2AMLogic/sg13g2-ldo/sim/ldo-cmos5l-pvt-sweep/README.md

# ldo-cmos5l-pvt-sweep

Per `CLAUDE.md`: **verification is the product, no claim without a
testbench**, PVT corners on every recorded result, and results here are
**append-only evidence** -- a re-run mints a new, timestamped record; nothing
under `records/`, `netlist-snapshots/` or `corners/` is ever edited or
deleted after it lands. This follows the same per-experiment shape
`sim/README.md` establishes and `sim/pass-device-screening/` already uses on
the SG13G2 branch.

## What this is

The **first circuit-level (closed-loop) PVT verification** in this repo, on
either PDK branch. `sim/pass-device-screening/` characterizes `sg13_hv_pmos`
as a bare device; this experiment instantiates the actual
`design/sg13cmos5l/ldo_core_cmos5l.sch` netlist (issue #20: pass device +
real two-stage Miller-compensated OTA error amp) and verifies it against a
spec table re-derived at SG13CMOS5L's rails -- phase 3/4 of the SG13CMOS5L
port tracked by #12 (issue #21).

**This block sits entirely on the Challenge #6 brief's 3.3V analog rail**
(`design/README.md` "Rails and the Challenge #6 slot budget" -- every
device is an HV, 3.3V-class flavour; there is no 1.2V node anywhere in this
hierarchy), so "re-derived at this PDK's 1.2V/3.3V rails" reduces to
re-deriving the SG13G2-branch DRAFT table (`README.md`) at the same 3.3V
input / 1.8V output pair, on this PDK's own devices -- not a rail
translation.

## Benches

Three testbenches, generated from templates by `run_sweep.sh`:

1. **`testbench/tb_dcsweep_cmos5l.spice.tmpl`** -- closed-loop, whole
   `ldo_core_cmos5l` instantiated directly (no flattening). A single nested
   DC sweep (`Vin` 2.00V-3.63V step 10mV, fast/inner axis; `Iload`
   0/12.5m/25m/37.5m/50m A, 5 evenly-spaced points, slow/outer axis) gives:
   - **Iq**: `|i(vin)|` at the `Iload=0` block, `Vin=3.30V` row.
   - **Dropout @ 50mA**: scan the `Iload=0.05A` block from `Vin=3.63V`
     downward for the first point where `VOUT` falls below 99% of the
     1.8V target; `dropout = that Vin - 1.8V`. If regulation is never lost
     across the whole swept range, dropout is reported as
     `> 1.63V` (worse than the sweep's own floor, `dropout_v_50ma_floor`
     in the CSV) rather than fabricated.
   - **Line regulation**: `Iload=0` block, slope of `VOUT` vs `Vin` over
     the Input row's own `{2.97V, 3.63V}` window -- measured at no load,
     not the light-nonzero-load point an earlier draft of this bench
     planned (see the template header for why: Iq itself is only ~17uA and
     does not meaningfully load the divider/pass device differently).
   - **Load regulation**: `Vin=3.63V` (best-case headroom) rows across all
     five `Iload` points -- see "Why Vin=3.63V for load regulation" below.
   - **Feedback-divider standing current** (since issue #31):
     `|i(vdivsense)|` at the `Iload=0` block, `Vin=3.30V` row, plus the
     per-leg resistance it implies. Read off a non-invasive replica of the
     divider -- an ideal unity-gain VCVS copy of `VOUT` driving a
     byte-identical pair of `rhigh` legs through a 0V ammeter -- because
     ngspice cannot report a branch current inside a subcircuit instance
     whose device is an OSDI `r3_cmc`. The replica draws nothing from
     `VOUT` and sits on a disjoint node set, so `Iq` and every other
     measured quantity stay directly comparable to the #21/#25 records.
2. **`testbench/tb_loopgain_cmos5l.spice.tmpl`** -- loop broken at `FB`
   (the feedback-divider node driving the amp's `INP` pin, a MOSFET gate)
   for an AC phase/gain-margin sweep. See "Loop-gain measurement method"
   below for the full derivation of why a plain series voltage-source break
   is valid here (no inductor/capacitor blocking network needed).
3. **`testbench/tb_psrr_cmos5l.spice.tmpl`** -- closed-loop, whole
   `ldo_core_cmos5l`, 1V AC stimulus on `Vin` (`Vref`'s AC component held
   at 0), `PSRR_dB(f) = -20*log10(|v(vout)/v(vin)|)`.

All three share: `VREF=0.90V` DC (the schematic's own illustrative bias,
`design/README.md` "Reference voltage" -- `Rtop=Rbot` by construction gives
`FB=VOUT/2`, so `0.90V` servos `VOUT` to `1.80V`; since #28 both legs are
the same drawn PDK `rhigh`, so that ratio is exactly 1/2 independent of
sheet rho and therefore of the resistor corner), `IBIAS` externally sunk at
`2uA` (the bias point `design/README.md`'s "Judgement calls" section 1
assumes: tail=2x, second stage=4x that reference), `Cout=1uF` (a first-cut
point inside the DRAFT table's `0.33-4.7uF` output-cap window, `ESR=0`).

## Loop-gain measurement method

Breaking a feedback loop for a SPICE AC loop-gain measurement normally
needs an L/C blocking network (a large inductor across the break to
preserve the DC operating point, a large capacitor in series with the AC
injection source to avoid disturbing it) -- **not needed here**, because the
break point (`FB` -> the amp's `INP` pin) sits at a MOSFET gate: zero DC or
AC current flows across it, both before and after the break.

Insert an ideal series source `Vbreak` (`0V` DC, `AC=1`) between `FB` (the
real feedback-divider node, resistively determined by `VOUT`) and `FBAMP`
(the node that actually drives the amp's `INP` pin). Because:

- `FBAMP` carries zero current (its only two connections are `Vbreak` and
  a MOSFET gate), the current through `Vbreak`'s branch is zero at both
  ends, so `FB`'s value is unaffected by the break -- `FB = beta * VOUT(s)`
  exactly as in the unbroken circuit (`beta` = the divider ratio); and
- `VOUT(s) = G(s) * FBAMP(s)` for some forward transfer function `G(s)`
  encompassing the whole amp + pass-device path (`VREF`'s AC component is
  held at 0, so it does not contribute),

algebra gives `FB(s) = T(s) * FBAMP(s)` for the identical loop-gain
transfer function `T(s) = beta * G(s)` an unbroken loop would have --
independent of the injection detail. `T(s)` is therefore read directly off
one AC analysis as the ratio of two node voltages:

```
Loop Gain L(s) = -v(fb)/v(fbamp)
```

(sign flipped from the raw `T(s)` so a healthy negative-feedback loop shows
a large **positive** real `L(0)`, phase near 0 degrees at DC, rolling
toward -180 degrees at the unity-gain crossover -- the standard Bode-plot
convention `phase margin = 180 + phase(L)` at the frequency where `|L|=1`
(0dB) is stated against). Verified against a fully independent circuit
simulator run before committing to this method: the closed-loop DC
operating point (`tb_dcsweep_cmos5l`) and the flattened, loop-broken DC
operating point agree to 5 significant figures (`VOUT=1.800208V` both ways
at `tt/27C`, no load), confirming the break does not perturb the bias
point.

`XMpass`/`XRtop`/`XRbot`/`Xamp`'s instantiation lines in
`tb_loopgain_cmos5l.spice.tmpl` are a byte-for-byte mirror of
`ldo_core_cmos5l`'s subckt body in the generated design netlist (`FB` ->
`FBAMP` on `Xamp`'s first pin, plus the inserted `Vbreak`, excepted).
`run_sweep.sh`'s `assert_loopgain_topology_sync()` diffs the two every run
and aborts loudly if a future schematic edit changes that connectivity, so
this bench cannot silently go stale.

## Why Vin=3.63V for load regulation

The schematic's provisional `Mpass` sizing (`w=300u l=0.5u`,
`design/README.md`: "a DC-sanity first cut ... not sized against any
dropout ... target") does **not** hold regulation at 50mA at every `Vin` in
this sweep -- see "Results" below. `Vin=3.63V` (the best-case, max-headroom
supply point) is the *only* point in the grid where the design stays in or
near regulation across the full load range at most corners, so it is the
cleanest available load-regulation measurement; it is not the nominal
3.30V supply datasheets conventionally use, and that departure is
deliberate, not an oversight.

## PDK pin, corner naming, and the resistor/cap corner axes

Pinned SG13CMOS5L revision: [`sim/pdk-cmos5l.json`](../pdk-cmos5l.json)
(commit `607e18d`, re-verified against the installed checkout, matching the
commit issue #21's body cited). `cornerMOShv.lib` at this pin is **byte-for-
byte identical** to `ihp-sg13g2`'s own copy (`diff` clean) -- confirming,
directly against the installed model library rather than by assumption,
that the five-corner naming scheme (`mos_tt`/`mos_ss`/`mos_ff`/`mos_sf`/
`mos_fs`) `spec/porting-plan.md` Sec 1.2 already bound for SG13G2 transfers
unchanged to SG13CMOS5L. This is expected, not coincidental:
`design/README.md` "Install shape is a dispatch hazard" already documents
that this PDK's HV device symbols and model cards are relative symlinks
into a sibling `ihp-sg13g2` checkout.

**`cornerRES.lib` and `cornerCAP.lib` do NOT share this five-corner scheme**
-- both use a three-point `{typ, bcs (best case), wcs (worst case)}` axis,
independent of the MOS process corner.

**Resistor corner: crossed in full since issue #31.** Every `(MOS corner,
temperature)` point is run against all three of `res_typ`/`res_bcs`/
`res_wcs`, giving a 45-point main grid. The axis is swept *independently* of
the MOS corner rather than correlated to it: **no established
MOS-corner/R-corner correlation convention exists in this repo** (an
`ss`-process-correlates-with-`res_wcs` mapping would need its own decision
record, argued on foundry data), and crossing the axes in full reports every
combination instead of inventing one. `DR-0004` ratifies this as the
experiment's standing policy -- a future record that holds the resistor axis
at nominal is a regression against it.

*Why it was not always so, and what that cost:* the `#21` and `#25` records
held the main grid at `res_typ` and characterised the resistor spread
separately at `tt/27C` only, via `loopgain_rzsens_{bcs,typ,wcs}`. That was
defensible when `Rz` was the loop's only `rhigh` and the feedback divider
was a corner-independent behavioural 300k pair -- but the separate
experiment ran at one temperature, and the loop's phase-margin failure needs
`res_bcs` *and* `125C` together. Crossing the axes surfaced it immediately.
The `tt/27C` sensitivity experiment is retained (renamed `res_corner`, since
since #28 it moves the divider as well as `Rz`) as a cross-check on the main
grid's new axis, not as the primary resistor evidence.

**Cap corner** is still held at `cap_typ`, for the different and stronger
reason below: selecting a cap corner on this PDK is a literal no-op.

## MoM-cap (Cc) sensitivity sweep

`cornerCAP.lib` at this pin maps **every** `cap_typ`/`cap_typ_mismatch`/
`cap_typ_stat`/`cap_bcs`/`cap_wcs`/`cap_wcs_mismatch` section to the exact
same nominal `cap_cmomi.lib` include (verified directly, not assumed --
see [`sim/pdk-cmos5l.json`](../pdk-cmos5l.json) `pdk_caveats_honoured`).
Per `cap_cmomi.lib`'s own header, this is because the model is **"NOT YET
VALIDATED ON ihp-sg13cmos5l SILICON"**: its coefficients are transferred
from the SG13G2 characterization by layer count, none measured on cmos5l
silicon. A *process-corner* sweep over `Cc` is therefore a no-op by
construction -- `design/README.md`'s own "PDK caveats honoured" table
already anticipated this and said the sweep this issue owes is a **value**
sensitivity sweep, not a corner sweep.

`run_sweep.sh` generates three frozen copies of the design netlist with
`Cc`'s width scaled `{0.5x, 1x (nominal), 2x}` (capacitance scales
~linearly with area for this device, `l` held fixed) and runs the loop-gain
bench against each, at `tt/27C` (`records/*.sensitivity.csv`,
`sweep=cc_value`). These three points are retained unchanged, and are
row-comparable back to the #21 record -- at #21 they showed phase margin
moving only from `0.35deg` (0.5x) to `0.19deg` (2x), i.e. that the
*near-zero* margin of the original compensation was not an artifact of the
uncharacterized `Cc` value.

**Since issue #35 they are no longer the load-bearing evidence for the
robustness claim, and the `Cc` value-tolerance sweep below is.** They run
at `tt/27C`, which was near this loop's worst case until #31 crossed the
resistor corner and found `res_bcs`/125C (DR-0004). At `tt/27C` every spec
row now passes with tens of degrees and dB to spare, so a `{0.5x,1x,2x}`
sweep there would report PASS at `0.5x` while `0.5x` in fact misses
`PM >= 45deg` at `res_bcs`/125C. Reporting that as evidence of robustness
would be a hollow claim.

### `Cc` value-tolerance window (issue #35)

What the uncharacterized-cap caveat actually needs is a measured answer to
"how wrong may the cap value be, in either direction, before a ratified row
fails" -- so `run_sweep.sh` measures exactly that. `Cc`'s width is swept
across `{85, 110, 130, 170, 220, 259, 340}e-6` at **`ss`/125C**, against
**both** resistor sections that hold a worst case (`res_bcs` for phase
margin, `res_wcs` for gain margin), with **both** the loop-gain and PSRR
benches run at every point. Output:
`records/*.cc-tolerance.csv`, plus a table in the record itself.

`Cc` is bounded on both sides by ratified spec rows, which is why both ends
have to be measured:

- **too small** and the `Rz*Cc` phase-lead zero lands above crossover at
  `res_bcs`/125C (where `Rz` has shrunk to `~0.60x`), failing `PM >= 45deg`;
- **too large** and the Miller-split dominant pole -- and with it the 1 kHz
  loop gain that sets PSRR there -- drops far enough to fail
  `PSRR@1kHz > 50dB`.

At the current `w=170e-6` nominal the measured window is
`110e-6`-`259e-6`, i.e. **x0.65 to x1.52** of nominal with every spec row
still met at both binding corners; `85e-6` (x0.50) fails on phase margin
and `340e-6` (x2.00) on PSRR. Both failing widths are kept in the sweep on
purpose -- a tolerance window with no measured ends is not a tolerance
window. `DR-0005` uses this measurement to place the nominal at the
*geometric centre* of the window rather than at the first value that
passed.

Every phase-margin/loop-gain number in `records/*.csv` is still marked
`insufficient-evidence` per issue #21 acceptance criterion 4 -- the
*absolute* numbers are not independently trustworthy pending real silicon
characterization -- but the qualitative verdict does not depend on that
caveat, and now has a measured tolerance band attached to it rather than an
assertion.

## Results (issue #128, loop-gain sweep to 10 GHz -- current)

Question: DR-0014 could not score any row-10 point because no committed
loop-gain trace bounded its 100 MHz sweep ceiling. Does a higher ceiling
change that? Answer: no. The 10 GHz traces are not bounded either, so all 45
points stay `ambiguous` (`ceiling_unbounded`). No rule, threshold or bound
was changed.

Command (batch only; the host runs no SPICE):

    sim/ldo-cmos5l-pvt-sweep/run_sweep.sh --batch --loopgain-ac-max=10g

`--loopgain-ac-max=<f>` (or `SWEEP_LOOPGAIN_AC_MAX`) is the one input. It
defaults to `100meg`, which renders the historical `ac dec 20 1 100meg`
unchanged. It must be an exact power of ten between 1 kHz and 1 THz above the
fixed 1 Hz floor, with 20 points per decade (`ac_sweep.py`, tested by
`test_ac_sweep.py`). It is rendered into `tb_loopgain_cmos5l.spice.tmpl` as
`@@LG_AC_MAX@@`, and the loop-gain row count is derived from it (201 rows at
10 GHz, 161 at 100 MHz). Every loop-gain trace is also checked for its first
and last frequency, so a wrong-range sweep with the right row count fails
screening. The psrr bench keeps `ac dec 20 1 100meg`. The record md states
the ceiling and row count. `--doe-generate` refuses a non-default ceiling.

Record: [`records/20261011-070111-5391c68.md`](records/20261011-070111-5391c68.md)
and its siblings (same file set as the #89 record). It re-ran the full grid
on the same design netlists (core `08a7b857...bae57`, erramp `75ee39ce...56fb4`)
on the EDA batch fleet: 22 `klt sim` requests, all Spot, none reused, 214/214
points passed, completeness OK. Job ids are in
`corners/20261011-070111-5391c68/_batch/backend.json` (the 45-point main
loop-gain request is `g01_loopgain_tt_-40c_rtyp`, job `klt-sim-a559517f5a05`).
Only the loop-gain traces changed: every DC and PSRR column of the PVT csv is
identical to `20261011-051956-eda9285`, and the item-5 DC summary is
byte-identical. In the PVT csv only `n_0db_crossings` and
`phase_margin_worst_deg` differ, because the extended traces have more
crossings.

Measured, 45 of 45 points (`evidence/20261011-070111-5391c68/row10-margins.*`,
written by `row10_record.py`):

| Quantity | Value |
|---|---|
| Loop gain at 1 GHz | +0.90 to +1.65 dB |
| Loop gain at the 10 GHz ceiling | +0.40 to +1.17 dB |
| Change over the last decade | -0.56 to -0.43 dB |
| Phase at 10 GHz | -14.0 to -11.7 deg |
| 0 dB crossings | 2 at every point (first falling, second rising at 59 to 179 MHz) |
| In-band PM (first crossing) | 53.87 to 76.93 deg |
| In-band GM (one -180 deg crossing) | 13.84 to 29.87 dB |
| PM / GM verdicts | 45 ambiguous / 45 ambiguous, all `ceiling_unbounded` |
| Pass / fail / ambiguous | 0 / 0 / 45 for PM and for GM |

Reading. Above the in-band crossing the loop gain comes back up through 0 dB
at 59 to 179 MHz and then flattens near +1 dB with its phase near 0 deg. It
drifts down only about 0.5 dB per decade, so it would take on the order of 20
more decades to reach -10 dB. The ceiling premise cannot be met by raising
the ceiling further, and 10 GHz is already well beyond any frequency at which this repo
has validated the PSP103, `rhigh` or `cap_cmomi` models, so no higher ceiling
was attempted. The values above 1 GHz are numerically complete traces, not
validated physics, and they are not used for any pass.

What this does not show. The flat, phase-near-zero plateau is the signature
DR-0014 and `tb_loopgain_cmos5l` already name for a single-injection break
at a MOSFET gate, but it was not tested here and the cause is not
established. Only a measured two-injection (Middlebrook/Tian) comparison can
say whether it belongs to the circuit or to the measurement. That bench is
filed as separate work; it was not built here.

## Results (issue #89, G1 disable pull-down)

Record cited: [`records/20261011-051956-eda9285.md`](records/20261011-051956-eda9285.md),
with its [`.csv`](records/20261011-051956-eda9285.csv),
[`.sensitivity.csv`](records/20261011-051956-eda9285.sensitivity.csv),
[`.cc-tolerance.csv`](records/20261011-051956-eda9285.cc-tolerance.csv),
[`.delta.csv`](records/20261011-051956-eda9285.delta.csv) and
[`.divider-attribution.csv`](records/20261011-051956-eda9285.divider-attribution.csv).
`214/214` points passed and the completeness matrix is OK, all on the EDA
batch fleet. The design under test adds an `EN` pin to `ldo_erramp_cmos5l`
and an inverter plus a 1 x 1 um NMOS pull-down on `G1`, so `Mn3` is off
when disabled (DR-0008 addendum "G1 disable pull-down"). Core sha256
`08a7b857...bae57`, erramp `75ee39ce...56fb4`; both are stated in the record
md. `EN` is tied to `VIN`, so the pull-down is off in every bench.
`BASELINE_CSV` moved to the #67 record `20261010-025634-60a3e81`, so the
delta table isolates the three added devices.

The added devices change the enabled state by small amounts, all in the
expected direction. Phase margin, gain margin and PSRR @ 100 kHz fall at
every point and no-load Iq rises or stays the same. The largest change per
metric:

| Metric | Largest change vs 60a3e81 | Point |
|---|---|---|
| Phase margin | -0.0021 deg | `sf`/-40C/`res_wcs` |
| Gain margin | -0.0086 dB | `ss`/-40C/`res_wcs` |
| Unity-gain frequency | +8.0 Hz | `ff`/-40C/`res_wcs` |
| DC loop gain | -2.0e-5 dB | `ff`/125C/`res_wcs` |
| PSRR @ 1kHz | -1.1e-5 dB | `fs`/-40C/`res_typ` |
| PSRR @ 100kHz | -1.6e-4 dB | `sf`/125C/`res_wcs` |
| Iq, no load | +0.043 nA | `ff`/125C/`res_wcs` |
| VOUT, no load | -0.84 uV | `ff`/125C/`res_typ` |

Dropout is identical at every point. Line and load regulation move by at
most 1.5e-5 mV/V and 5.7e-7 %. All 45 points still meet every row in the
record's own spec comparison table. That table uses the legacy first-crossing
PM/GM scalars, and it is not the row-10 verdict. Under DR-0014 (proposed),
row 10 PM and GM are each 45 `ambiguous`, 0 pass and 0 fail (reason
`ceiling_unbounded`), the same as for `60a3e81`. The evidence is
`evidence/20261011-051956-eda9285/row10-margins.*`, written by
`row10_record.py`. Each row's worst case is at the same point as
before, the same 15 points have more than one 0 dB crossing, and the `Cc`
tolerance window is unchanged at `110e-6`-`259e-6`. The worst gain margin
is now 13.84 dB (was 13.85) and the worst phase margin 53.87 deg.

Four of the 22 fleet requests (`g00_dcsweep`, `g01_loopgain`,
`g02_loopgain_ressens_bcs`, `g21_loopgain_divattr`) reuse completed reports
from an interrupted first submission (`SWEEP_BATCH_REUSE_WORK`, listed in
`corners/20261011-051956-eda9285/_batch/reused-reports.tsv`). The other 18
were resubmitted.

**Reuse is now bound to input bytes, but these four are not.** The request
text names the design netlist, the model cards and the OSDI binaries by path,
so a byte-identical request alone does not show those files are unchanged.
`batch_backend.py` now writes `inputs.sha256.json` into every group dir when
the group is written: the sha256 of the transitive `.include` / `.lib`
closure of `tb.spice` and `corners.lib` (design netlist included) plus the
OSDI binaries. `--reuse-work` reuses a report only when the earlier group's
inventory equals the current one, and fails closed when the earlier work dir
has none. `test_batch_backend.py` has the negative controls: an in-place edit
of the design netlist, a nested include, a model card or an OSDI binary, with
all four compared text files left identical, is not reused. The earlier work
dir for this record predates the inventory, so the four reports above have no
committed proof of the input bytes they ran against. Indirect evidence
(PM, GM and Iq differ from `60a3e81` at the points of those groups) says they
are post-edit, but it does not prove it. Closing that gap is a fleet
resubmission of those four groups without `--reuse-work`, appended as new
evidence rather than an edit to this record; it is tracked in a follow-up
issue and is not done here.

The disabled state is not part of this grid. It is in
`sim/ldo-cmos5l-enable/` (DC smoke, tt/27C) and in the off-state samples of
the startup record `20261011-031426-df3f802` (`startup_offstate.py`, all 135
points); see the DR-0008 addendum.

## Results (issue #67, `EN` interface -- superseded by #89 above)

Record cited: [`records/20261010-025634-60a3e81.md`](records/20261010-025634-60a3e81.md),
with its [`.csv`](records/20261010-025634-60a3e81.csv),
[`.sensitivity.csv`](records/20261010-025634-60a3e81.sensitivity.csv),
[`.cc-tolerance.csv`](records/20261010-025634-60a3e81.cc-tolerance.csv),
[`.delta.csv`](records/20261010-025634-60a3e81.delta.csv) and
[`.divider-attribution.csv`](records/20261010-025634-60a3e81.divider-attribution.csv).
`214/214` simulation points passed and the completeness matrix is OK. This is
the first record made with `run_sweep.sh --batch`: every point ran on the EDA
batch fleet, none on the dispatch host (see "Batch backend" below).

The design under test is the #67 core with the active-high `EN` port
(DR-0008), with `EN` tied to `VIN` in all three benches. The core netlist is
sha256 `7953b25b...222cc1` and the erramp is unchanged (`7982d728...c8e38c`).
The record md states both hashes. The before/after/delta table is now
against the last pre-`EN` record, `20260917-023832-7061e8f` (the #35 record
below), at the same `(MOS corner, temperature, resistor section)` point on
both sides.

**The enable devices change nothing measurable in the enabled state.** The
largest change at any of the 45 points is:

| Metric | Largest change vs 7061e8f | Point |
|---|---|---|
| Phase margin | -0.015 deg | `ff`/-40C/`res_wcs` |
| Gain margin | -0.023 dB | `ss`/27C/`res_typ` |
| Unity-gain frequency | -6.7 Hz | `ff`/125C/`res_wcs` |
| DC loop gain | -0.0015 dB | `ff`/125C/`res_typ` |
| PSRR @ 1kHz | -0.0010 dB | `ff`/125C/`res_bcs` |
| PSRR @ 100kHz | -0.0008 dB | `ff`/125C/`res_wcs` |
| Iq, no load | -0.43 nA | `ff`/125C/`res_bcs` |
| VOUT, no load | -0.46 uV | `ff`/125C/`res_wcs` |

Dropout, line regulation and load regulation are unchanged to the printed
precision. All 45 points meet every row in the spec comparison table, and
the same 15 points have more than one 0 dB crossing as before. The `Cc`
tolerance window is unchanged at `110e-6`-`259e-6` (x0.65-x1.52). The binding
points are the same as in the #35 worst-corner summary below. A few ranges
under #35 move in the last printed digit: phase margin is now
53.87-76.93 deg (was 76.94 at the top), gain margin 13.85-29.87 dB (was
13.87-29.89; the worst point, `ff`/-40C/`res_wcs`, keeps a 3.85 dB margin),
and PSRR @ 100kHz 33.23-36.99 dB (was 37.00 at the top). Every other figure
there is unchanged to the digits shown.

What this record does **not** cover: the disabled state (`EN` low), which is
the single-corner smoke evidence in `sim/ldo-cmos5l-enable/` (DR-0008); any
layout, DRC, LVS or extraction of the `EN`-bearing design (#68); and the
Monte Carlo bench, which still instantiates the five-port core (#88).

## Batch backend (`run_sweep.sh --batch`, PR #87)

Dispatch hosts do not run SPICE grids locally. `--batch` keeps every part of
the harness (decks, screening, post-processing, record) and changes one step:
the simulator runs on the EDA batch fleet. `batch_backend.py` turns each
generated per-point deck into a `klt sim --backend batch` request. Its
docstring has the full translation. Points with the same body share one
request (214 points in 22 requests).

- `.lib` cards go into a generated `corners.lib` section, staged with
  `options.stage_model_inputs` from the local PDK install. The
  `.options temp=` line becomes klt's temperature axis.
- **OSDI.** The runner image lacks `cap_cmomi`, and the runner's klt 0.5.0
  ignores `options.osdi_preload` (klayout-tools#2901). The six local OSDI
  binaries are therefore staged with every job through `osdi_preload`, and a
  body-level preamble loads them with `pre_osdi inputs/<name>.osdi`. Every
  per-point log prints their sha256, and `corners/<id>/_batch/backend.json`
  lists them. The backend refuses to run if a runner ever applies
  `osdi_preload` itself, which would load each binary twice.
- **Data.** The deck's `wrdata` vectors are rebuilt from the corner's ASCII
  rawfile (`options.waveforms`). Loop gain and PSRR are recomputed from the
  complex node voltages with the templates' own `let` expressions, which must
  match the known text exactly. The output is written in `wrdata`'s
  `% .8e` layout, so `dc_metrics.py`, `item5_evidence.py` and the inline
  post-processing read it unchanged.
- **Validated byte-for-byte.** Six points (all three benches at `tt`/27C/
  `res_typ` and `ss`/125C/`res_bcs`) were run through the backend against
  the pre-#67 templates and netlist. They reproduced the local ngspice-46
  files of record `20260917-023832-7061e8f` exactly. See
  [`backend-validation/20261010-025044/`](backend-validation/20261010-025044/README.md).
- **Sparse corner sets and per-point lines (issue #64).** A request's
  (section, temperature) pairs no longer have to form a cross product. The
  pairs nobody asked for go into klt's `exclude` list, which the 0.5.0
  runner honours. `--variant-lines REGEX` moves matching body lines
  (the DoE's `Iload`/`Cout`/`Resr`) verbatim into each point's own
  `corners.lib` section, so decks that differ only in those lines share one
  request. Only the `--doe-generate --batch` path passes it. The main grid's
  plan is unchanged: 214 points in 22 requests, none of them excluded. The
  results were cross-checked byte for byte on the fleet; see
  [`backend-validation/20261010-variant-lines/`](backend-validation/20261010-variant-lines/README.md).
- A failed submission is reported, and its points are screened as FAILED.
  The backend never falls back to a local ngspice run.
- Provenance for each record is in `corners/<id>/_batch/`: one directory per
  request with `request.json`, `tb.spice`, `corners.lib`, the klt
  `report.json` (`environment.remote.job_id`) and the exact `*.corner.cir`
  each point ran. Rawfiles (~1 MB per corner) are not committed.
  `SWEEP_BATCH_PLAN_ONLY=1 run_sweep.sh --batch` prints the request plan
  without submitting anything.

## Results (issue #35, `Cc` re-compensation -- superseded by #67 above, numerically unchanged)

**Every ratified spec row is met at every one of the 45 grid points.** The
`res_bcs`/125C phase-margin gap #31 found is closed by a single-parameter
change to the error amplifier's Miller cap -- `Cc` `w` `100e-6` ->
`170e-6`, with `Rz`, both bias mirrors, `Mpass` and every other device
unchanged. Full lever study (including the two rejected levers, `Rz` and
the bias mirrors, both measured over the full grid), the derivation of the
value from the measured `Cc` pass window, and the one row that pays for it:
[`spec/decision-records/DR-0005-sg13cmos5l-cc-recompensation.md`](../../spec/decision-records/DR-0005-sg13cmos5l-cc-recompensation.md).

Record cited: [`records/20260917-023832-7061e8f.md`](records/20260917-023832-7061e8f.md),
with [`.csv`](records/20260917-023832-7061e8f.csv) (45-point PVT x resistor
grid), [`.sensitivity.csv`](records/20260917-023832-7061e8f.sensitivity.csv),
[`.cc-tolerance.csv`](records/20260917-023832-7061e8f.cc-tolerance.csv) (new
-- see "`Cc` value-tolerance window" above),
[`.delta.csv`](records/20260917-023832-7061e8f.delta.csv) and
[`.divider-attribution.csv`](records/20260917-023832-7061e8f.divider-attribution.csv).
`214/214` simulation points passed; completeness matrix OK.

### Spec table at this record

Before/after is against the #31 record at the **same** `(MOS corner,
temperature, resistor section)` on both sides -- same benches, same PDK
pin, same ngspice build -- so the deltas isolate the `Cc` change and
nothing else.

| Parameter | Target | #31 (before) | #35 (this record) | Verdict |
|---|---|---|---|---|
| Output accuracy | 1.8V +/-2% | 1.80023V-1.80066V | 1.80023V-1.80066V | **PASS** (unchanged) |
| Dropout @ 50mA | < 300mV worst corner | 0.20V-0.24V | 0.20V-0.24V | **PASS** (unchanged) |
| Line regulation | < 5 mV/V | 0.162-0.246 mV/V | 0.162-0.246 mV/V | **PASS** (unchanged, no-load only -- see caveat) |
| Load regulation | < 1% over full load | 0.0076%-0.025% | 0.0076%-0.025% | **PASS** (unchanged) |
| Iq, no load | < 30uA | 21.72uA-24.72uA | 21.72uA-24.72uA | **PASS** (unchanged) |
| PSRR @ 1kHz | > 50dB | 58.20dB-61.87dB | 53.64dB-57.37dB | **PASS**, margin down 4.56dB -- the cost, see below |
| PSRR @ 100kHz | > 20dB | 32.58dB-36.81dB | 33.23dB-37.00dB | **PASS** (slightly improved) |
| Stability: phase margin | >= 45 deg worst corner | 43.35deg-73.25deg (**FAIL** 5/45) | 53.87deg-76.94deg | **PASS** (was FAIL) |
| Stability: gain margin | >= 10dB worst corner | 13.83dB-29.76dB | 13.87dB-29.89dB | **PASS** (unchanged) |
| Current limit | 65-80mA brickwall | n/a | n/a | **not implemented** |
| Startup | monotonic ramp, <2% within 3ms | n/a | n/a | **not implemented** |
| Enable/shutdown | -- | n/a | n/a | **not implemented** |

"Unchanged" on the first five rows is meant literally, and that is a result
rather than luck: `Cc` carries no DC current, so every DC-sweep metric (Iq,
dropout, line and load regulation, output accuracy) and the loop's DC gain
are analytically invariant under any change to it. Checked cell by cell
against the #31 CSV: `vout_no_load_v`, `dropout_v_50ma`,
`line_reg_mv_per_v`, `load_reg_pct`, `i_divider_a` and `r_divider_leg_ohm`
are byte-identical at all 45 points, while `iq_a` differs by at most
`1e-13 A` and DC loop gain by at most `0.0004 dB` -- the DC solve's own
numerical noise. Had any of them moved by a physically meaningful amount,
something other than `Cc` would have changed.

### The one row that pays

Worst-corner PSRR @ 1kHz falls `4.56dB`, from `58.20dB` to `53.64dB`
against a `50dB` row -- from `8.2dB` of margin to `3.6dB`. A larger Miller
cap lowers the dominant pole, and the loop gain at 1 kHz *is* what rejects
supply ripple there. This is not a late discovery: it is the bound that set
the value (`DR-0005` decision (b)), and it is why `Cc` is `170e-6` rather
than the `220e-6`-`259e-6` that would have bought another 5-8 degrees of
phase margin. **PSRR @ 1kHz is now the second-tightest row on this block**,
behind gain margin's `3.87dB`; anything that lowers the dominant pole
further has to be checked against it first.

### Worst-corner summary, all 45 points

| Row | Worst value | Binding point | Margin |
|---|---|---|---|
| Phase margin | 53.87deg | `ss`/125C/`res_bcs` | +8.87deg |
| Gain margin | 13.87dB | `ff`/-40C/`res_wcs` | +3.87dB |
| PSRR @ 1kHz | 53.64dB | `ss`/125C/`res_wcs` | +3.64dB |
| PSRR @ 100kHz | 33.23dB | `ff`/27C/`res_bcs` | +13.23dB |
| Iq, no load | 24.72uA | `ss`/125C/`res_bcs` | +5.28uA |
| Dropout @ 50mA | 0.24V | `ss` @ 125C | +60mV |

`res_wcs` was checked explicitly, because a fix that trades one resistor
corner for another is the obvious way to pass this gate dishonestly: phase
margin improves at `res_wcs` too (`tt`/125C: `62.87deg` -> `71.30deg`), and
gain margin -- the row `res_wcs`/cold holds the worst case on -- improves
marginally rather than degrading.

### What changed in the harness

- **New `Cc` value-tolerance experiment** (see above): 7 widths x
  `{res_bcs,res_wcs}` x `{loopgain,psrr}` = 28 points at `ss`/125C, written
  to `records/*.cc-tolerance.csv`. Point count per run goes `186` -> `214`.
- **Before/after/delta re-baselined** from the #25 record to the #31 one,
  and re-keyed on `(corner, temperature, res_section)`. The #25 record held
  the resistor axis at `res_typ`, so it has no `res_bcs`/`res_wcs` rows to
  compare against -- and `res_bcs`/125C is precisely the point at issue.
  The metric list also widened from five metrics to every spec row.
- **`Cc`'s nominal width is now a single `CC_NOMINAL_W` variable**, used by
  both the sensitivity substitution and its FATAL guard, so the two cannot
  drift apart when the value moves again.

## Results (issue #31, PDK `rhigh` divider + full resistor-corner cross -- superseded in part by #35 above)

> **Superseded in part.** This record's Finding 1 (the `rhigh` divider
> conversion is harmless) stands unchanged and is not re-litigated. Its
> Finding 2 -- `PM < 45deg` at `res_bcs`/125C -- is the gap issue #35
> closed; see "Results (issue #35)" above and `DR-0005`. The tables below
> are what this run measured and are not retro-edited.

**The `rhigh` divider conversion is harmless, as #28 predicted. Crossing the
resistor corner, which this run did for the first time, found something
else: phase margin misses the ratified `>= 45deg` row at `res_bcs`/125C, at
all five MOS corners.** Full argument, mechanism, options considered and the
decision not to relax the spec:
[`spec/decision-records/DR-0004-sg13cmos5l-resistor-corner-stability.md`](../../spec/decision-records/DR-0004-sg13cmos5l-resistor-corner-stability.md).

Record cited: [`records/20260916-210331-9d3ace1.md`](records/20260916-210331-9d3ace1.md)
(run manifest, before/after/delta tables, the mechanical spec gate, and the
divider-attribution table), with
[`records/20260916-210331-9d3ace1.csv`](records/20260916-210331-9d3ace1.csv)
(45-point PVT x resistor grid),
[`.sensitivity.csv`](records/20260916-210331-9d3ace1.sensitivity.csv),
[`.delta.csv`](records/20260916-210331-9d3ace1.delta.csv) and
[`.divider-attribution.csv`](records/20260916-210331-9d3ace1.divider-attribution.csv).
`186/186` simulation points passed; completeness matrix OK.

### What changed in the harness

This is the first run against the post-#28 design netlist, and the first to
sweep `cornerRES.lib` across the whole grid rather than holding it at
`res_typ`:

- **Resistor corner crossed in full**: `{tt,ss,ff,sf,fs} x {-40,27,125}C x
  {res_typ,res_bcs,res_wcs}` = 45 points x 3 benches. Every point id, every
  snapshot filename and every CSV row names its own section, so no reader
  has to infer which corner produced a number. The axis is swept
  *independently* of the MOS corner, not correlated to it -- this repo still
  has no ratified correlation convention, and crossing in full reports every
  combination rather than inventing one.
- **Divider standing current measured per point**, from a non-invasive
  replica in `tb_dcsweep_cmos5l.spice.tmpl`: an ideal unity-gain VCVS copy
  of `VOUT` driving a byte-identical pair of `rhigh` legs through a 0V
  ammeter. It loads neither `VOUT` nor `i(vin)`, so `Iq` stays directly
  comparable to the #21/#25 records.
- **Divider attribution sweep**: the loop-gain bench re-run at all 45 points
  with the divider swapped *back* to the pre-#28 behavioural 300k pair and
  everything else held identical, so `Rz`'s corner spread cancels and what
  is left is the conversion's own contribution.
- **Mechanical spec gate**: the record now evaluates the root `README.md`
  spec table against its own CSV, so a record cannot claim a PASS its data
  contradicts.
- **`Warning: singular matrix` is no longer treated as a failure.** ngspice
  emits it while walking its own convergence-aid ladder and then reports
  `Dynamic gmin stepping completed` and a converged result; 9 of this grid's
  points do so (the #21/#25 runs never did -- the `rhigh` divider adds
  internal nodes to the DC solve). They are counted and named in the record
  rather than discarded. To keep this from being a net loosening, the pass
  criterion also gained a *positive* check it never had: every point must
  have written exactly the row count its own analysis statement implies.

### Finding 1: the divider conversion itself is harmless

Measured, not argued -- the attribution sweep above, across all 45 points:

| Metric | Worst contribution of the `rhigh` conversion |
|---|---|
| Phase margin | `-0.53deg` (at `ff`/-40C/`res_wcs`); `>= -0.31deg` at `res_typ` |
| Gain margin | `+/-1.16dB` |
| DC loop gain | `-0.19dB` |
| PSRR @ 1kHz | below display resolution at `res_typ` |

At the five points that miss the phase-margin spec, the conversion's
contribution is `+0.00deg` to `+0.01deg` -- it is not a contributor there.

What the conversion does change is the divider's own standing current: a
corner-independent `3.00uA` before (an ideal 600k across 1.8V) becomes
`1.97uA`-`4.82uA` across the PVT x resistor grid. Total no-load `Iq` moves
from `21.87-22.98uA` to `21.72-24.72uA` -- still inside the `30uA` spec at
every point.

### Finding 2: PM < 45deg at `res_bcs`/125C

| MOS corner @ 125C | `res_bcs` | `res_typ` | `res_wcs` |
|---|---|---|---|
| `tt` | **43.93deg** | 54.91deg | 62.87deg |
| `ss` | **43.35deg** | 54.35deg | 62.42deg |
| `ff` | **44.48deg** | 55.45deg | 63.31deg |
| `sf` | **44.19deg** | 55.18deg | 63.09deg |
| `fs` | **43.65deg** | 54.64deg | 62.65deg |

Five of 45 points, short by `0.5deg`-`1.7deg`. Every other spec row passes
at all 45 points. `Rz` -- not the divider -- is the mechanism: at
`res_bcs`/125C its sheet rho (`1020/1360` = `0.75x`) and its temperature
coefficient (`tc1=-2300e-6` over `98K` => `0.795x`) compound to `~0.60x`,
moving its nulling zero up in frequency so the phase boost arrives too late
at crossover. Gain margin is *best* at exactly that point (`29.76dB`),
which is the signature of a zero that moved rather than a loop that lost
gain; `res_wcs` moves the same knob the other way and improves phase margin.

No earlier record could have caught this: #21/#25 held the main grid at
`res_typ` and swept the resistor corner at `tt`/27C only, where `res_bcs`
costs `8.4deg` and still passes comfortably (`59.98deg`). The failure needs
the resistor corner *and* 125C together.

**The spec is not relaxed.** Per CLAUDE.md, the `PM >= 45deg` row stands as
ratified; DR-0004 records the narrowed verdict and defers re-compensation to
its own issue rather than changing `Cc`/`Rz` inside a verification run.

### Spec table at this record

| Parameter | Target | #25 (pre-conversion, `res_typ` only) | #31 (this record, 45-point grid) | Verdict |
|---|---|---|---|---|
| Output accuracy | 1.8V +/-2% | 1.80023V-1.80064V | 1.80023V-1.80066V | **PASS** |
| Dropout @ 50mA | < 300mV worst corner | 0.20V-0.24V | 0.20V-0.24V | **PASS** |
| Line regulation | < 5 mV/V | 0.162-0.245 mV/V | 0.162-0.246 mV/V | **PASS** (no-load only -- see caveat) |
| Load regulation | < 1% over full load | 0.0076%-0.025% | 0.0076%-0.025% | **PASS** |
| Iq, no load | < 30uA | 21.87uA-22.98uA | 21.72uA-24.72uA | **PASS** |
| Divider standing current | (not a spec row; part of Iq) | 3.00uA, corner-independent by construction | 1.97uA-4.82uA | n/a (newly measurable) |
| PSRR @ 1kHz | > 50dB | 58.21dB-61.85dB | 58.20dB-61.87dB | **PASS** |
| PSRR @ 100kHz | > 20dB | 33.82dB-35.28dB | 32.58dB-36.81dB | **PASS** |
| Stability: phase margin | >= 45 deg worst corner | 54.40deg-72.72deg | 43.35deg-73.25deg | **FAIL** at 5/45 points, all `res_bcs`/125C -- see DR-0004 |
| Stability: gain margin | >= 10dB worst corner | 17.07dB-25.87dB | 13.83dB-29.76dB | **PASS** |
| Current limit | 65-80mA brickwall | n/a | n/a | **not implemented** |
| Startup | monotonic ramp, <2% within 3ms | n/a | n/a | **not implemented** |
| Enable/shutdown | -- | n/a | n/a | **not implemented** |

The MoM-cap (`Cc`) `insufficient-evidence` caveat below still applies to
every loop-gain and margin number in this table, unchanged: `cornerCAP.lib`
maps every section to the same nominal `cap_cmomi` model at this PDK's pin.
The `Cc`-value sensitivity sweep was re-run at this record
(`sweep=cc_value`: phase margin `56.72deg`-`76.24deg` at `tt`/27C over the
`0.5x`-`2x` width range), and, as before, the qualitative verdict does not
depend on that caveat.

### PDK observation: `rhigh`'s symbol expression and its model disagree by 4.35%

This record's directly-measured per-leg divider resistance is **313.5 kOhm**
at `res_typ`/27C. `rhigh.sym`'s own `value` expression -- the source of the
`300.44 kOhm` figure `design/sg13cmos5l/ldo_core_cmos5l.sch`'s header and
`design/README.md` both quote -- gives `300.44 kOhm`. The difference is the
width offset applied twice: `resistors_mod.lib`'s `rhigh` subckt narrows the
width once (`weff = w - 0.04e-6`) and hands `W=weff` to the `r3_cmc` model
card, whose own `xw=-0.04` narrows it again. Every `rhigh` on this branch is
affected, `Rz` included (1.700 MOhm by the expression, `~1.774 MOhm` as
simulated). It is **not** a change introduced here -- the #21/#25 records
simulated the same model -- so no earlier result moves; see DR-0004's
"Separate observation" section.

## Results (issue #25, post-resize -- superseded in part by #31 above)

> **Superseded in part.** This section's evidence remains valid for what it
> measured -- the `res_typ` slice of the grid, against the pre-#28
> behavioural divider. Its "every spec row passes at every corner" headline
> does **not** survive the resistor-corner cross issue #31 ran: see
> "Results (issue #31)" above and DR-0004. The sizing and compensation
> topology DR-0003 ratified are unchanged and still correct everywhere
> except `res_bcs`/125C.

**Every spec row now passes at every corner.** Issue #25 resized `Mpass`
and re-derived the error-amp's `Cc`/`Rz` compensation network and bias
currents against the pre-resize evidence below (full derivation:
[`spec/decision-records/DR-0003-sg13cmos5l-mpass-resize-and-compensation.md`](../../spec/decision-records/DR-0003-sg13cmos5l-mpass-resize-and-compensation.md)),
then re-ran this same unmodified harness against the resized schematic.

Record cited: [`records/20260916-112842-c25ff53.csv`](records/20260916-112842-c25ff53.csv)
(main 15-point PVT grid) and
[`records/20260916-112842-c25ff53.sensitivity.csv`](records/20260916-112842-c25ff53.sensitivity.csv)
(Cc-value / Rz-corner sensitivity) -- see
[`records/20260916-112842-c25ff53.md`](records/20260916-112842-c25ff53.md)
for the full run manifest. `51/51` simulation points passed (ngspice exit
0, no convergence/model-load errors); completeness matrix OK.

| Parameter | Target | Before (#21, pre-resize) | After (#25, this record) | Verdict |
|---|---|---|---|---|
| Output accuracy | 1.8V +/-2% | 1.80022V-1.80040V | 1.80023V-1.80064V | **PASS** |
| Dropout @ 50mA | < 300mV worst corner | 1.29V-1.83V, 4/15 corners never regulate | 0.20V-0.24V (worst `ss/125C`), all corners regulate | **PASS** (was FAIL) |
| Line regulation | < 5 mV/V | 0.151-0.200 mV/V | 0.162-0.245 mV/V | **PASS** (no-load only -- see caveat below) |
| Load regulation | < 1% over full load | 0.021%-248%, 4/15 corners fail | 0.0076%-0.025% | **PASS** (was FAIL) |
| Iq, no load | < 30uA | 16.94uA-16.99uA | 21.87uA-22.98uA | **PASS** (higher due to raised bias currents, still well under target) |
| Iq, full load | < 30uA | not separable from the dropout failure | 23.05uA-23.08uA | **PASS** (newly measurable and passing) |
| PSRR @ 1kHz | > 50dB | 65.9dB-69.3dB | 58.21dB-61.85dB | **PASS** (reduced margin -- see DR-0003 "PSRR trade-off") |
| PSRR @ 100kHz | > 20dB | 35.8dB-40.6dB | 33.82dB-35.28dB | **PASS** |
| Stability: phase margin | >= 45 deg worst corner | 0.19deg-0.35deg | 54.40deg-72.72deg | **PASS** (was FAIL) |
| Stability: gain margin | >= 10dB worst corner | 4.0dB-5.4dB | 17.07dB-25.87dB | **PASS** (was FAIL) |
| Current limit | 65-80mA brickwall | n/a | n/a | **not implemented** (`design/README.md` "Known gaps": no current-limit circuit exists on this branch) |
| Startup | monotonic ramp, <2% within 3ms | n/a | n/a | **not implemented** (no soft-start circuit) |
| Enable/shutdown | -- | n/a | n/a | **not implemented** (no `EN` pin on this branch) |

Cc-value (`0.5x`-`2x` nominal) / Rz-corner (`res_bcs`/`res_typ`/`res_wcs`)
sensitivity, re-swept at the new nominal, `tt/27C`: phase margin
56.9deg-76.4deg, gain margin 18.6dB-23.5dB across both sweeps -- the PASS
verdict holds across the full sensitivity range tested, mirroring the
same "verdict does not depend on the uncharacterized `Cc` value" reasoning
the pre-resize FAIL verdict established (`cornerCAP.lib` still maps every
corner/mismatch/stat section to the same nominal `cap_cmomi` model at this
PDK's pin, so the *exact* numbers above remain `insufficient-evidence`
pending real CMOS5L MoM-cap silicon characterization, even though the
qualitative PASS verdict does not depend on that caveat).

**Line-regulation caveat**: measured at no load only (see "Benches" above
for why) -- unchanged from the pre-resize record.

No spec row required relaxation to reach this result, per CLAUDE.md's rule
that verification results are never relaxed to pass.

## Results (issue #21, pre-resize -- historical, kept for evidence provenance)

**This section is preserved unmodified as the append-only record of the
first verification pass** (`sim/` results are append-only evidence per
CLAUDE.md) -- the sizing it describes no longer matches the current
schematic; see "Results (issue #25, post-resize)" above for the current
state.

Record cited throughout: [`records/20260916-083154-7aa1d3f.csv`](records/20260916-083154-7aa1d3f.csv)
(main 15-point PVT grid) and
[`records/20260916-083154-7aa1d3f.sensitivity.csv`](records/20260916-083154-7aa1d3f.sensitivity.csv)
(Cc-value / Rz-corner sensitivity) -- see
[`records/20260916-083154-7aa1d3f.md`](records/20260916-083154-7aa1d3f.md)
for the full run manifest (PDK/ngspice versions, corner matrix, links).
`51/51` simulation points passed (ngspice exit 0, no convergence/model-load
errors); completeness matrix OK.

**Headline finding: the schematic's provisional sizing (both `Mpass` and
the error-amp's `Cc`/`Rz` compensation network, both explicitly flagged as
DC-sanity first cuts, never sized against a target, in `design/README.md`)
does not hold up under closed-loop PVT verification.** This is the expected
outcome of a first verification pass on unratified sizing, not a surprise
finding, and it is recorded here in full per CLAUDE.md's rule that
verification results are never relaxed to pass.

### Spec table, re-derived at this PDK's 3.3V analog rail

Verdict legend: **PASS** (met at every corner in the 15-point grid),
**FAIL** (missed at one or more corners, worst-corner value cited),
**insufficient-evidence** (the PDK caveat this row's own value depends on
has not been resolved yet), **not implemented** (no such circuitry exists
in this schematic increment -- `design/README.md` "Non-goals" / "Known
gaps").

| Parameter | Target (`README.md` DRAFT, port-parity baseline) | Result (this record) | Verdict |
|---|---|---|---|
| Output accuracy | 1.8V +/-2% | 1.80022V-1.80040V no-load, all corners (regulator-only, `VREF` ideal -- port-parity caveat, `spec/porting-plan.md` Sec 1.2) | **PASS** |
| Dropout @ 50mA | < 300mV worst corner | 1.29V-1.83V at 11/15 corners; **never reaches regulation** within the swept `Vin` range (> 1.63V) at `tt/125C`, `ss/27C`, `ss/125C`, `fs/125C` | **FAIL** (every corner; ~4-6x over target even at the best corner) |
| Line regulation | < 5 mV/V | 0.151-0.200 mV/V, no load, all corners | **PASS** (no-load only -- see caveat below) |
| Load regulation | < 1% over full load | 0.021%-248% at `Vin=3.63V` (best-case headroom); 11/15 corners stay under 1% (0.02%-0.63%) with comfortable margin, but the same 4 corners that never reach dropout regulation (`tt/125C`, `ss/27C`, `ss/125C`, `fs/125C`) also fail here (25%-248%) | **FAIL** (4/15 corners; worst-corner value governs the row verdict) |
| Iq, no load | < 30uA | 16.94uA-16.99uA, all corners | **PASS** |
| Iq, full load | < 30uA | not cleanly separable from the load-regulation failure above (several corners never reach a stable 50mA operating point to measure quiescent draw against) | **insufficient-evidence** |
| PSRR @ 1kHz | > 50dB | 65.9dB-69.3dB, all corners | **PASS** |
| PSRR @ 100kHz | > 20dB | 35.8dB-40.6dB, all corners | **PASS** |
| Stability: phase margin | >= 45 deg worst corner | 0.19deg-0.35deg (Cc-value and Rz-corner sensitivity range included), all corners/points tested | **FAIL** (every corner; essentially zero margin) -- **insufficient-evidence** on the exact number (MoM-cap `Cc` caveat), but the FAIL verdict itself does not depend on that caveat (see "MoM-cap sensitivity sweep" above) |
| Stability: gain margin | >= 10dB worst corner | 4.0dB-5.4dB, all corners/points tested | **FAIL** (every corner) -- same insufficient-evidence caveat on the exact number as phase margin |
| Current limit | 65-80mA brickwall | n/a | **not implemented** (`design/README.md` "Known gaps": no current-limit circuit exists on this branch) |
| Startup | monotonic ramp, <2% within 3ms | n/a | **not implemented** (no soft-start circuit) |
| Enable/shutdown | -- | n/a | **not implemented** (no `EN` pin on this branch) |

**Line-regulation caveat**: measured at no load only (see "Benches" above
for why); the DRAFT target does not itself specify a load point for this
row, but a load-dependent line-regulation number cannot be produced
honestly given the load-regulation failure already documented -- this is
noted rather than silently omitted.

### Binding corners

- **Dropout**: worst among the corners that do reach regulation is
  `sf/125C` (1.83V dropout), `fs/27C` (1.82V) close behind; four corners
  never reach regulation at all within the swept range and are strictly
  worse.
  Slow-and-hot corners (matching `sim/pass-device-screening`'s own binding-
  corner finding for the bare `sg13_hv_pmos` device) dominate, as expected.
- **Load regulation**: `ss/125C` is catastrophic (248% -- `VOUT` collapses
  to `-2.67V` at `Vin=3.63V`/`Iload=50mA`, a real consequence of driving an
  ideal current-sink load harder than the pass device can supply at this
  corner, not a simulation artifact -- independently reproduced in a
  standalone `.op` run outside the sweep).
- **Stability**: phase margin is essentially flat (~0.19-0.35 degrees)
  across every corner and every Cc/Rz sensitivity point tested -- this is
  not a corner-dependent marginal case, it is a compensation network with
  no margin budget at any point tested.

## Why this is still a useful record, not a wasted run

Per `spec/porting-plan.md` Sec 1.3's own framing (gf180-ldo's compensation
work took ten decision records of negative results before the loop was
actually stable across PVT), a first verification pass finding real gaps in
unratified, explicitly-provisional sizing is the expected, useful outcome
-- it is the concrete input the next sizing pass needs (implied pass-device
widths from `sim/pass-device-screening`'s own dropout data already
independently predicted this: `sim/pass-device-screening/records/20260909-220347-ed18110.csv`'s
`w1u_l0.5u` rows imply `1135um-2169um` for `300mV`/`50mA`, 4-7x the
schematic's drawn `300um` -- this experiment's closed-loop dropout failure
is consistent with, and adds circuit-level confirmation of, that earlier
bare-device finding).

#25 is the resizing pass this evidence motivated (`Mpass` width, and the
`Cc`/`Rz` compensation network) -- see "Results (issue #25, post-resize)"
above for the outcome; it was out of scope for this original
verification-only phase, and is captured in full in
[`DR-0003`](../../spec/decision-records/DR-0003-sg13cmos5l-mpass-resize-and-compensation.md).

## T1 item 5 evidence derivation and coverage inventory (issue #55)

`item5_evidence.py` re-derives, with no simulator and no PDK, from the
committed raw DC grids of record `20261010-025634-60a3e81`
(`corners/20261010-025634-60a3e81/dcsweep_*_dc.csv`, 45 independent MOS x
temperature x resistor points; the `EN` design, PR #87). Until #67 it read
record `20260917-023832-7061e8f`. That record's outputs under
`evidence/20260917-023832-7061e8f/` are kept unchanged as history.

- the record's own DC columns (it **fails** if they do not reproduce, so the
  raw grid and the committed record CSV cannot silently disagree);
- informational summaries the record never reported: full-load Iq (load
  current excluded: `|i(Vin)| - Iload`, Vin = 3.30 V), line regulation at each
  of the five swept loads, load regulation at 2.97 / 3.30 / 3.63 V. A value is
  *valid* only if both end points are within 1 % of 1.8 V; invalid, truncated
  or missing points stay in the counts;
- a ten-row coverage inventory against DR-0007.

```bash
python3 sim/ldo-cmos5l-pvt-sweep/item5_evidence.py           # write
python3 sim/ldo-cmos5l-pvt-sweep/item5_evidence.py --check   # byte-compare (CI)
python3 sim/ldo-cmos5l-pvt-sweep/item5_grid.py --check       # same, shared grid contract (CI)
python3 -m unittest discover -s sim/ldo-cmos5l-pvt-sweep -p 'test_*.py' -v
```

Grid completeness (#120): the live sweep and this analysis apply one
contract, `dc_grid.validate_file`. It checks for exactly five Iload blocks, each
with the full 2.00..3.63 V / 10 mV Vin sequence, and requires every value to be
finite. `item5_evidence.py` is pinned by sha256 in its own landed outputs, so
it is not edited. Instead, `item5_grid.py` rebinds its `split_blocks` to the
shared validator and runs it unchanged, which yields the same bytes. CI runs
both checks.

Outputs: `evidence/20261010-025634-60a3e81/{coverage-inventory.json,
coverage-inventory.md,dc-informational-summary.csv}`; inputs and their sha256
are listed in the JSON. `dc_metrics.py` is the DC parser extracted from
`run_sweep.sh`'s inline Python so both read the grid identically.

What this is **not**:

- It is not a `klt sim` envelope and item 5 in `signoff/` stays uncited.
  The raw grid now comes from `klt sim` batch requests (`run_sweep.sh
  --batch`), but those requests declare no limits, and the metrics are
  reduced outside klt, so they are measurement runs, not a corner-matrix
  envelope graded against the ratified spec. `klt sim`'s batch backend still
  refuses `models.pdk: ihp-sg13cmos5l`
  ([klayout-tools#2727](https://github.com/2AMLogic/klayout-tools/issues/2727)),
  so the runs rely on staged model inputs instead.
- It does not ratify any Open row. Only row 4 (dropout) is ratified, and its
  dropout is the **legacy** metric (lowest in-regulation grid Vin minus the
  fixed 1.8 V target); 36 of 45 points sit at the 0.20 V sweep floor and are
  upper bounds. The conventional `Vin - actual VOUT at 1 % loss` figure
  (informational column in the CSV; 0.2546 V at the worst resolved point) is
  not adopted: that definition is #70's. The SG13G2 branch has no closed-loop
  evidence (#71) and nothing here transfers to it.
- Full-load Iq resolution: the grid is printed to 9 significant digits, so
  Iq at 50 mA is quantized at 1e-10 A; ngspice's own convergence noise on a
  22 uA difference of two ~50 mA currents is not bounded beyond that floor
  by this data.
- Provenance: the record's git sha (`60a3e81`, a PR #87 branch commit) may
  not resolve after a squash merge. main's #64 changes were merged into the
  branch afterwards, and regenerating all 214 decks with the merged harness
  gives decks that are identical apart from comments. The snapshots `.include` the design by absolute worktree path. The record md does state both design netlist
  sha256 values, so netlist freshness is recorded for this record. (For the
  older `7061e8f` record it was inferred from the DR-0007 hash pins.)
  `run_sweep.sh`'s spec comparison table now labels every row's
  DR-0007 status (only dropout is a gate; the rest are informational); this
  affects future records only, existing records are unchanged.

## CI

**No CI job runs `run_sweep.sh --check-env` for this experiment yet**, unlike
`sim/pass-device-screening-check` (SG13G2 branch). `.github/workflows/ci.yml`
fetches `ihp-sg13g2` via `klayout-tools`' pinned `fetch-ihp-sg13g2.sh`; no
equivalent pinned fetch exists for `ihp-sg13cmos5l` in CI, because (per
`design/README.md` "Known gaps") it is a separate upstream repository
(`IHP-GmbH/ihp-sg13cmos5l`), not a variant directory inside the
IHP-Open-PDK tarball that script downloads -- already filed upstream as
`2AMLogic/klayout-tools#1929`. Until that lands, `--check-env` for this
experiment (like `--check` for the SG13CMOS5L schematic branch generally)
is a local/manual step, verified by this PR's author before submission
(see "Reproducing" below).

The separate, offline loop-gain topology guard **is** a CI gate (issue #94):
the `characterization-report` job runs
`sim/ldo-cmos5l-pvt-sweep/run_sweep.sh --check-topology-guard` on every
push/PR/manual run, with no `continue-on-error`. It exits before PDK and
ngspice setup, so it needs neither. It checks that the flattened core mirrored
in `testbench/tb_loopgain_cmos5l.spice.tmpl` (including `XMen`/`XMbdis`) still
matches the exported `ldo_core_cmos5l` netlist, then that each built-in
negative control mutation is rejected, so both connectivity drift and a
weakened guard fail CI. It writes no records, changes no signoff verdict, and
makes no PVT or spec-passing claim. It does not replace the missing PDK-backed
`--check-env` preflight described above, which remains local/manual.

## Reproducing

```bash
export PDK_ROOT=/path/to/pdk/parent   # containing BOTH ihp-sg13g2/ and ihp-sg13cmos5l/
PDK=ihp-sg13cmos5l sim/tools/build-osdi.sh   # one-time OSDI build for this PDK
sim/ldo-cmos5l-pvt-sweep/run_sweep.sh --batch   # dispatch hosts: every point on the batch fleet
sim/ldo-cmos5l-pvt-sweep/run_sweep.sh           # workstation with ngspice >= 46: local loop
sim/ldo-cmos5l-pvt-sweep/run_sweep.sh --check-env   # syntax-check only, no records written
```

`--batch` needs `klt` (client 0.7.0 was used for record
`20261010-025634-60a3e81`) with batch-fleet credentials, plus the six OSDI
binaries built locally. They are staged, not loaded, on the submitting host,
so its own ngspice version does not matter.

Requires `ngspice >= 46` (OSDI ABI v0.4, see `sim/README.md`) and both
`ihp-sg13g2`/`ihp-sg13cmos5l` installed under the same `PDK_ROOT`
(`design/README.md` "Install shape is a dispatch hazard").

## Dynamic DoE: load x Cout x ESR (issue #64)

**Status: the 384-run matrix and one round of midpoint refinement (688
more runs) have been run on the EDA batch fleet. This is exploratory
evidence. It does not ratify or change DR-0007 rows 3, 6 or 10, and it makes
no monotonicity or continuous-window claim.** The records are
`20261010-091123-a31c626` (base matrix) and `20261010-101245-6df50fd`
(refinement, analysed together with the base). See "What was actually run
for #64" below for the results, the failures and the limits.

The runs go through `run_sweep.sh --doe-generate --batch`, which uses the
same staged-model-input batch path as the main grid (see "Batch backend"
above). `klt sim` still refuses `models.pdk: ihp-sg13cmos5l` on its batch
backend
([klayout-tools#2727](https://github.com/2AMLogic/klayout-tools/issues/2727)).
That route is not needed here.

### What this is (and is not)

DR-0007 leaves rows 3 (load), 6 (PSRR) and 10 (stability) Open because the
committed dynamic evidence is a single operating point: 1 mA, 1 uF, 0 ohm ESR.
The target window is 0-50 mA, 0.33-4.7 uF effective Cout, 0-500 mohm ESR.
This DoE is **exploratory**. It reports measured extrema and trends at sampled
discrete points only. It does not prove monotonicity, does not bound the
continuous window, does not cover unsampled PVT corners, and does not
interpolate between levels.

### Matrix

| axis | levels |
|---|---|
| load | 0, 1, 25, 50 mA |
| effective Cout | 0.33, 1.0, 2.2, 4.7 uF |
| ESR (series with Cout) | 0, 250, 500 mohm |

= 48 operating points, at each of four PVT/resistor corners taken from the
DR-0007 evidence at `4d45f5d` (2026-10-10; re-derive from the current record
before relying on them):

| corner | why |
|---|---|
| `ss` / 125 C / `res_bcs` | phase-margin binding |
| `ff` / -40 C / `res_wcs` | gain-margin binding |
| `ss` / 125 C / `res_wcs` | PSRR @ 1 kHz binding |
| `ff` / 27 C / `res_bcs` | PSRR @ 100 kHz binding |

Both benches (loop gain, PSRR) at every point: 4 x 48 x 2 = **384** AC
simulations before refinement. Failed or missing points stay in the
completeness accounting.

Targets (informational comparison only): PM >= 45 deg, GM >= 10 dB, PSRR @ 1 kHz
> 50 dB, PSRR @ 100 kHz > 20 dB.

### Parameterisation

`tb_loopgain_cmos5l` and `tb_psrr_cmos5l` take `@@LOAD_A@@`, `@@COUT_F@@`,
`@@COUT_BOTTOM@@` and `@@ESR_LINE@@` through `run_sweep.sh`'s `gen_netlist`
(optional args 9-11; the defaults 1 mA / 1u / 0 ohm render the legacy lines).
ESR is a series resistor `Resr` from a private node `COUT_ESR` to ground with
`Cout` between `VOUT` and that node. ESR = 0 wires `Cout` straight to ground and
emits a comment: no zero-valued resistor is ever written. Load 0 renders
`Iload VOUT 0 dc 0`.

Operating-point values are exact integers in base units (uA, nF, mohm) so
formatting cannot collide IDs. Point IDs:
`<bench>_dyn_<mos>_<temp>c_r<res>_i<uA>ua_c<nF>nf_e<mohm>mohm`, shared by the
snapshot netlist, the `corners/` AC CSV and log, and the record row.
`dynamic_doe.py` rejects negative load/Cout/ESR, zero Cout, non-numbers and
values that are not integral in base units; the plan fails on ID collisions.
The AC parsers were extracted verbatim from this script into `ac_metrics.py`
(one interpretation for the legacy post-processing and the DoE). The
`assert_loopgain_topology_sync` check is unchanged.

### Reproduction

```
# base matrix: 384 netlists, 2 klt sim batch requests (one per bench), then analyse + refine
sim/ldo-cmos5l-pvt-sweep/run_sweep.sh --doe-generate --batch
# one refinement round: only the requested midpoints, analysed with the base record
SWEEP_BATCH_MAX_POINTS=115 SWEEP_BATCH_CONCURRENCY=3 \
  sim/ldo-cmos5l-pvt-sweep/run_sweep.sh --doe-generate --batch \
    --doe-extra=$PWD/sim/ldo-cmos5l-pvt-sweep/records/<base>.dynamic-doe.refine.json \
    --doe-only-extra --doe-base=<base>
sim/ldo-cmos5l-pvt-sweep/run_sweep.sh --doe-generate  # generate-only: netlists + manifest, NO simulation
python3 sim/ldo-cmos5l-pvt-sweep/dynamic_doe.py plan  # bench, id, mos, res, temp, load, cout, esr
```

`--doe-generate` renders `netlist-snapshots/<record>/*.spice` through the
same `gen_netlist` as the main grid. It writes
`records/<record>.dynamic-doe.manifest.tsv`, with one row per point: netlist
path and sha256, the invocation, repo git sha, PDK and ngspice version. With
`--batch`, the invocation names the `klt sim` request that ran the point,
`corners/<record>/_batch/<group>/request.json`.
`corners/<record>/_batch/points.tsv` maps each point to its request and its
klt process/temperature corner, and `_batch/backend.json` holds the job ids.
Without `--batch` the command stops after generation and never launches
ngspice.

Under `--batch`, `batch_backend.py` gets `--variant-lines
'^(Iload|Cout|Resr) '`. The DoE decks differ only in those lines, so they
move into each point's own `corners.lib` section and every bench runs as
one request. The other route was one request per operating point, which on
the shared fleet cost about 12 min of instance overhead for about 25 s of
simulation. The cross-check is in
[`backend-validation/20261010-variant-lines/`](backend-validation/20261010-variant-lines/README.md).
`SWEEP_BATCH_MAX_POINTS` caps the points per request, and
`SWEEP_BATCH_CONCURRENCY` caps the requests in flight (default 2). A request
the fleet's concurrency cap refuses is re-submitted to the fleet for up to
an hour, because klt's own `capacity_wait_s` does not cover that refusal
(klayout-tools#2917). Nothing falls back to a local run.

After the batch run, `run_sweep.sh` runs:

```
python3 sim/ldo-cmos5l-pvt-sweep/dynamic_doe.py analyse corners/<record> [corners/<base>] \
  [--extra refine.json] \
  --legacy-record records/20260917-023832-7061e8f.csv \
  --legacy-record records/20261010-025634-60a3e81.csv \
  --out-prefix records/<record>.dynamic-doe
python3 sim/ldo-cmos5l-pvt-sweep/dynamic_doe.py refine corners/<record> [corners/<base>] \
  [--extra refine.json] --out records/<record>.dynamic-doe.refine.json
```

`analyse` writes two files and exits non-zero unless the matrix is complete:

- `<prefix>.csv`: one row per corner x load x Cout x ESR, with status,
  failure reasons, `origin` (base or refine, with the reason) and `source`
  (the corners directory the row was read from).
- `<prefix>.md`: completeness, extrema with full coordinates versus the
  targets, target misses per corner, the legacy comparison, refinement
  requests and the per-slice trigger table.

Failures are missing or truncated AC output (not 161 rows), no unity-gain
crossover, no -180 degree crossing (gain margin unmeasured) and non-finite
values. A failed row still contributes the metrics it did measure to the
extrema and to refinement. For example, a trace with no -180 degree crossing
keeps its phase margin and PSRR.

### Legacy regression

The 1 mA / 1 uF / 0 ohm point is compared on parsed metrics with the committed
record `20260917-023832-7061e8f.csv` (#35, pre-EN netlist) and with the
current main-grid record `20261010-025634-60a3e81.csv` (#67, EN design, batch
fleet). The tolerance is |delta| <= 0.10 deg for PM and <= 0.10 dB for GM,
PSRR @ 1 kHz and PSRR @ 100 kHz. A miss is reported and explained, never
overwritten.

**Result (record `20261010-091123-a31c626`): all four corners are within
tolerance against both records.** Against `7061e8f` the largest differences
are |dPM| 0.0149 deg (ff/-40C/res_wcs), |dGM| 0.0223 dB (ss/125C/res_bcs) and
|dPSRR| 0.0007 dB. These are the EN interface's own effect, which #67 reported
as "numerically unchanged". Against `60a3e81` every difference is 0.0000:
same design, same fleet ngspice-46, same reduction.

### Refinement rule

Add adjacent midpoints on the changing axis (other axes and the corner fixed)
when a selected point fails a target, or a metric is non-monotonic along a
one-dimensional slice, or the slice's worst point is interior (strictly below
both endpoints). `refine` emits those requests (intervals with no integral
midpoint are listed as unrefinable, not dropped); re-run `--doe-generate
--batch --doe-extra=FILE --doe-only-extra --doe-base=<base>` for them. A run
that fires no trigger must say so with the per-slice table; no endpoint-only
or monotonicity claim without that support.

The rule has no stopping condition. Every round adds levels, and those
levels can fire new triggers. One round was run for #64. The second-round
requests it produced are recorded, not run (see below).

### What was actually run for #64

Every simulation ran on the EDA batch fleet: `klt sim --backend batch`,
runner klt 0.5.0, ngspice-46, Spot `c6i`/`c7i`/`m7i` instances. Job ids are
in each record's `corners/<record>/_batch/backend.json`. No local ngspice
grid was run.

| record | what | sims | klt requests | screening |
|---|---|---|---|---|
| `20261010-091123-a31c626` | base matrix: 4 corners x 48 points x 2 benches | 384 | 2 (`klt-sim-90c2614832a7`, `klt-sim-4742f4a08f98`) | 384/384 passed |
| `20261010-101245-6df50fd` | refinement round 1: 344 midpoints x 2 benches | 688 | 6 | 688/688 passed |

The recorded run count is 384 + 688 = 1072. That equals the generated
matrix plus the documented refinement points (`expected_simulations` in
`20261010-101245-6df50fd.dynamic-doe.md`).

**Completeness: not a complete pass.** In the combined analysis (536
operating points) every simulation completed, but **46 rows are `failed`**:
their loop-gain trace has **no -180 degree phase crossing between 1 Hz and
100 MHz**, so gain margin is unmeasured. The base matrix had 14 of these
(`20261010-091123-a31c626.dynamic-doe.md` lists them). All 46 are at loads
of 1 mA or less (29 at 0 mA, 10 at 0.5 mA, 7 at 1 mA) and all have
ESR > 0. These rows keep their phase margin and PSRR in the extrema and in
refinement. They are not reported as passes.

**Extrema (combined, informational, discrete points only):**

| metric | worst sampled value | target | coordinate |
|---|---|---|---|
| PM | -52.70 deg | >= 45 deg | ff/-40C/res_wcs, 50 mA, 0.33 uF, 0 mohm |
| GM | -9.20 dB | >= 10 dB | ff/-40C/res_wcs, 50 mA, 0.33 uF, 0 mohm |
| PSRR @ 1 kHz | 43.55 dB | > 50 dB | ss/125C/res_wcs, 0 mA, 3.45 uF (refinement midpoint), 0 mohm |
| PSRR @ 100 kHz | 24.78 dB | > 20 dB | ss/125C/res_bcs, 50 mA, 1 uF, 0 mohm |

**Target misses (sampled points, combined)**, as misses / points measured:

| corner | PM | GM | PSRR @ 1 kHz | PSRR @ 100 kHz |
|---|---|---|---|---|
| ff/-40C/res_wcs | 77/148 | 63/139 | 0/148 | 0/148 |
| ff/27C/res_bcs | 41/129 | 10/117 | 0/129 | 0/129 |
| ss/125C/res_bcs | 49/130 | 2/116 | 8/130 | 0/130 |
| ss/125C/res_wcs | 43/129 | 15/118 | 16/129 | 0/129 |

Observations at the sampled points. None of these is a claim about the
points in between.

- **Zero load.** All 116 sampled 0 mA points have PM < 45 deg, at every
  corner and every Cout/ESR level (base matrix: 9.1 to 26.9 deg). GM there is
  large (45 dB or more where measured).
- **Heavy load, small Cout, ff/-40C/res_wcs.** At 25 and 50 mA with 0.33 uF
  or 1 uF, PM and GM go to or below zero (PM -52.7 deg, GM -9.2 dB at
  50 mA / 0.33 uF / 0 mohm). At these sampled points the loop has no
  margin. ESR moves PM a lot in this region (50 mA / 0.33 uF: -52.7, -7.5 and
  3.4 deg at 0, 250 and 500 mohm).
- **PSRR @ 1 kHz** misses only at ss/125C, 0 mA, Cout >= 1.6 uF. The worst
  sampled point (43.55 dB at 3.45 uF) is a refinement midpoint, worse than
  both neighbouring base levels (47.34 dB at 2.2 uF, 46.11 dB at 4.7 uF). The
  base matrix alone would have under-reported the miss.
- **PSRR @ 100 kHz** meets its target at every sampled point.
- At ff/-40C/res_wcs every trace has two 0 dB crossings. `phase_margin_deg`
  is the established parser's first-crossing value. The CSV's
  `phase_margin_worst_deg` also gives the worst crossing, and the legacy
  `tt`/-40C rows show the same two-crossing shape.

These are measured misses at a PVT corner that binds, not the result of
the parameterisation. The legacy point reproduces both records exactly or
within tolerance. Whether the window, the spec or the compensation should
change is a DR-0007 question for a separate ratification review. This PR
changes neither.

**Refinement.** The base matrix fired 286 slice-metric triggers across 640
one-dimensional slices (470 monotone). That produced 344 midpoint requests,
all of them run (record `20261010-101245-6df50fd`, `origin` column = the
trigger reasons). Re-deriving over base + refinement fires 644 triggers over
1527 slices. That gives **678 second-round midpoint requests, recorded as
PENDING and not run**
(`records/20261010-101245-6df50fd.dynamic-doe.refine.json`), plus 248
intervals with no integral midpoint, which are listed as unrefinable. With
no stopping condition the request count roughly doubles each round, so a
second round should wait for a stopping rule (for example a minimum interval
width, or refining only target-failure brackets). That rule is a scope
decision for the issue.

**Attempts that did not produce records** (no records, corners or snapshots
were committed for them):

1. One request per operating point (96 requests): stopped after 4 had
   returned, at about 12 min of fleet overhead per 25 s job. This led to
   `--variant-lines`. The 4 returned jobs are reference data in
   `backend-validation/20261010-variant-lines/per-deck/`.
2. Merged requests, first try: the loop-gain job `klt-sim-b6817c79a312` was
   Spot-reclaimed 47 s after it started. Its `status.json` read
   `"state": "interrupted", "detail": "spot reclamation notice received; job did not complete — re-run it"`.
   Nothing re-launched it in the next 80 minutes, and the client polled
   silently the whole time (klayout-tools#2992). The run was stopped and
   resubmitted as a whole.
3. Refinement, first try: 7 of 8 requests were refused at launch with
   `batch-fleet-provision.sh launch failed (exit 1): error: 8 instance(s) already running + 1 requested exceeds BATCH_MAX_CONCURRENT_INSTANCES=8`.
   That refusal is not covered by `capacity_wait_s` (klayout-tools#2917).
   The run was stopped and resubmitted with `batch_backend.py`'s cap retry.

**Earlier probe** (PR #90): record `20261010-032206-4d45f5d`, one local
debug probe of the legacy point at `ss`/125 C/`res_bcs`. It matched
`7061e8f` exactly.

Fixture tests (`test_dynamic_doe.py`, `test_batch_backend.py`) cover:

- generation, validation and parsing;
- completeness, extrema (including partial rows), tolerance and refinement;
- refinement-only plans and multi-record analysis;
- `exclude`/`--variant-lines` request grouping, request chunking and the cap
  retry.

They use synthetic data. Routine CI runs no campaign.

**Not established:** behaviour between sampled levels, at unsampled PVT
corners (only four were run), or below 1 Hz and above 100 MHz. Monotonicity
along any axis is not established. Transient load or line steps are not
covered either. DR-0007 rows 3, 6 and 10 stay Open.

## Startup campaign (issue #69)

Startup measurements for the EN-bearing core (`DR-0008`), child of #62.
**Proposed methodology, not ratified targets.** `DR-0007` row 9 stays
**Open**; the review keys that would close it are not supplied here. Evidence
is schematic-level: no layout, extraction or post-layout claim. The methodology
decisions are written up in
[`DR-0009`](../../spec/decision-records/DR-0009-sg13cmos5l-startup-measurement-methodology.md).

### Files

| File | Role |
|---|---|
| `testbench/tb_startup_cmos5l.spice.tmpl` | Startup bench (klt circuit body). |
| `startup_eval.py` | Deterministic evaluator (stdlib). Fails closed. |
| `test_startup_eval.py`, `test_startup_campaign.py` | Fixture tests (no simulator). |
| `startup_campaign.py` | `plan` / `submit` / `collect` / `recollect` / `binding`. Every simulation is a `klt sim --backend batch` request; nothing runs locally and nothing falls back to local. |
| `startup/<run>/<stage>/<request>/` | Request artifacts: `request.json`, `tb.spice`, `corners.lib`, klt `report.json` (per-corner artifacts, about 2 MB rawfiles each, are git-ignored; their sha256 is in the record CSV). |
| `records/<run>-startup-<stage>.{md,csv,manifest.json}` and `.traces/` | Append-only records: coverage, per-point metrics, trace files with sha256, source/tool/PDK hashes. |

Run `20261011-031426-df3f802` (grid stage only, issue #89) is the record
selected for the characterization report. It is the same campaign re-run on
the G1 disable pull-down design (DR-0008 addendum): 135/135 evaluated, all
fail on overshoot and monotonicity as before, every start settles in
28-441 us. Its `off_supply_current_a` column is sampled inside the `EN`
edge, so for this design it includes the amplifier inverter's crowbar
current. The true off-state supply current (last `EN = 0` sample before the
edge, 2.000-2.264 uA over the 135 points) is read from the committed traces
by `startup_offstate.py <run id>`. The evaluator fix is #130 (below): the
column of the re-collected record `20261011-070146-0c95530` carries that value. The numbers
and binding points in the subsections below are those of the earlier run.

Run `20261010-104827-91e92aa` is the record set the subsections below
describe (the six-pin amplifier). `startup/20261010-075612-91e92aa/`
and the `records/20261010-075612-91e92aa-startup-nominal.*` files are the
earlier diagnostic run (first nominal, two lost grid attempts, probe requests);
they are kept as evidence and are superseded by the later run.

### Contract (as implemented)

- **Bench.** `EN = VIN * CTL` (B-source), so `EN` swings exactly `0 <-> VIN` at
  whatever supply value klt alters `Vin` to. `CTL` is a PWL: 0 until 1 ms,
  1 us edge up, high to 7 ms, 1 us edge down, low to 9 ms, 1 us edge up, high
  to 15 ms. One run therefore contains the cold start, a disable and a
  re-enable. The DC operating point is solved with `EN = 0`; **no UIC**, and
  `VOUT` is not forced to 0.
- **Time zero** of each case is the `EN = VIN/2` crossing (linear
  interpolation). Observation is at least 5 ms (6 ms provided) per case; a
  shorter window is `insufficient`.
- **Load.** Resistive, 1 mA at 1.8 V = 1.8 kohm (50 mA = 36 ohm; load 0 = no
  resistor, output open). A current sink would drag a disabled `VOUT` to an
  unphysical negative value, so none is used. Cout is `cap_typ`-corner ideal
  C, ESR a series resistor (never a 0 ohm element).
- **Band and settling.** Band 1.764-1.836 V. *First band entry* and
  *settling* are reported separately; settling is the last re-entry after
  which the trace stays in band to the end of the window. Unsettled is a
  failure. Row 9 timing: settle <= 3 ms.
- **Monotonic.** Largest downward excursion from the running maximum, from
  time zero until settling (whole window if unsettled). Proposed tolerance
  1 mV; the raw excursion and reversal counts at 0.1 / 1 / 10 mV are reported
  so the tolerance cannot hide a reversal. Overshoot recovering from a peak
  counts as a reversal by this definition; overshoot is also reported
  separately (peak above 1.836 V fails the +/-2 % reading, which is recorded
  for review, not asserted as the meaning of "controlled ramp").
- **Off state (cold start).** Max `|VOUT|` before the first edge must stay
  <= 50 mV (a proposed bound, not a spec); off-state `VOUT` and supply current
  are published. The disable/re-enable case publishes `VOUT` at the start and
  end of the disabled interval and gets the same startup metrics; **instant
  discharge is not required** (no discharge feature exists).
- **Stress.** Max Vsg, Vgd, Vds of `Mpass`, Vsg of `Men`, peak supply current;
  flagged informationally against the `DR-0002` 3.3 V VGS reference. They are
  not a verdict term.
- **Fail closed.** Missing columns, non-finite or non-increasing samples,
  a sample gap above the 1 us timestep cap, a window shorter than 5 ms, a
  missing EN edge, a missing corner/rawfile or a non-converged run all give
  `insufficient`, which is never a pass. Re-enable failures do not change
  `start_pass` but do make the overall verdict not pass.
- **Timestep.** Transient max step 1 us (the EN edge is 1 us); binding points
  rerun at 0.5 us.

### Grid and coverage

| Stage | Requested | Completed | Notes |
|---|---|---|---|
| nominal | 1 | 1 | tt / 27 C / res_typ / 3.30 V / 1 mA / 1 uF / 0 ohm |
| grid | 135 | 135 | MOS {tt,ff,ss,fs,sf} x T {-40,27,125} x res {typ,bcs,wcs} x Vin {2.97,3.30,3.63}; cap_typ; 15 requests (one per MOS/res section, 9 corners each) |
| halfstep | 3 | 3 | binding points at a 0.5 us step cap |
| ext | 24 | 24 | load {0, 50 mA} x Cout {0.33, 4.7 uF} x ESR {0, 0.5 ohm} at each of 3 binding points |

Binding points are chosen by `startup_campaign.py binding` from the grid CSV:
worst start overshoot / settle time / downward excursion / re-enable
overshoot (one point, `ff` 27 C `res_typ` 3.63 V), worst off-state `VOUT`
(`ff` 125 C `res_wcs` 3.63 V), worst pass-gate Vsg (`ss` -40 C `res_typ`
3.63 V). The rule is a heuristic for choosing where to extend, not a proof
that these bound the design.

### Results (all schematic-level; see the `.md` records for the numbers)

- **No point of the 135 passes.** Every point fails on **overshoot** (start
  peak 1.868-2.339 V, i.e. 0.068-0.539 V above 1.8 V, against a +36 mV band
  edge) and on the 1 mV monotonic check (the downward excursion is the
  recovery from that overshoot). Re-enable behaves the same way. The nominal
  point: peak 2.056 V, overshoot 0.256 V, 10-90 % rise 3.1 us.
- The row 9 **timing** part is met everywhere: every start and re-enable
  settles inside the band, in 37-440 us (limit 3 ms). The failure is the
  "controlled ramp" part: with no soft start (DR-0008), the amplifier drives
  `Mpass` fully on when `EN` rises and `VOUT` slams up in about 2-5 us with a
  supply inrush of 0.28-0.77 A.
- **Off state is clean at the 1 mA load:** max `|VOUT|` 0.12 nV - 0.56 mV
  (limit 50 mV); off supply current 1.6 uA - 354 uA across corners (the
  upper end is the floating amplifier node DR-0008 describes, not a
  characterized shutdown current).
- **Stress.** `Vsg(Men)` reaches `VIN` (3.63 V) with `EN = 0` and `Vsg(Mpass)`
  up to 3.627 V during the rise; 45 of 135 points exceed the 3.3 V VGS
  reference of DR-0002 (the 3.63 V supply). Recorded, not judged here.
- **Timestep sensitivity.** Overshoot magnitude is **not step-converged**: at
  the three binding points the 0.5 us run moves overshoot by -0.108, +0.043
  and +0.025 V and the settle time by tens of microseconds. The *verdict*
  (fail) is unchanged at all three and the smallest overshoot margin
  (0.032 V above the band edge) is of the same order as the shifts, so the
  grid's overshoot numbers are indicative magnitudes, not converged values,
  and a point near the band edge could flip with a finer step. A step well
  below the 1 us edge was not run.
- **Load / Cout / ESR extension (24 points):** only 4 pass, all Cout 4.7 uF
  with ESR 0.5 ohm (`ff` 27 C and `ss` -40 C, load 0 and 50 mA). The `ff`
  125 C `res_wcs` point fails at every load/Cout/ESR combination. Cout 0.33 uF
  fails everywhere with 0.41-0.94 V overshoot. At `ff` 27 C, 50 mA, 0.33 uF
  the output **does not settle**: it rings at about +/-32 mV around 1.8 V
  through the observation window. With
  **no load** the overshoot cannot discharge (no sink, high-resistance
  divider): VOUT stays above the band at the end of the window (for example
  2.66 V from a 2.74 V peak) and the point is `unsettled`. At the `ff` 125 C
  `res_wcs` binding point the no-load off-state `VOUT` is 0.19 V, above the
  proposed 50 mV bound (leakage into an open output).
- The bounded set does **not** prove every interior point.

### Limits and unresolved coverage

- **Resistive loads only** (see above); a constant-current load model is not
  measured. Cc tolerance is **unverified**; no Cc axis was added.
- Cap corner is `cap_typ` only; the `cap_typ` section controls the MoM Cc.
- Overshoot values are not step-converged (above); no finer step, no
  `reltol` sensitivity was run.
- The extension covers three binding points chosen from the 1 mA / 1 uF / 0
  ohm grid; other PVT/supply points at other loads were not run.
- The tolerance (1 mV), off-state bound (50 mV) and the +/-2 % overshoot
  reading are proposals for review. No row is ratified.
- Models: the OSDI binaries (including `cap_cmomi`, absent from the runner
  image) are staged from the local build; their sha256 and the PDK pin
  (`sim/pdk-cmos5l.json`, `607e18d4...`, matches the installed checkout) are in
  each manifest. Runner klt 0.5.0 vs client 0.7.0 (version mismatch warning).

### Tool friction found while doing this

- **Parallel transient corners stall** (the run was affected before the
  workaround): with several corners in one batch request every ngspice worker
  stalled to the per-corner timeout (8 of 9 corners; 15 of 15; one 45-corner
  request lost whole to the job timeout). Cause: OpenMP thread oversubscription
  between concurrent ngspice workers on the runner. `set num_threads=1` in the
  body `.control` block (the OSDI preamble) makes the same request run in
  about 2 s per corner. Reported with the evidence as a comment on
  `2AMLogic/klayout-tools#2970`.
- The fleet's concurrent-instance cap refuses submits immediately
  (`BATCH_MAX_CONCURRENT_INSTANCES`) instead of queueing; the driver retries
  on the batch backend after a wait (already tracked as
  `2AMLogic/klayout-tools#2917`).
- The runner's klt 0.5.0 ignores `options.osdi_preload` (known, #2901): the
  OSDI binaries are loaded by the preamble from the staged `inputs/`.

### Cold-start disabled plateau and re-collection (issue #130)

`startup_eval.py` used to take the off-state window and `off_supply_current_a`
from the samples before the `EN = VIN/2` crossing. That crossing is half way up
the 1 us `EN` edge, so the last such sample lay inside the edge (for the #89
design: the crowbar current of the amplifier's `EN` inverter, 6.0-28.3 uA
instead of 2.000-2.264 uA). Time zero of each enable case is unchanged (the
interpolated `EN = VIN/2` crossing). The cold-start disabled window is now the
contiguous run of samples from the start of the trace with `EN <=
off_en_tol_v` (1 mV, a documented numerical tolerance; the bench holds `EN` at
exactly 0 V), cut at the first sample above it (the start of the first rising
ramp, read from the trace: no 1 ms assumption), keeping `t >=
off_window_skip_s`. Off-state `VOUT` max/min/end and `-ivin` at the last
sample use exactly that window. If `EN` does not start disabled or the window
is empty after the skip, the verdict is `insufficient` and no edge sample is
substituted. A missing `ivin` column is still supported (no current column).

Record `20261011-070146-0c95530-startup-grid.*` is the re-collection of
`20261011-031426-df3f802-startup-grid.*` with the new evaluator, made with
`startup_campaign.py recollect --stage grid --rid 20261011-070146-0c95530 --source-rid
20261011-031426-df3f802`: no simulation, the source traces are verified against
their `trace_sha256` and referenced in place (not copied), the manifest carries
the source job/engine/OSDI/PDK provenance and a `recollected_from` block with
the source files' sha256 and both evaluator hashes. All earlier records are
byte-identical. Result: 135 of 135 still `fail` with the same reasons;
`off_supply_current_a` is 2.00000305-2.26401144 uA and equals, point by point,
`-ivin` at the last `EN = 0` sample of each committed trace. The other
metric columns differ from the source record only by the 9-significant-digit
rounding of the reduced traces (relative <= 5e-5, mostly far smaller), not by the window. The off-state `VOUT` columns move because the
window no longer includes ramp samples (up to 11 % of values that stay below
0.48 mV; bound 50 mV; no verdict change).

### Reproducing

```bash
PDK=ihp-sg13cmos5l source sim/env.sh
cd sim/ldo-cmos5l-pvt-sweep
python3 -m unittest test_startup_eval test_startup_campaign
RID=$(date +%Y%m%d-%H%M%S)-$(git rev-parse --short HEAD)
for s in nominal grid; do
  python3 startup_campaign.py plan --stage $s --rid $RID
  python3 startup_campaign.py submit --stage $s --rid $RID --concurrency 3
  python3 startup_campaign.py collect --stage $s --rid $RID
done
python3 startup_campaign.py plan --stage ext --rid $RID --binding records/$RID-startup-grid.csv
python3 startup_campaign.py plan --stage halfstep --rid $RID --binding records/$RID-startup-grid.csv
# then submit + collect ext and halfstep
```

## Row-4 dropout under DR-0012 (issue #70, PROPOSED)

[`DR-0012`](../../spec/decision-records/DR-0012-row4-dropout-measurement.md)
(`proposed`, not ratified; the `< 300 mV` target is unchanged) defines a second,
distinctly named quantity, `dropout_1pct_vin_minus_vout_v`: the interpolated
`Vin*` at which `VOUT` falls to 0.99 x `VOUT(Vin = 3.30 V, 50 mA)`, minus that
threshold (so `VIN - VOUT(actual)`, not `VIN - 1.8 V`), scanning down from
3.30 V on a 5 mV grid from 1.700 V. Each value carries its grid bracket
(`_lower_v`/`_upper_v`); the worst corner is taken on the upper bound.

The legacy `dropout_v_50ma` (lowest regulating 10 mV-grid Vin minus 1.8 V,
floor 2.00 V) and the item-5 `dropout_vin_minus_vout_candidate_v` column are
unchanged historical quantities and are never called "dropout" without the
qualifier. `dropout_metrics.py` holds the new reducer next to `dc_metrics.py`
(not inside it: `item5_evidence.py` pins both files' sha256 in the committed
evidence inventories, which must stay byte-identical).

Reproduce (45-point SPICE grid, so it goes to the EDA batch fleet through
`batch_backend.py` / `klt sim --backend batch`; there is no local fallback):

    python3 sim/ldo-cmos5l-pvt-sweep/dropout_campaign.py run
    python3 sim/ldo-cmos5l-pvt-sweep/dropout_campaign.py reduce <record-id> [--check]

`run` mints a new `<id>` and writes `corners/<id>/`, `netlist-snapshots/<id>/`
and `records/<id>.dropout.{csv,json,md}` (input hashes, klt/ngspice versions,
fleet job ids, completeness accounting). Any failed, truncated, floor-limited
or out-of-regulation point blocks a definitive worst-corner claim. Tests:
`python3 -m unittest sim/ldo-cmos5l-pvt-sweep/test_dropout_dr0009.py`.

Naming: this record was drafted as "DR-0009" and renumbered to DR-0012. The
dropout artifacts in this directory that say `DR-0009` keep that legacy label:
`testbench/tb_dropout_cmos5l.spice.tmpl`, `netlist-snapshots/20261010-111618-19e8e39/`,
`records/20261010-111618-19e8e39.dropout.*`, `test_dropout_dr0009.py`,
`dropout_metrics.py` and `dropout_campaign.py`. They are append-only evidence or
hash-pinned. They belong to DR-0012, not to DR-0009 (the startup measurement
methodology, see "Startup campaign" above).

## Row-10 margins under DR-0014 (issue #126, PROPOSED)

[`DR-0014`](../../spec/decision-records/DR-0014-row10-stability-margin-classification.md)
(`proposed`, not ratified; the `PM >= 45 deg` / `GM >= 10 dB` targets are
unchanged) defines how the phase and gain margins are read from a loop-gain
trace when it has more than one 0 dB crossing or no -180 deg crossing. In
short: every crossing in the sweep counts, and the scored margin is the
minimum. A PM crossing's margin is its angular distance from the critical
point, made negative after an in-band encirclement. A miss inside the sweep
is a fail. A pass also needs the loop gain at the 100 MHz ceiling to be at
least 10 dB below unity and non-increasing over the last decade. Everything
else is `ambiguous`, with a reason.

`ac_metrics.classify_margins` implements it. `loopgain_metrics`, which minted
every record here, is unchanged. The recorded `phase_margin_worst_deg` is
`180 + unwrapped phase`, not a margin; DR-0014 explains the difference.

Offline reclassification of the committed traces (no simulator, no PDK, no
new record):

    python3 sim/ldo-cmos5l-pvt-sweep/row10_margins.py           # (re)write
    python3 sim/ldo-cmos5l-pvt-sweep/row10_margins.py --check   # CI: byte-compare

It writes `evidence/<record-id>/row10-margins.{csv,json,md}` for the
45-point record `20261010-025634-60a3e81` and for the #64 combined record
`20261010-101245-6df50fd` (536 rows). Before it writes anything, every trace
must reproduce the record minted from it, and every recorded PM or GM miss
must classify as `fail`. Result: no committed trace bounds the 100 MHz
ceiling (the loop gain there is -1.17 to +0.53 dB and rising), so no PM or
GM pass can be scored. The 15 legacy two-crossing points and the 46 `failed`
#64 rows are `ambiguous` on GM. On PM, the 15 legacy points are `ambiguous`,
39 of the 46 rows `fail` and 7 are `ambiguous`. The #64 PM and GM misses (210,
90) are unchanged. Tests: `test_ac_metrics.py`, `test_row10_margins.py`.

Later 45-point records (#89). `row10_margins.py` is pinned by sha256 inside
its own landed outputs and names its two datasets in code, so it is not
edited to add a record. `row10_record.py` (the same thin-wrapper pattern as
`item5_grid.py`) runs its unchanged `legacy` logic, with the same trace
layout, cross-checks, no-loosening guard and output format, on another
45-point record. It also pins itself in the output's `classifier` block:

    python3 sim/ldo-cmos5l-pvt-sweep/row10_record.py --record 20261011-051956-eda9285
    python3 sim/ldo-cmos5l-pvt-sweep/row10_record.py --check   # CI: every output it wrote

Issue #128 re-ran the same grid with the loop-gain sweep extended to 10 GHz
(`run_sweep.sh --loopgain-ac-max=10g`, see "Results (issue #128 ...)" above)
and selected `20261011-070111-5391c68`. The result is still 45 `ambiguous`.

For record `20261011-051956-eda9285` (the G1 pull-down design) the result is
the same as for `20261010-025634-60a3e81`. PM and GM are `ambiguous` at all
45 points, all with reason `ceiling_unbounded`. 30 points have one 0 dB
crossing and 15 have two, and those 15 are the same points as before. The
in-band GM is 13.84 to 29.87 dB, and no committed trace bounds the 100 MHz
ceiling (-1.164 to +0.528 dB there, and rising). Tests: `test_row10_record.py`.
