2AMLogic/sg13g2-ldo/sim/ldo-cmos5l-monte-carlo/records/20261012-093854-934dbd7.md

# Record 20261012-093854-934dbd7

- **Experiment**: ldo-cmos5l-monte-carlo, the row-2 campaign of issue #56
  re-run on the **EN design and the re-stamped PDK** (issue #155). It is the
  first row-2 campaign record for the six-port `EN` core; record
  `20261009-003009-3ee8306` (five-port pre-EN core, old pin) stays what it
  is, a historical run of a design that no longer exists.
- **Claim**: with the PDK's own per-instance MOS and `rhigh` mismatch
  switched on, at five process/temperature corners, the committed
  SG13CMOS5L regulator (current EN design, `EN` tied to `VIN`) keeps its
  no-load output (`Vin` 3.30 V, ideal 0.900 V `VREF`) inside the **proposed,
  unratified** row-2 window 1.764–1.836 V in every one of 2000 draws.
  `klt yield` supports ≥ 99.08 % yield at 95 % confidence in each
  population. That figure counts the 18 % of draws whose operating point the
  runner flagged as a recovered solve (see "Convergence"); without them, tt,
  ss_rbcs and fs_rbcs fall to ≥ 98.3–98.9 %. The normal fit puts the mean
  **3.27–3.78 σ** from the nearest limit (Cpk 1.09–1.26). This is
  regulator-only accuracy: reference error is excluded. **Row 2 stays Open**
  and row 8 stays deferred (#63), so T1 item 6 is **not** discharged (see
  "What this record does not show").
- **Design under test**: `design/sg13cmos5l/netlist/ldo_core_cmos5l.spice`
  sha256 `08a7b857e1fad43dd7af1f575de97853a058e85541601ecc47567fbc28dbae57`
  (the #67 `EN` interface and the #89 G1 disable pull-down; it carries
  `ldo_erramp_cmos5l`, standalone copy `ldo_erramp_cmos5l.spice`
  `75ee39ce0c48b54cab6c8a31acd1f199c37c1ccd1ac074a3515dee81cc656fb4`). Every
  raw report's `environment.netlist_closure` pins the live bench
  `tb_row2_accuracy_en.spice` (`6cc1467a…26800`), `runner-preamble.cir`
  (`24a2581f…3e4bf`) and the core netlist by sha256; the committed files hash
  identically.
- **PDK / models**: `ihp-sg13cmos5l` @ `f7bca32694fe3d58be0cc7d9df4b9f5db7161a14`
  (`IHP-Open-PDK` `dev` subtree, `sim/pdk-cmos5l.json`), read from the
  scratch install's `.fetched-version` marker by `sim/env.sh` at submit time
  (`PDK_ROOT` was the scratch fetcher install described in
  `sim/migration-inventory-155.md`, not a host-provisioned tree), with its
  sibling `ihp-sg13g2` 0.3.0. `row2-corners.lib` (`a0b07d8e…59383`) is staged
  with every job; the 13 staged model files of each request (pinned per file
  in `environment.staged_model_inputs`, e.g. `sg13g2_moshv_mismatch.lib`
  `2e9612bd…fed09`, `resistors_mod_mismatch.lib` `f0aa7d90…d1e15`) are
  **byte-identical** to those of record `20261009-003009-3ee8306` in all five
  requests. OSDI: the fleet image's `/opt/pdk/ihp-sg13g2` binaries, hashed into
  every retained log (`psp103.osdi` `2e4299c4…e1fc796`, `r3_cmc.osdi`
  `4fead17b…fce350`), the same binaries the earlier record used.
- **Simulator / tools**: ngspice 46 on the 2AM batch fleet. Runner klt
  `0.5.0`, submitting client klt `0.7.0+gff97d692a147`
  (`runner_version_check: warn`, so every job records
  `runner_compatibility: mismatch`; see the README "Toolchain"). `klt yield`:
  klt `0.7.0+gb82427b30c96` (the repo's signoff-pin source tree) with
  `klt_yield_native` 0.1.0 built from that tree's `native/yield` into a
  scratch venv (klayout-tools#2900; nothing host-wide installed). Run on a
  copy of `20261009-003009-3ee8306`, that klt re-derives every committed
  yield report, `crosscheck.json` and CSV of that record byte for byte, so
  the yield tool vintage does not change a result here.
- **Measurement**: unchanged from the earlier record. `.meas dc vout_v FIND
  v(vout) AT=3.30` over `dc Vin 3.29 3.31 0.01`, 10 significant digits;
  limits inclusive, 1.764 ≤ `vout_v` ≤ 1.836 V (README "Measurement
  definition").

## Requests, seeds, jobs

Submitted with `run_campaign.sh submit` (the documented entry point, which
runs `klt sim request-row2-<name>.json --backend batch` for each request in
turn). Every simulation ran on the fleet; nothing ran on the dispatch host.

| Request | Populations × N | Seed | Fleet job(s) | klt sim status |
|---|---|---|---|---|
| `request-row2-probe.json` (MC off) | tt_nom/27 °C at VREF 0.90 and 0.93 V | n/a | `klt-sim-f659478ba6e3` | fail (exit 3; the 0.93 V point is out of window by design) |
| `request-row2-mc.json` | 5 corners × 400 | 56001 | `klt-sim-24aa55d44a90`, `-cf6803193004`, `-28f1feea8696`, `-bf12f6265b5b`, `-55cca01607df` (`remote.hosts: 5`; 766–1438 s each) | pass, 2000/2000 |
| `request-row2-attribution.json` | 3 × 100 | 56002 | `klt-sim-20d96471b6a0` | pass, 300/300 |
| `request-row2-negctl.json` | tt/27 °C, VREF 0.93 V, × 400 | 56001 | `klt-sim-4ebf1373af57` | fail (exit 3, by design), 400/400 ran |
| `request-row2-repro.json` | tt/27 °C × 50 | 56001 | `klt-sim-7b2a6c3418d9` | pass, 50/50 |

No submission was refused or retried; there is no failed attempt to
disclose. Every draw's `seed` / `process_seed` / `mismatch_seed` is in the
raw reports and in [`20261012-093854-934dbd7.csv`](20261012-093854-934dbd7.csv)
(one row per draw, 2752 rows, nothing filtered). The probe and reproduction
requests keep artifacts; their 52 ngspice logs are retained under
`corners/20261012-093854-934dbd7/`.

## Results per population (`klt yield`, 95 % confidence)

| Population | N | errored / inconclusive | mean (V) | σ (mV) | min … max (V) | A-D normality | empirical yield [95 % CI] | normal-fit yield | Cpk [95 % CI] | σ to spec (limiting side) | sample size | verdict vs planning 0.99 |
|---|---|---|---|---|---|---|---|---|---|---|---|---|
| tt / 27 °C | 400 | 0 / 0 | 1.801151 | 10.662 | 1.767789 … 1.829937 | consistent (0.411) | 1.000 [0.990820, 1] | 0.999213 | 1.089 [1.007, 1.172] | 3.27 (upper) | sufficient | **pass** |
| ss + res_bcs / −40 °C | 400 | 0 / 0 | 1.800613 | 9.357 | 1.768127 … 1.826475 | consistent (0.482) | 1.000 [0.990820, 1] | 0.999877 | 1.261 [1.167, 1.354] | 3.78 (upper) | sufficient | **pass** |
| ff + res_wcs / 125 °C | 400 | 0 / 0 | 1.800541 | 10.356 | 1.770725 … 1.832089 | consistent (0.452) | 1.000 [0.990820, 1] | 0.999482 | 1.141 [1.056, 1.227] | 3.42 (upper) | sufficient | **pass** |
| sf + res_wcs / 125 °C | 400 | 0 / 0 | 1.800987 | 9.638 | 1.775805 … 1.826502 | consistent (0.544) | 1.000 [0.990820, 1] | 0.999798 | 1.211 [1.121, 1.301] | 3.63 (upper) | sufficient | **pass** |
| fs + res_bcs / −40 °C | 400 | 0 / 0 | 1.799761 | 9.763 | 1.765307 … 1.824654 | consistent (0.359) | 1.000 [0.990820, 1] | 0.999772 | 1.221 [1.130, 1.312] | 3.66 (lower) | sufficient | **pass** |

Reports: `20261012-093854-934dbd7/yield/<population>.yield.{json,txt}`, each
beside the sample-set document it was computed from. Exit codes are in
`yield/exit-codes.txt` (0 for the five populations, 3 for the negative
control, whose own verdict is `fail` by design).

**Reading it honestly.** No draw left the window: 2000/2000 pass. The
closest was 1.765306918 V (fs_rbcs/−40 °C, draw 329), 1.31 mV inside the
lower limit. With N = 400 and zero failures the defensible statement per
population is "**at least 99.08 % at 95 % confidence**", not 100 %. That
clears the planning target 0.99, a sample-size design input and not a
ratified yield (README "Seeds, sample size, convergence"). The normal fit
(Anderson-Darling consistent in all five) extrapolates ≈ 120–790 ppm
fallout per population. The evidence supports a 99 %-class claim; it does
**not** support a 3σ (99.73 %) or tighter row-2 yield.

## Comparison with record 20261009-003009-3ee8306 (what changed, what did not)

That record ran the **five-port pre-EN** core (`c6e630e9…`, before #67 and
#89) on the **old** pin `607e18d`. This one runs the current EN core on the
new pin. Seeds are shared draw for draw, so the two can be paired:

- Every one of the 2752 rows has the same seeds and the same pass/fail
  status in both records.
- Per-draw `vout_v` differences: **0 or 1 nV** (the 10th printed digit) in
  every request and population at −40 °C and 27 °C (tt, ss_rbcs, fs_rbcs,
  attribution, negative control, reproduction, probe); up to **1.75 µV**
  (ff_rwcs/125 °C) and **0.64 µV** (sf_rwcs/125 °C) at 125 °C. Every
  population statistic in the table above equals the earlier record's to
  the printed digits except the ff/sf 125 °C means and extremes (≤ 2 µV).
- **Attribution of the difference.** The staged model files are
  byte-identical between the two records (13 of 13 in every request) and the
  OSDI binaries are the same fleet-image binaries, so the PDK re-stamp
  changed no model input to this campaign. The remaining µV-level shift is
  therefore the design change (the #67 `EN` devices and the #89 pull-down,
  which are off but present, and whose leakage is largest at 125 °C), not
  the PDK. This is an inference from the identical model inputs, not a
  separate design-held-constant run: the five-port deck cannot elaborate
  against the current core, and a pre-EN core on the new pin was not run.
- The set of draws the runner flagged as recovered solves **did** change
  (368 of 2000 main draws now, 482 before; see "Convergence"), which also
  points at the netlist rather than the models.

## Cross-checks (`20261012-093854-934dbd7/crosscheck.json`)

- **Sampler negative control** (attribution, `tt_nom`: mismatch off, 100
  distinct seeds): all 100 values are identical, **1.800306041 V**, against
  the committed corner value 1.80030601 V (31 nV). Zero spread holds
  exactly. `klt yield` still misreports this degenerate set as "normality
  rejected, Cpk 1.3e13" (klayout-tools#2909, unchanged); informational only.
- **Attribution at tt/27 °C** (N = 100 each): MOS mismatch only σ = 9.908 mV;
  `rhigh` mismatch only σ = 4.540 mV; RSS 10.90 mV against 10.66 mV for the
  full-mismatch tt population (ratio 1.02). MOS share of the variance
  **83 %** (error-amplifier pair, mirrors, bias leg and `Mpass` together;
  per-device attribution not done). The `EN` devices sit in the MOS
  population too.
- **Deterministic negative control** (VREF 0.93 V, same seeds as tt): own
  yield **0.0075 [0.0015, 0.0218]**, `status: fail` (exit 3, Cpk −0.78);
  attached to the tt population, `klt yield` grades it **`detected`**.
  Paired by seed it moves every draw by **+60.013 mV ± 0.152 mV (σ)** (range
  59.53–60.48 mV) against a population σ of 10.66 mV.
- **Reproduction** (separate unsharded fleet job, runner-derived seeds): all
  50 tt draws have the **same seeds and bit-identical values** (max |Δ| =
  0.0 V, tolerance 1 µV) as draws 0–49 of the sharded main request.
- **Probe** (MC off): 1.800306041 V at VREF 0.90 V and 1.860305266 V at
  0.93 V; the `alter vref=` axis is live.

## Convergence

No draw in any request errored, came back null or was graded inconclusive
(`crosscheck.json` → `accounting`). The runner attached a recovered-solve
`warning: singular_matrix` diagnostic to **368 of 2000** main draws
(fs_rbcs/−40 °C 190, ss_rbcs/−40 °C 89, tt 57, sf_rwcs 20, ff_rwcs 12),
71/400 negative-control draws, 31/300 attribution draws and 6/50
reproduction draws. In the 50 retained reproduction logs, 36 solves report
`Dynamic gmin stepping completed`. The runner's klt 0.5.0 cannot grade these
as inconclusive (`options.fail_on_diagnostic` is newer, klayout-tools#2901),
so they are **included** in the yield, and their effect is stated:

| Population | recovered / clean | mean, recovered vs clean (V) | closest margin, recovered vs clean (mV) | zero-failure lower bound on the clean draws alone |
|---|---|---|---|---|
| tt / 27 °C | 57 / 343 | 1.80406 vs 1.80067 | 8.17 vs 3.79 | 0.9893 |
| ss_rbcs / −40 °C | 89 / 311 | 1.79986 vs 1.80083 | 12.33 vs 4.13 | 0.9882 |
| ff_rwcs / 125 °C | 12 / 388 | 1.80096 vs 1.80053 | 22.29 vs 3.91 | 0.9905 |
| sf_rwcs / 125 °C | 20 / 380 | 1.80351 vs 1.80085 | 14.43 vs 9.50 | 0.9903 |
| fs_rbcs / −40 °C | 190 / 210 | 1.79939 vs 1.80009 | **1.31** vs 12.50 | 0.9826 |

As before, the recovered draws are not an outlier class (means within
3.4 mV of the clean draws) but include the campaign's closest draw
(fs_rbcs draw 329). **The planning-target pass depends on counting them.** A
reviewer who does not trust gmin-stepped operating points should read tt,
ss_rbcs and fs_rbcs as "≥ 98.3–98.9 %" rather than "≥ 99.08 %".

## What this record does not show

- **Row 2 is not ratified** by this record and its scope wording is not
  decided by it (two-key review and a decision-record update, not this PR).
- **Reference error is excluded.** A real 0.9 V reference's spread must be
  combined with this before reading it against a system ±2 % budget.
- **Not covered:** global/process statistical sampling (five named corners
  stand in for it); `Vin`/load variation (rows 1/5, #55); `Cc` (no mismatch
  model; open at DC); the disabled state (`EN` is tied to `VIN`); post-layout
  effects (item 7); ppm-level tails.
- **Row 8** (current-limit window) has no campaign: there is no limiter (#63).
- **T1 item 6 is left uncited** in `signoff/sg13g2-ldo.json`, for the reasons
  the earlier record's "Signoff grading check" gives (klayout-tools#2908:
  one Open row's evidence would mark the whole item met while row 8 has
  none). That grading experiment was not repeated here.

## Reproducing

```bash
export PDK_ROOT=/path/to/pdk-parent    # ihp-sg13cmos5l @ f7bca326 (fetcher install) + ihp-sg13g2 0.3.0
sim/ldo-cmos5l-monte-carlo/run_campaign.sh submit  /tmp/rerun     # fleet; mints new raw reports
KLT_YIELD=/path/to/klt-with-native \
sim/ldo-cmos5l-monte-carlo/run_campaign.sh analyse sim/ldo-cmos5l-monte-carlo/records/20261012-093854-934dbd7
sim/ldo-cmos5l-monte-carlo/run_campaign.sh check   sim/ldo-cmos5l-monte-carlo/records/20261012-093854-934dbd7
```

`analyse`, run on the committed raw reports, regenerates every file under
`yield/`, plus `crosscheck.json` and the record CSV, byte for byte; `check`
is the stdlib subset CI runs.

- **Timestamp / author**: 2026-10-12T09:38:54Z (campaign start; last request
  returned 11:02Z), from worktree base `934dbd7`. Loom Builder (agent),
  issue #155.
