2AMLogic/sg13g2-ldo/sim/ldo-cmos5l-pvt-sweep/records/20261012-063918-bb1d73c-startup-ext.md

# Startup campaign record `20261012-063918-bb1d73c` stage `ext` (issue #69)

SCHEMATIC-LEVEL evidence for the EN-bearing SG13CMOS5L core. Proposed methodology (README.md "Startup campaign (issue #69)"); DR-0007 row 9 stays **Open**. Verdicts come from `startup_eval.py`; a missing or non-converged trace is `insufficient`, never a pass.

## Coverage

- Requested points: **16**
- Points with a result row: 16
- Evaluated (data sufficient): **16**
- Insufficient / missing data: **0**
- Verdicts: pass 2, fail 14, insufficient 0
- Complete: **yes**
- Engine: ngspice-46; runner klt 0.5.0; client klt 0.7.0+gff97d692a147
- klt sim requests: 8; fleet jobs recorded: 8
- PDK pin (sim/pdk-cmos5l.json) f7bca32694fe; installed checkout f7bca32694fe (match)
- OSDI binaries (sha256): cap_cmomf.osdi 52ce5c95055a, cap_cmomi.osdi 61491e722c30, mosvar.osdi 25e64a374ab5, psp103.osdi 2e4299c46839, psp103_nqs.osdi 839b16448320, r3_cmc.osdi 4fead17bc2e9
- Source hashes: `sim/ldo-cmos5l-pvt-sweep/testbench/tb_startup_cmos5l.spice.tmpl` ad9e077575a7, `design/sg13cmos5l/netlist/ldo_core_cmos5l.spice` 08a7b857e1fa, `sim/ldo-cmos5l-pvt-sweep/startup_eval.py` da3543a6d412, `sim/ldo-cmos5l-pvt-sweep/startup_campaign.py` a445a7177f5c

## Extrema over the evaluated points

| metric | min | at | max | at |
|---|---|---|---|---|
| start overshoot above 1.8 V [V] | 0.00743022 | `st_ff_-40c_rwcs_v3630mv_i50ma_c4700nf_e500mohm_t1000ns` | 1.03518 | `st_ff_-40c_rwcs_v3630mv_i0ma_c330nf_e0mohm_t1000ns` |
| start peak VOUT [V] | 1.80743 | `st_ff_-40c_rwcs_v3630mv_i50ma_c4700nf_e500mohm_t1000ns` | 2.83518 | `st_ff_-40c_rwcs_v3630mv_i0ma_c330nf_e0mohm_t1000ns` |
| start settle time [s] | 9.50907e-06 | `st_ff_-40c_rwcs_v3630mv_i0ma_c4700nf_e500mohm_t1000ns` | 0.00599974 | `st_ff_-40c_rwcs_v3630mv_i50ma_c330nf_e0mohm_t1000ns` |
| start 10-90 % rise time [s] | 6.26048e-07 | `st_ff_-40c_rwcs_v3630mv_i0ma_c330nf_e500mohm_t1000ns` | 1.29245e-05 | `st_ff_125c_rwcs_v3630mv_i50ma_c4700nf_e0mohm_t1000ns` |
| start max downward excursion [V] | 7.86795e-11 | `st_ff_-40c_rwcs_v3630mv_i50ma_c4700nf_e500mohm_t1000ns` | 0.804972 | `st_ff_-40c_rwcs_v3630mv_i50ma_c330nf_e0mohm_t1000ns` |
| re-enable overshoot [V] | 0.00710372 | `st_ff_-40c_rwcs_v3630mv_i0ma_c4700nf_e500mohm_t1000ns` | 0.960824 | `st_ff_-40c_rwcs_v3630mv_i0ma_c330nf_e0mohm_t1000ns` |
| re-enable max downward excursion [V] | 0 | `st_ff_-40c_rwcs_v3630mv_i0ma_c4700nf_e500mohm_t1000ns` | 0.98283 | `st_ff_-40c_rwcs_v3630mv_i50ma_c330nf_e0mohm_t1000ns` |
| off-state max VOUT [V] | 1.87654e-07 | `st_ff_-40c_rwcs_v3630mv_i50ma_c4700nf_e500mohm_t1000ns` | 0.156079 | `st_ff_125c_rwcs_v3630mv_i0ma_c4700nf_e0mohm_t1000ns` |
| off-state supply current [A] | 2.00519e-06 | `st_ff_-40c_rwcs_v3630mv_i0ma_c4700nf_e500mohm_t1000ns` | 2.26405e-06 | `st_ff_125c_rwcs_v3630mv_i50ma_c4700nf_e500mohm_t1000ns` |
| start max Vsg(Mpass) [V] | 3.6263 | `st_ff_-40c_rwcs_v3630mv_i0ma_c330nf_e500mohm_t1000ns` | 3.62877 | `st_ff_125c_rwcs_v3630mv_i50ma_c4700nf_e0mohm_t1000ns` |
| start max Vds(Mpass) [V] | 3.47392 | `st_ff_125c_rwcs_v3630mv_i0ma_c4700nf_e0mohm_t1000ns` | 3.63 | `st_ff_-40c_rwcs_v3630mv_i50ma_c330nf_e500mohm_t1000ns` |
| start peak supply current [A] | 0.535589 | `st_ff_125c_rwcs_v3630mv_i0ma_c330nf_e500mohm_t1000ns` | 0.787999 | `st_ff_-40c_rwcs_v3630mv_i50ma_c4700nf_e0mohm_t1000ns` |

## Failure reasons (count of points)

- off-state off-state: 4
- reen_downward excursion: 13
- reen_not settle: 7
- reen_peak overshoot: 13
- start_downward excursion: 14
- start_not settle: 9
- start_peak overshoot: 14
- start_settles settle: 1

## Points

Per-point metrics, trace file names and trace sha256 are in `20261012-063918-bb1d73c-startup-ext.csv`; reduced traces in `20261012-063918-bb1d73c-startup-ext.traces/` (`t,vout,en,vin,eaout,ivin`, gzip). Rawfile sha256 per point is the `raw_sha256` column (rawfiles themselves, about 2 MB each, are not committed).
