2AMLogic/sg13g2-ldo/sim/ldo-cmos5l-pvt-sweep/records/20261012-094155-934dbd7c.dropout.md

# Row-4 dropout campaign `20261012-094155-934dbd7c` (DR-0009 definition, PROPOSED)

Quantity: **`dropout_1pct_vin_minus_vout_v`** = Vin* - 0.99 x VOUT(50 mA, Vin = 3.30 V), Vin* the linearly interpolated Vin at which VOUT = 0.99 x VOUT(3.30 V) scanning down from 3.30 V. This is NOT the legacy `dropout_v_50ma` (lowest regulating 10 mV-grid Vin minus the fixed 1.8 V). DR-0009 is `proposed`; nothing here is ratified and the ratified `< 300 mV` target is unchanged.

- Points: 45/45 present, 45 resolved, status counts {'resolved': 45}.
- Every coordinate exactly once: True.
- Definitive worst-corner claim permitted: **True** (requires all 45 resolved; any failed/malformed/floor-limited point blocks it).

- Worst coordinate (conservative, by bracket upper bound): `ss` / 125 C / `res_typ`: interpolated 255.03 mV, bracket [252.83, 257.83] mV (grid bracket 5.0 mV).
- Lowest crossing Vin among resolved points: 1.9241 V (sweep lower bound 1.700 V).
- Margin to the 300 mV target (upper bound): 42.17 mV.
- Series-resistance equivalent: 42.17 mV / 50 mA = 0.843 ohm (before any parasitic extraction).
- Lower bound below every observed crossing: True.

## Provenance

- backend: batch
- client_klt: klt 0.7.0+gff97d692a147
- engines: `["ngspice-46"]`
- git_sha: 934dbd7c
- input_sha256: `{"design/sg13cmos5l/netlist/ldo_core_cmos5l.spice": "7953b25be4cb00053f8df5f283bee0500f60a826b7a2d6519b88a8578d222cc1", "design/sg13cmos5l/netlist/ldo_erramp_cmos5l.spice": "7982d728a2db933165eedcae69feaa4985dbddf54c269fc68b82d88577c8e38c", "sim/ldo-cmos5l-pvt-sweep/batch_backend.py": "c889a4536769e60f857c469c2d851a7b2a38833dbaf1981fbd6ba5d770701cd1", "sim/ldo-cmos5l-pvt-sweep/dc_metrics.py": "782319eb4ef619b040f3a4001af67a10def775c9cf17e37fe15b4dd8f3340c81", "sim/ldo-cmos5l-pvt-sweep/dropout_campaign.py": "0eaaf4b25b665283725ba5eea095926176e98ede2757d82de94b51963971661c", "sim/ldo-cmos5l-pvt-sweep/dropout_metrics.py": "85f0c21bd3c40015ee7b409d068590fe6badc88ab27b643aebf543c07457147c", "sim/ldo-cmos5l-pvt-sweep/testbench/tb_dropout_cmos5l.spice.tmpl": "2751a0db725cdc17405a2003784e465785e3157525f3c4d1c8f90d64b71a0c5a", "sim/pdk-cmos5l.json": "1d72f2f677078a136b209561f446f5c809277db3cd62dbc990f1f5d277cb3db4"}`
- invocation: python3 sim/ldo-cmos5l-pvt-sweep/dropout_campaign.py run  (batch_backend.py exit 0)
- jobs: `[{"corners": 45, "group": "g00_dcsweep_tt_-40c_rtyp", "job_id": "klt-sim-420e46df2522", "lifecycle": "spot", "requested": 45}]`
- pdk: ihp-sg13cmos5l
- pdk_pin: sim/pdk-cmos5l.json
- record_id: 20261012-094155-934dbd7c
- runner_klt: `["0.5.0"]`
- staged_osdi_sha256: `{"cap_cmomf": "52ce5c95055aeb8d7d3c72c7fba5b78093174a9d2d9142360ebb4d5ae0b8f714", "cap_cmomi": "61491e722c30425eb0e6ac0e79bc5ad28b5491ad516d5405a960c6412acac704", "mosvar": "25e64a374ab523dbfeb7ffed75dcb8b086ee10f06120a9074bd68b92d7b0fb41", "psp103": "2e4299c4683997e26469410dc1ab36b02ced924b1ac0972d6c4eae360e1fc796", "psp103_nqs": "839b164483205601c09032951f6c41d3580f15e506dc40a7202950d3afbdfc7d", "r3_cmc": "4fead17bc2e9cbfe3df6f106e9dbd6f2cdcd48c002af9c56c2ca0b0712fce350"}`
- sweep: `{"load_a": 0.05, "loss": 0.01, "vin_ref_v": 3.3, "vin_v": [1.7, 3.63, 0.005]}`

Per-point values: `20261012-094155-934dbd7c.dropout.csv`; machine summary: `20261012-094155-934dbd7c.dropout.json`.
