2AMLogic/sg13g2-ldo/sim/ldo-cmos5l-pvt-sweep/records/20261010-111618-19e8e39.dropout.md

# Row-4 dropout campaign `20261010-111618-19e8e39` (DR-0009 definition, PROPOSED)

Quantity: **`dropout_1pct_vin_minus_vout_v`** = Vin* - 0.99 x VOUT(50 mA, Vin = 3.30 V), Vin* the linearly interpolated Vin at which VOUT = 0.99 x VOUT(3.30 V) scanning down from 3.30 V. This is NOT the legacy `dropout_v_50ma` (lowest regulating 10 mV-grid Vin minus the fixed 1.8 V). DR-0009 is `proposed`; nothing here is ratified and the ratified `< 300 mV` target is unchanged.

- Points: 45/45 present, 45 resolved, status counts {'resolved': 45}.
- Every coordinate exactly once: True.
- Definitive worst-corner claim permitted: **True** (requires all 45 resolved; any failed/malformed/floor-limited point blocks it).

- Worst coordinate (conservative, by bracket upper bound): `ss` / 125 C / `res_typ`: interpolated 255.03 mV, bracket [252.83, 257.83] mV (grid bracket 5.0 mV).
- Lowest crossing Vin among resolved points: 1.9241 V (sweep lower bound 1.700 V).
- Margin to the 300 mV target (upper bound): 42.17 mV.
- Series-resistance equivalent: 42.17 mV / 50 mA = 0.843 ohm (before any parasitic extraction).
- Lower bound below every observed crossing: True.

## Provenance

- backend: batch
- client_klt: klt 0.7.0+gca3089cd4b9f
- engines: `["ngspice-46"]`
- git_sha: 19e8e39
- input_sha256: `{"design/sg13cmos5l/netlist/ldo_core_cmos5l.spice": "7953b25be4cb00053f8df5f283bee0500f60a826b7a2d6519b88a8578d222cc1", "design/sg13cmos5l/netlist/ldo_erramp_cmos5l.spice": "7982d728a2db933165eedcae69feaa4985dbddf54c269fc68b82d88577c8e38c", "sim/ldo-cmos5l-pvt-sweep/batch_backend.py": "416589e402b2c4396f8c9602056aafde692ceb0ce7a5576cca210ddf9da40697", "sim/ldo-cmos5l-pvt-sweep/dc_metrics.py": "782319eb4ef619b040f3a4001af67a10def775c9cf17e37fe15b4dd8f3340c81", "sim/ldo-cmos5l-pvt-sweep/dropout_campaign.py": "98c1d234922c32d28fdd06c4cb5e69df2fc567e2b2f41f3e7d8acd405ceafc77", "sim/ldo-cmos5l-pvt-sweep/testbench/tb_dropout_cmos5l.spice.tmpl": "2751a0db725cdc17405a2003784e465785e3157525f3c4d1c8f90d64b71a0c5a", "sim/pdk-cmos5l.json": "b27e3c5b0b25ac24d11c38fa07305d35ee746a88ca7700026f09fd87cf3dfadd"}`
- invocation: python3 sim/ldo-cmos5l-pvt-sweep/dropout_campaign.py run  (batch_backend.py exit 0)
- jobs: `[{"corners": 45, "group": "g00_dcsweep_tt_-40c_rtyp", "job_id": "klt-sim-2e1c76f1111e", "lifecycle": "spot", "requested": 45}]`
- pdk: ihp-sg13cmos5l
- pdk_pin: sim/pdk-cmos5l.json
- record_id: 20261010-111618-19e8e39
- runner_klt: `["0.5.0"]`
- staged_osdi_sha256: `{"cap_cmomf": "006ebb9bb05729e408966da04b3c02391ef3e460666e3a59ec2900c8089ea6cc", "cap_cmomi": "9e16967935d9a69f5a18629f83be8bbd7d3d50ac6dae230f8e00b369ba969b04", "mosvar": "25e64a374ab523dbfeb7ffed75dcb8b086ee10f06120a9074bd68b92d7b0fb41", "psp103": "2e4299c4683997e26469410dc1ab36b02ced924b1ac0972d6c4eae360e1fc796", "psp103_nqs": "839b164483205601c09032951f6c41d3580f15e506dc40a7202950d3afbdfc7d", "r3_cmc": "4fead17bc2e9cbfe3df6f106e9dbd6f2cdcd48c002af9c56c2ca0b0712fce350"}`
- sweep: `{"load_a": 0.05, "loss": 0.01, "vin_ref_v": 3.3, "vin_v": [1.7, 3.63, 0.005]}`

Per-point values: `20261010-111618-19e8e39.dropout.csv`; machine summary: `20261010-111618-19e8e39.dropout.json`.
