2AMLogic/sg13g2-ldo/sim/ldo-cmos5l-pvt-sweep/records/20261010-104827-91e92aa-startup-ext.md

# Startup campaign record `20261010-104827-91e92aa` stage `ext` (issue #69)

SCHEMATIC-LEVEL evidence for the EN-bearing SG13CMOS5L core. Proposed methodology (README.md "Startup campaign (issue #69)"); DR-0007 row 9 stays **Open**. Verdicts come from `startup_eval.py`; a missing or non-converged trace is `insufficient`, never a pass.

## Coverage

- Requested points: **24**
- Points with a result row: 24
- Evaluated (data sufficient): **24**
- Insufficient / missing data: **0**
- Verdicts: pass 4, fail 20, insufficient 0
- Complete: **yes**
- Engine: ngspice-46; runner klt 0.5.0; client klt 0.7.0+g8eec069c7576
- klt sim requests: 24; fleet jobs recorded: 24
- PDK pin (sim/pdk-cmos5l.json) 607e18d4bd92; installed checkout 607e18d4bd92 (match)
- OSDI binaries (sha256): cap_cmomf.osdi 006ebb9bb057, cap_cmomi.osdi 9e16967935d9, mosvar.osdi 25e64a374ab5, psp103.osdi 2e4299c46839, psp103_nqs.osdi 839b16448320, r3_cmc.osdi 4fead17bc2e9
- Source hashes: `sim/ldo-cmos5l-pvt-sweep/testbench/tb_startup_cmos5l.spice.tmpl` ad9e077575a7, `design/sg13cmos5l/netlist/ldo_core_cmos5l.spice` 7953b25be4cb, `sim/ldo-cmos5l-pvt-sweep/startup_eval.py` db64505547fc, `sim/ldo-cmos5l-pvt-sweep/startup_campaign.py` fe2b908faf95

## Extrema over the evaluated points

| metric | min | at | max | at |
|---|---|---|---|---|
| start overshoot above 1.8 V [V] | 0.0212186 | `st_ss_-40c_rtyp_v3630mv_i50ma_c4700nf_e500mohm_t1000ns` | 0.942094 | `st_ff_27c_rtyp_v3630mv_i0ma_c330nf_e0mohm_t1000ns` |
| start peak VOUT [V] | 1.82122 | `st_ss_-40c_rtyp_v3630mv_i50ma_c4700nf_e500mohm_t1000ns` | 2.74209 | `st_ff_27c_rtyp_v3630mv_i0ma_c330nf_e0mohm_t1000ns` |
| start settle time [s] | 1.10826e-05 | `st_ff_27c_rtyp_v3630mv_i0ma_c4700nf_e500mohm_t1000ns` | 0.00599948 | `st_ss_-40c_rtyp_v3630mv_i50ma_c330nf_e0mohm_t1000ns` |
| start 10-90 % rise time [s] | 7.1702e-07 | `st_ff_27c_rtyp_v3630mv_i0ma_c330nf_e500mohm_t1000ns` | 1.35695e-05 | `st_ss_-40c_rtyp_v3630mv_i50ma_c4700nf_e0mohm_t1000ns` |
| start max downward excursion [V] | 0 | `st_ss_-40c_rtyp_v3630mv_i0ma_c4700nf_e500mohm_t1000ns` | 0.730106 | `st_ff_27c_rtyp_v3630mv_i50ma_c330nf_e0mohm_t1000ns` |
| re-enable overshoot [V] | 0.0168677 | `st_ss_-40c_rtyp_v3630mv_i0ma_c4700nf_e500mohm_t1000ns` | 0.838147 | `st_ff_27c_rtyp_v3630mv_i0ma_c330nf_e0mohm_t1000ns` |
| re-enable max downward excursion [V] | 0 | `st_ff_27c_rtyp_v3630mv_i0ma_c4700nf_e500mohm_t1000ns` | 0.820373 | `st_ff_27c_rtyp_v3630mv_i50ma_c330nf_e0mohm_t1000ns` |
| off-state max VOUT [V] | 4.08862e-11 | `st_ss_-40c_rtyp_v3630mv_i50ma_c4700nf_e0mohm_t1000ns` | 0.185718 | `st_ff_125c_rwcs_v3630mv_i0ma_c330nf_e500mohm_t1000ns` |
| off-state supply current [A] | 1.61575e-06 | `st_ss_-40c_rtyp_v3630mv_i50ma_c4700nf_e0mohm_t1000ns` | 0.000201971 | `st_ff_27c_rtyp_v3630mv_i0ma_c4700nf_e500mohm_t1000ns` |
| start max Vsg(Mpass) [V] | 3.62238 | `st_ff_125c_rwcs_v3630mv_i0ma_c330nf_e500mohm_t1000ns` | 3.62757 | `st_ss_-40c_rtyp_v3630mv_i50ma_c4700nf_e0mohm_t1000ns` |
| start max Vds(Mpass) [V] | 3.44428 | `st_ff_125c_rwcs_v3630mv_i0ma_c330nf_e500mohm_t1000ns` | 3.63 | `st_ss_-40c_rtyp_v3630mv_i50ma_c4700nf_e500mohm_t1000ns` |
| start peak supply current [A] | 0.517236 | `st_ss_-40c_rtyp_v3630mv_i0ma_c330nf_e500mohm_t1000ns` | 0.691052 | `st_ff_27c_rtyp_v3630mv_i50ma_c4700nf_e0mohm_t1000ns` |

## Failure reasons (count of points)

- off-state off-state: 4
- reen_downward excursion: 19
- reen_not settle: 9
- reen_peak overshoot: 20
- reen_settles settle: 2
- start_downward excursion: 20
- start_not settle: 15
- start_peak overshoot: 20
- start_settles settle: 1

## Points

Per-point metrics, trace file names and trace sha256 are in `20261010-104827-91e92aa-startup-ext.csv`; reduced traces in `20261010-104827-91e92aa-startup-ext.traces/` (`t,vout,en,vin,eaout,ivin`, gzip). Rawfile sha256 per point is the `raw_sha256` column (rawfiles themselves, about 2 MB each, are not committed).
