2AMLogic/sg13g2-ldo/sim/ldo-cmos5l-pvt-sweep/records/20261010-032206-4d45f5d.md

# Record 20261010-032206-4d45f5d -- issue #64 single-point probe

Not the 384-run DoE campaign (not run; see README.md "Dynamic DoE"). One local
debug probe of the legacy operating point (1 mA / 1 uF / 0 ohm ESR) at
ss / 125 C / res_bcs through the parameterised loopgain and psrr templates.

| metric | probe | committed 20260917-023832-7061e8f | abs diff |
|---|---|---|---|
| phase margin (deg) | 53.87453005636634 | 53.87453005636634 | 0 |
| gain margin (dB) | 29.89438768959521 | 29.89438768959521 | 0 |
| PSRR @ 1 kHz (dB) | 53.6506281 | 53.6506281 | 0 |
| PSRR @ 100 kHz (dB) | 34.4469934 | 34.4469934 | 0 |

Tolerance (0.10 deg / 0.10 dB): met at this corner. Other three corners not run.
Artifacts: netlist-snapshots/20261010-032206-4d45f5d/, corners/20261010-032206-4d45f5d/.
