2AMLogic/sg13g2-ldo/sim/ldo-cmos5l-monte-carlo/records/20261009-003009-3ee8306.md

# Record 20261009-003009-3ee8306

- **Experiment**: ldo-cmos5l-monte-carlo (issue #56; part of #5).
- **Claim**: with the PDK's own per-instance MOS and `rhigh` mismatch
  switched on, at five process/temperature corners, the committed
  SG13CMOS5L regulator's no-load output (`Vin` 3.30 V, ideal 0.900 V `VREF`)
  stays inside the **proposed, unratified** row-2 window 1.764–1.836 V in
  every one of 2000 draws. `klt yield` supports ≥ 99.08 % yield at 95 %
  confidence in each population. That figure counts the 24 % of draws
  whose operating point needed gmin stepping (see "Convergence"); without
  them, three populations fall to ≥ 98.2–98.8 %. The normal fit puts the mean
  **3.27–3.78 σ** from the nearest limit (Cpk 1.09–1.26). This is
  regulator-only accuracy: reference error is excluded. **Row 2 stays Open**
  and row 8 stays deferred (#63), so T1 item 6 is **not** discharged (see
  "What this record does not show").
- **Design under test**: `design/sg13cmos5l/netlist/ldo_core_cmos5l.spice`
  sha256 `c6e630e92fe012d16adf71229c99b52d8eb6cc4b85fffbb891108930acf11041`
  (it carries `ldo_erramp_cmos5l`; standalone copy
  `ldo_erramp_cmos5l.spice` `7982d728a2db933165eedcae69feaa4985dbddf54c269fc68b82d88577c8e38c`).
  These are the same bytes DR-0007 cites, unchanged. Every raw report's
  `environment.netlist_closure` pins the testbench `tb_row2_accuracy.spice`
  (`b994dbb0…dbd45`), `runner-preamble.cir` (`24a2581f…3e4bf`) and the core
  netlist by sha256. The committed files hash identically.
- **PDK / models**: `ihp-sg13cmos5l` @ `607e18d4bd9214a52575c194b4181ef449f9252f`
  (`sim/pdk-cmos5l.json`), with its sibling `ihp-sg13g2` 0.3.0. The bundle
  library `row2-corners.lib` (`a0b07d8e…59383`) is staged with every job, and
  its whole closure (cornerMOShv/cornerRES, `sg13g2_moshv_mismatch.lib`
  `2e9612bd…fed09`, `sg13g2_moshv_mod_mismatch.lib`,
  `resistors_mod_mismatch.lib` `f0aa7d90…e1bf9`, …) is pinned per file in
  each raw report's `environment.staged_model_inputs`. OSDI: the fleet
  image's `/opt/pdk/ihp-sg13g2` binaries, hashed into every retained log
  (`psp103.osdi` `2e4299c4683997e26469410dc1ab36b02ced924b1ac0972d6c4eae360e1fc796`,
  `r3_cmc.osdi` `4fead17bc2e9cbfe3df6f106e9dbd6f2cdcd48c002af9c56c2ca0b0712fce350`).
- **Simulator / tools**: ngspice 46 on the 2AM batch fleet. Runner klt
  `0.5.0`, submitting client klt `0.7.0+g4cbdfa769875`
  (`runner_version_check: warn`, so every job records
  `runner_compatibility: mismatch`; see the README "Toolchain"). `klt yield`:
  klt `0.7.0+g4cbdfa769875` with `klt_yield_native` 0.1.0 built from the same
  source tree into a scratch venv (klayout-tools#2900). Signoff grading:
  pinned build `0.5.0+gb15edf5e3a2e`.
- **Measurement**: `.meas dc vout_v FIND v(vout) AT=3.30` over
  `dc Vin 3.29 3.31 0.01`, printed to 10 significant digits
  (`set measureprec=9`). Limits are inclusive: 1.764 ≤ `vout_v` ≤ 1.836 V.
  Definitions and why each condition was chosen: README "Measurement
  definition".

## Requests, seeds, jobs

| Request | Populations × N | Seed | Fleet job(s) | klt sim status |
|---|---|---|---|---|
| `request-row2-probe.json` (MC off) | tt_nom/27 °C at VREF 0.90 and 0.93 V | n/a | `klt-sim-d7b880fa21e3` | fail (exit 3; the 0.93 V point is out of window by design) |
| `request-row2-mc.json` | 5 corners × 400 | 56001 | `klt-sim-607f96ef24c3`, `-f63fc248aac0`, `-038a3f013b03`, `-65fc98931398`, `-dfb2f36dacce` (`remote.hosts: 5`) | pass, 2000/2000 |
| `request-row2-attribution.json` | 3 × 100 | 56002 | `klt-sim-47e3cdd03a4e` | pass, 300/300 |
| `request-row2-negctl.json` | tt/27 °C, VREF 0.93 V, × 400 | 56001 | `klt-sim-23dbd4c87edc` | fail (exit 3, by design), 400/400 ran |
| `request-row2-repro.json` | tt/27 °C × 50 | 56001 | `klt-sim-78e8b93544e2` | pass, 50/50 |

Every draw's `seed` / `process_seed` / `mismatch_seed` is in the raw
reports and in [`20261009-003009-3ee8306.csv`](20261009-003009-3ee8306.csv)
(one row per draw, 2752 rows, nothing filtered). Within each request every
draw has a distinct ngspice seed (`crosscheck.json` → `seeds`).

**Failed first attempt (disclosed, not used).** The main request was first
submitted as **one** batch job, `klt-sim-9395883e7155` (c7i.8xlarge, 16
physical cores). It hit the fleet's whole-job cap and returned no data. The
client reported verbatim: `state: timeout`, `exit_code: 124`,
`elapsed_seconds: 3604`, and for all 2000 units, `batch job
klt-sim-9395883e7155 finished 'timeout' without a usable report: job
exceeded 3600s [output recovery: collected report.json is not valid JSON:
Expecting value: line 1 column 1 (char 0); stderr.log holds no klt error
envelope -- see harness.log under the job's S3 prefix]`. A timed-out job
discards every completed unit (klayout-tools#2833). The same request,
unchanged except for `remote.hosts: 5`, was then resubmitted as five fleet
jobs of 400 draws (the slowest took 2699 s). Nothing was run locally. The
all-error report from the first attempt is not committed: it carries no
measurement. Its identifying fields are quoted above.

## Results per population (`klt yield`, 95 % confidence)

| Population | N | errored / inconclusive | mean (V) | σ (mV) | min … max (V) | A-D normality | empirical yield [95 % CI] | normal-fit yield | Cpk [95 % CI] | σ to spec (limiting side) | sample size | verdict vs planning 0.99 |
|---|---|---|---|---|---|---|---|---|---|---|---|---|
| tt / 27 °C | 400 | 0 / 0 | 1.801151 | 10.662 | 1.767789 … 1.829937 | consistent (0.411) | 1.000 [0.990820, 1] | 0.999213 | 1.090 [1.007, 1.172] | 3.27 (upper) | sufficient | **pass** |
| ss + res_bcs / −40 °C | 400 | 0 / 0 | 1.800613 | 9.357 | 1.768127 … 1.826475 | consistent (0.482) | 1.000 [0.990820, 1] | 0.999877 | 1.261 [1.167, 1.354] | 3.78 (upper) | sufficient | **pass** |
| ff + res_wcs / 125 °C | 400 | 0 / 0 | 1.800543 | 10.356 | 1.770726 … 1.832090 | consistent (0.452) | 1.000 [0.990820, 1] | 0.999482 | 1.141 [1.056, 1.227] | 3.42 (upper) | sufficient | **pass** |
| sf + res_wcs / 125 °C | 400 | 0 / 0 | 1.800988 | 9.638 | 1.775805 … 1.826502 | consistent (0.544) | 1.000 [0.990820, 1] | 0.999798 | 1.211 [1.121, 1.301] | 3.63 (upper) | sufficient | **pass** |
| fs + res_bcs / −40 °C | 400 | 0 / 0 | 1.799761 | 9.763 | 1.765307 … 1.824654 | consistent (0.359) | 1.000 [0.990820, 1] | 0.999772 | 1.221 [1.130, 1.312] | 3.66 (lower) | sufficient | **pass** |

Reports: `20261009-003009-3ee8306/yield/<population>.yield.{json,txt}`,
each beside the sample-set document it was computed from. Exit codes are in
`yield/exit-codes.txt` (0 for all five).

**Reading it honestly.** No draw left the window: 2000/2000 pass. The
closest was 1.765307 V (fs_rbcs/−40 °C, draw 329), 1.3 mV inside the lower
limit. With N = 400 and zero failures, the strongest defensible statement
per population is "**at least 99.08 % at 95 % confidence**", not 100 %.
That clears the planning target 0.99, a sample-size design input and not a
ratified yield (README "Seeds, sample size, convergence"). The normal fit
(Anderson-Darling consistent in all five) extrapolates **≈ 120–790 ppm**
fallout per population, with the mean 3.27–3.78 σ from the nearest limit.
So the evidence supports a 99 %-class claim. It does **not** support a 3σ
(99.73 %) or tighter row-2 yield. Whatever yield the ratified row ends up
requiring decides whether this design meets it, and a ppm-level target
would need importance sampling or a larger campaign.

## Cross-checks (`20261009-003009-3ee8306/crosscheck.json`)

- **Sampler negative control** (attribution, `tt_nom`: mismatch off, 100
  distinct seeds): all 100 values are **identical**, 1.800306041 V. The
  committed corner record gives 1.80030601 V (tt/27 °C/res_typ
  `vout_no_load_v`), a difference of 31 nV. The sampler injects no variation
  of its own, and the bench reproduces the committed deterministic point.
  `klt yield` misreports this degenerate set as "normality rejected, Cpk
  1.3e13" because of a 9e-16 rounding residue (klayout-tools#2909). That
  report is informational only; the zero spread is checked exactly in
  `crosscheck.json`.
- **Attribution at tt/27 °C** (N = 100 each): MOS mismatch only σ = 9.908 mV;
  `rhigh` mismatch only σ = 4.540 mV; RSS 10.90 mV against 10.66 mV for the
  full-mismatch tt population (ratio 1.02). The MOS share of the variance is
  **83 %**. That share covers the error-amplifier pair, both mirrors, the
  bias leg and `Mpass`, all sampled together; per-device attribution is not
  done here. The divider ratio is the remaining 17 %. DR-0007's "`Mpass` is
  not accuracy-relevant" is therefore *not* contradicted, but it is not
  isolated either: `Mpass` mismatch is in the MOS population, not omitted.
- **Deterministic negative control** (VREF 0.93 V, same seeds as tt): its
  own yield is **0.0075 [0.0015, 0.0218]**, `status: fail` (exit 3, Cpk
  −0.78). Attached to the tt population, `klt yield` grades it
  **`detected`**. Paired by seed, it moves every draw by **+60.013 mV ±
  0.152 mV (σ)** (range 59.53–60.48 mV), against a population σ of 10.66 mV.
  The same 400 mismatch draws were therefore reproduced and shifted by the
  forced VREF step, not re-drawn.
- **Reproduction** (separate fleet job, unsharded, so the runner derives the
  seeds itself): all 50 tt draws have the **same seeds and bit-identical
  values** (max |Δ| = 0.0 V, tolerance 1 µV) as draws 0–49 of the sharded main
  request, whose seeds the client derived. That also shows client-side and
  runner-side seed derivation agree.
- **Probe** (MC off): 1.800306041 V at VREF 0.90 V and 1.860305266 V at
  0.93 V, so the `supply_v` `alter vref=` axis is live (klayout-tools#2894
  reports a silent no-op `supply_v` key in other decks; it is not one here).

## Convergence

No draw in any request errored, came back null or was graded inconclusive
(`crosscheck.json` → `accounting`: draws = usable for every population). A
solve that needed help is disclosed rather than dropped. The runner attached
a recovered-solve `warning: singular_matrix` diagnostic to **482 of 2000**
main draws (ss_rbcs/−40 °C 201, fs_rbcs/−40 °C 173, tt 97, ff_rwcs 7,
sf_rwcs 4), 97/400 negative-control draws, 42/300 attribution draws and
13/50 reproduction draws. In the 50 retained reproduction logs
(`corners/20261009-003009-3ee8306/`), 34 solves used ngspice's dynamic gmin
stepping, and all 34 completed. Every `singular matrix` warning (at the
nulling resistor's internal node `xtop.xamp.xrz.nr1#i1`) and every r3_cmc
`vmax` warning appears only inside a gmin-stepping solve, i.e. during
intermediate iterations. None appears in a direct solve. `XRz` carries no DC
current (`Cc` is open at DC), which explains the near-singular node.
Recovered solves are **included** in the yield. The runner's klt 0.5.0
cannot grade them as inconclusive (`options.fail_on_diagnostic` is newer).
Their effect, stated rather than assumed:

| Population | recovered / clean | mean, recovered vs clean (V) | closest margin, recovered vs clean (mV) | zero-failure lower bound on the clean draws alone |
|---|---|---|---|---|
| tt / 27 °C | 97 / 303 | 1.80176 vs 1.80096 | 6.80 vs 3.79 | 0.9879 |
| ss_rbcs / −40 °C | 201 / 199 | 1.80027 vs 1.80096 | 4.13 vs 9.53 | 0.9816 |
| ff_rwcs / 125 °C | 7 / 393 | 1.80272 vs 1.80050 | 22.67 vs 3.91 | 0.9907 |
| sf_rwcs / 125 °C | 4 / 396 | 1.80297 vs 1.80097 | 20.66 vs 9.50 | 0.9907 |
| fs_rbcs / −40 °C | 173 / 227 | 1.80003 vs 1.79955 | **1.31** vs 4.81 | 0.9839 |

The recovered draws are not an outlier class: their means sit within 1 mV
of the clean draws. They do include the campaign's closest draw (fs_rbcs
draw 329). Every value, recovered or clean, is inside the window. But
**the planning-target pass depends on counting them**. Dropping them would
leave 199–396 draws per population, and the zero-failure lower bound would
fall below 0.99 for tt, ss_rbcs and fs_rbcs. A reviewer who does not trust
gmin-stepped operating points should read those three populations as
"≥ 98.2–98.8 %" rather than "≥ 99.08 %". Re-grading with
`fail_on_diagnostic` needs a fleet runner newer than klt 0.5.0
(klayout-tools#2901).

## What this record does not show

- **Row 2 is not ratified** by this record, and its scope wording is not
  decided by it. Both need the two-key review and a decision-record update
  (DR-0007 row 2 still lists Monte Carlo as missing; updating that row is
  the reviewers' act, not this PR's).
- **Reference error is excluded.** A real 0.9 V reference's spread must be
  combined with this before reading it against a system ±2 % budget.
- **Not covered:** global/process statistical sampling (five named corners
  stand in for it); `Vin`/load variation (rows 1/5, #55); `Cc` (no model);
  post-layout effects (item 7); ppm-level tails.
- **Row 8** (current-limit window) has no campaign: there is no limiter
  (#63).
- **T1 item 6 is left uncited** in `signoff/sg13g2-ldo.json`. The record
  below shows why.

## Signoff grading check (pinned build `0.5.0+gb15edf5e3a2e`)

- Committed manifest, unchanged: regenerated report is **byte-identical** to
  `signoff/sg13g2-ldo.t1-report.json` (exit 3, 3/11).
- **Scratch** manifest (not committed) = committed manifest plus
  `"6": {"file": ".../yield/tt_27C.yield.json", "content_hash":
  "sha256:1e209dd80f88470ccc7a015bd2397b2896bbcfa1a1ad3ac89a41a8e12aba8c27"}`
  (the sha256 of `tt_27C.samples.json`, the input this grader re-hashes for
  a yield citation). Item 6 grades **`met`**, `input_verified: true`,
  `t1_met_count` 4. That is the over-statement: one Open row's evidence
  would mark the whole item met while row 8 has none. The tool gap is
  klayout-tools#2908.
- **Tamper check**: the same scratch citation pointed at a *copy* of the
  report whose `samples[0]` was altered grades item 6 **`unmet` /
  `stale_evidence`**. The freshness check catches a changed input.

## Reproducing

```bash
export PDK_ROOT=/path/to/pdk-parent    # ihp-sg13cmos5l @ 607e18d4 + ihp-sg13g2 0.3.0
sim/ldo-cmos5l-monte-carlo/run_campaign.sh submit  /tmp/rerun     # fleet; mints new raw reports
KLT_YIELD=/path/to/klt-with-native \
sim/ldo-cmos5l-monte-carlo/run_campaign.sh analyse sim/ldo-cmos5l-monte-carlo/records/20261009-003009-3ee8306
```

The second line, run on the committed raw reports, regenerates every file
under `yield/`, plus `crosscheck.json` and the record CSV, byte for byte.
Fixed seeds mean a fresh `submit` reproduces the draws; the reproduction
request above is that check. The requests in this record were submitted
individually with `klt sim request-row2-<name>.json --backend batch -o
<artifacts> --format json` (`PDK_ROOT` exported), which is the command
`run_campaign.sh submit` runs for each one.

- **Timestamp / author**: 2026-10-09T00:30:09Z (campaign start; main
  request resubmitted 01:31Z), from an uncommitted worktree on base
  `3ee8306`. Loom Builder (agent), issue #56.
