2AMLogic/sg13g2-ldo/sim/ldo-cmos5l-pvt-sweep/records/20260916-083154-7aa1d3f.md

# Record 20260916-083154-7aa1d3f

- **Experiment**: ldo-cmos5l-pvt-sweep
- **Claim**: design/sg13cmos5l/ldo_core_cmos5l.sch's closed loop
  (issue #20), verified against the spec table re-derived at this
  PDK's rails (README.md), across the full process x temperature
  PVT grid, plus Cc-value and Rz-corner sensitivity sweeps -- the
  input to issue #21's acceptance criteria.
- **PDK**: `ihp-sg13cmos5l` at `/Users/rwalters/share/pdk` -- pinned revision: see
  `sim/pdk-cmos5l.json` (commit `607e18d`, re-verified against the
  installed checkout).
- **OSDI models**: `/Users/rwalters/share/pdk/ihp-sg13cmos5l/libs.tech/ngspice/osdi` -- built by
  `PDK=ihp-sg13cmos5l sim/tools/build-osdi.sh`.
- **ngspice**: `** ngspice-46 : Circuit level simulation program`
- **Design netlist under test**: `design/sg13cmos5l/netlist/ldo_core_cmos5l.spice`
  at this repo's git sha `7aa1d3f`.
- **Corner matrix run**: process {tt ss ff sf fs} (cornerMOShv.lib) x
  temperature {-40 27 125}C = 15 points x 3 benches (dcsweep,
  loopgain, psrr) = 45 points, plus 6 sensitivity points (Cc value
  {0.5x,1x,2x} + Rz corner {bcs,typ,wcs}, both at tt/27C only).
- **Result**: 51/51 points PASS (ngspice exit 0, no
  convergence/model-load error strings in the log).
- **Completeness matrix**: OK -- every (corner,temp) has all 3 benches present
- **Resistor corner**: held at `res_typ` (nominal) across the main
  15-point PVT grid -- no established MOS-corner/R-corner
  correlation convention exists yet in this repo (see README.md);
  Rz's own real corner spread is checked separately via the
  `loopgain_rzsens_*` sensitivity points instead.
- **MoM-cap (Cc) caveat**: cornerCAP.lib maps every corner/mismatch/stat
  section to the SAME nominal `cap_cmomi` model at this PDK's pin (no
  characterised corner spread exists) -- every phase-margin / loop-gain
  result in `records/20260916-083154-7aa1d3f.csv` is therefore `insufficient-evidence`
  pending the `loopgain_ccsens_*` VALUE sensitivity points in
  `records/20260916-083154-7aa1d3f.sensitivity.csv`, per design/README.md's
  'PDK caveats honoured' table and issue #21 acceptance criterion 4.
- **Netlist provenance**: circuit-level bench (this experiment
  instantiates `ldo_core_cmos5l` -- whole for dcsweep/psrr, flattened
  one level with a sync-checked loop break for loopgain -- not a
  bare-device screen; contrast `sim/pass-device-screening/`).
- **Links**:
  - Templates: `testbench/tb_dcsweep_cmos5l.spice.tmpl`,
    `testbench/tb_loopgain_cmos5l.spice.tmpl`,
    `testbench/tb_psrr_cmos5l.spice.tmpl`
  - Per-point generated netlists: `netlist-snapshots/20260916-083154-7aa1d3f/`
  - Per-point raw ngspice logs + per-point sweep CSVs:
    `corners/20260916-083154-7aa1d3f/`
  - Main PVT-grid CSV (spec-row-relevant merged metrics, one row
    per corner/temp): `records/20260916-083154-7aa1d3f.csv`
  - Cc-value / Rz-corner sensitivity CSV:
    `records/20260916-083154-7aa1d3f.sensitivity.csv`
- **Timestamp / author**: 2026-09-16T08:33:24Z, Loom Builder
  (agent), issue #21.
