2AMLogic/sg13g2-ldo/sim/ldo-cmos5l-pvt-sweep/evidence/20261012-060932-c53f0177/row10-margins.md

# Row 10 margin classification (DR-0014, proposed): `20261012-060932-c53f0177`

<!-- GENERATED by sim/ldo-cmos5l-pvt-sweep/row10_margins.py -- do not edit; `--check` byte-compares. -->

Offline re-classification of the committed loop-gain traces of record `sim/ldo-cmos5l-pvt-sweep/records/20261012-060932-c53f0177.csv` (Vin 3.30 V, 1 mA, Cout 1 uF, ESR 0, Cc nominal; 45-point PVT grid) under [`DR-0014`](../../../../spec/decision-records/DR-0014-row10-stability-margin-classification.md). No simulation was run and no record was edited. Bounds: PM >= 45 deg, GM >= 10 dB, sweep-ceiling floor -10 dB. 45 traces verified: every trace reproduces its record's 0 dB crossing count, first-crossing PM, recorded worst-crossing PM and first -180 deg GM; every recorded PM/GM miss classifies as fail (no-loosening guard).

## All points

| quantity | value |
|---|---|
| points | 45 |
| PM verdicts | ambiguous: 45 |
| PM reasons | ceiling_unbounded: 45 |
| GM verdicts | ambiguous: 45 |
| GM reasons | ceiling_unbounded: 45 |
| 0 dB crossings per trace | 2: 45 |
| -180 deg (critical-line) crossings per trace | 1: 45 |
| scored PM (min over crossings) [deg] | 53.87 .. 76.93 |
| first-crossing margin [deg] | 53.87 .. 76.93 |
| later-crossing margins [deg] | 156.6 .. 166.2 |
| in-band GM (min over -180 deg crossings) [dB] | 13.84 .. 29.87 |
| low-end premise holds | 45 of 45 (gain at 1 Hz 121.4 .. 124.7 dB) |
| sweep ceiling bounded | 0 of 45 |
| loop gain at the ceiling [dB] | 0.3979 .. 1.17 |
| loop-gain change over the last decade [dB] | -0.5642 .. -0.4254 |
| Nyquist bookkeeping | undetermined: 45 |

## Subset `multi_crossing_points`: points the record lists with more than one 0 dB crossing (reported ambiguous by the characterization report before DR-0014)

| quantity | value |
|---|---|
| points | 45 |
| PM verdicts | ambiguous: 45 |
| PM reasons | ceiling_unbounded: 45 |
| GM verdicts | ambiguous: 45 |
| GM reasons | ceiling_unbounded: 45 |
| 0 dB crossings per trace | 2: 45 |
| -180 deg (critical-line) crossings per trace | 1: 45 |
| scored PM (min over crossings) [deg] | 53.87 .. 76.93 |
| first-crossing margin [deg] | 53.87 .. 76.93 |
| later-crossing margins [deg] | 156.6 .. 166.2 |
| in-band GM (min over -180 deg crossings) [dB] | 13.84 .. 29.87 |
| low-end premise holds | 45 of 45 (gain at 1 Hz 121.4 .. 124.7 dB) |
| sweep ceiling bounded | 0 of 45 |
| loop gain at the ceiling [dB] | 0.3979 .. 1.17 |
| loop-gain change over the last decade [dB] | -0.5642 .. -0.4254 |
| Nyquist bookkeeping | undetermined: 45 |

Per-point rows: `row10-margins.csv` (trace path and sha256 on every row).

Not claimed: no new simulation; no historical record edited; no ratification: DR-0014 is proposed and row 10 stays Open (DR-0007); no claim about frequencies above the sweep ceiling or between sampled operating points.
