2AMLogic/sg13g2-ldo/sim/ldo-cmos5l-pvt-sweep/evidence/20261011-165616-eabde108/row10-margins.md

# Row 10 margin classification (DR-0014, proposed): `20261011-165616-eabde108`

<!-- GENERATED by sim/ldo-cmos5l-pvt-sweep/row10_margins.py -- do not edit; `--check` byte-compares. -->

Offline re-classification of the committed loop-gain traces of record `sim/ldo-cmos5l-pvt-sweep/records/20261011-165616-eabde108.loopgain2.csv` (Vin 3.30 V, 1 mA, Cout 1 uF, ESR 0, Cc nominal; 45-point PVT grid; Middlebrook loop gain T = (Tv*Ti - 1)/(Tv + Ti + 2) reconstructed from the two-injection benches tb_loopgain2v/tb_loopgain2i by loopgain2.py (issue #135), resolved prefix only) under [`DR-0014`](../../../../spec/decision-records/DR-0014-row10-stability-margin-classification.md). No simulation was run and no record was edited. Bounds: PM >= 45 deg, GM >= 10 dB, sweep-ceiling floor -10 dB. 45 traces verified: every trace reproduces its record's 0 dB crossing count, first-crossing PM, recorded worst-crossing PM and first -180 deg GM; every recorded PM/GM miss classifies as fail (no-loosening guard).

## All points

| quantity | value |
|---|---|
| points | 45 |
| PM verdicts | ambiguous: 45 |
| PM reasons | reconstruction_unresolved_above_cut: 45 |
| GM verdicts | ambiguous: 45 |
| GM reasons | reconstruction_unresolved_above_cut: 45 |
| 0 dB crossings per trace | 1: 45 |
| -180 deg (critical-line) crossings per trace | 1: 45 |
| scored PM (min over crossings) [deg] | 53.87 .. 76.78 |
| first-crossing margin [deg] | 53.87 .. 76.78 |
| later-crossing margins [deg] | - |
| in-band GM (min over -180 deg crossings) [dB] | 18.41 .. 38.26 |
| low-end premise holds | 45 of 45 (gain at 1 Hz 121.4 .. 124.7 dB) |
| sweep ceiling bounded | 45 of 45 |
| loop gain at the ceiling [dB] | -145.4 .. -140.8 |
| loop-gain change over the last decade [dB] | -79.13 .. -70.78 |
| Nyquist bookkeeping | undetermined: 45 |

## Subset `multi_crossing_points`: points the record lists with more than one 0 dB crossing (reported ambiguous by the characterization report before DR-0014)

| quantity | value |
|---|---|
| points | 0 |
| PM verdicts |  |
| PM reasons |  |
| GM verdicts |  |
| GM reasons |  |
| 0 dB crossings per trace |  |
| -180 deg (critical-line) crossings per trace |  |
| scored PM (min over crossings) [deg] | - |
| first-crossing margin [deg] | - |
| later-crossing margins [deg] | - |
| in-band GM (min over -180 deg crossings) [dB] | - |
| low-end premise holds | 0 of 0 (gain at 1 Hz - dB) |
| sweep ceiling bounded | 0 of 0 |
| loop gain at the ceiling [dB] | - |
| loop-gain change over the last decade [dB] | - |
| Nyquist bookkeeping |  |

Per-point rows: `row10-margins.csv` (trace path and sha256 on every row).

Not claimed: no new simulation; no historical record edited; no ratification: DR-0014 is proposed and row 10 stays Open (DR-0007); no claim about frequencies above the sweep ceiling or between sampled operating points.

Resolution overlay (`row10_loopgain2.py`): a point whose reconstruction is truncated below the sweep ceiling is reported ambiguous (pass -> ambiguous; fail unchanged); its GM above-ceiling bound is withdrawn and its Nyquist bookkeeping is undetermined. The ceiling columns describe the END OF THE RESOLVED PREFIX, not the 10 GHz sweep ceiling. Points truncated: 45 of 45.
