2AMLogic/sg13g2-ldo/signoff/README.md

# signoff/ — klt signoff block manifest and the T1 verdict of record

This directory is this repo's machine-graded **gap-to-T1** state (#44). Issue
#5's hand-maintained checkbox list is retired: the **committed block manifest
is the input**, the **committed tier report is the verdict of record**, and
both are regenerated and gated in CI — so the state cannot go silently stale
the way a hand-read checklist does.

| File | What it is |
| --- | --- |
| `sg13g2-ldo.json` | The **block manifest** for `klt signoff --manifest`: `block: sg13g2-ldo`, `kind: analog`, and one pinned evidence citation per T1 item this repo can honestly cite. |
| `sg13g2-ldo.t1-report.json` | The **verdict of record**: the exact `klt signoff --manifest sg13g2-ldo.json --format json` output, committed. `t1_item_count: 11, t1_met_count: 8, tier: null` — this block is **not T1 yet**, and the report says so per item with a `reason`. |

## Reading the report

Today's honest read is **8/11 met** (items 1, 2, 3, 4, 8, 9, 10, 11). Issue #67 appended an `EN` port and two devices to `design/sg13cmos5l/netlist/ldo_core_cmos5l.spice`. That left the selected PVT record stale against the design, and item 8 dropped to `unmet` (`check_failed`). PR #87 then re-ran the full 45-point grid on the EN design (`EN` tied to `VIN`) on the EDA batch fleet: record `sim/ldo-cmos5l-pvt-sweep/records/20261010-025634-60a3e81`, made with `run_sweep.sh --batch`. Selecting that record makes the characterization artifact current again, so item 8 is `met` once more, in the artifact-completeness sense described below. The enabled-state results differ from the pre-EN record by at most 0.015 deg of phase margin and 0.023 dB of gain margin (DR-0008 addendum). Issue #89 then added a `G1` disable pull-down inside the error amplifier (an `EN` pin on `ldo_erramp_cmos5l`, an inverter and a 1 x 1 um NMOS; DR-0008 addendum "G1 disable pull-down"). Both design netlists changed, so the grid (record `20261011-051956-eda9285`) and the startup campaign (record `20261011-031426-df3f802`) were re-run on the batch fleet and reselected, and the item-5 informational evidence was regenerated for the new record. The enabled state moves by at most -0.0021 deg of phase margin, -0.0086 dB of gain margin and +0.043 nA of Iq; every row verdict is unchanged. The disabled state is measured by the one-corner DC smoke check (`sim/ldo-cmos5l-enable/`, 2.0006 uA at 3.30 V, tt/27C) and by the startup bench's off-state samples (2.000-2.264 uA over 135 PVT points). These are measurements, not a target; no shutdown-current row exists. The layout was regenerated with the three devices, and the DRC/LVS/ERC reports and their item 2/3/4/11 pins were refreshed (`layout/README.md`).

Issue #128 then re-ran the same 45-point grid on the batch fleet with the loop-gain sweep extended from 100 MHz to 10 GHz (record `20261011-070111-5391c68`, same design netlists) and reselected it. Every DC and PSRR column is identical to the previous record. Under the unchanged DR-0014 rules row 10 PM and GM are still 45 `ambiguous` and 0 pass / 0 fail (`ceiling_unbounded`): the loop gain flattens near +1 dB above the second 0 dB crossing instead of falling away. Statuses are unchanged (exit 3, 8/11 met). The item-5 evidence below now lives under that record's `evidence/` directory.

**Items 3, 4 and 11 are current for the EN design (#68), and again for #89's G1 disable pull-down** (three more devices drawn; the item 3/11 pins moved to the new GDS hash and the item 4/11 pins to the new extracted-netlist hash; regraded under the same pinned build, statuses unchanged, 8/11 met). The DRC/LVS/ERC reports were regenerated by `layout/run_flow.sh` on the six-port layout (`EN` port, `XMen` and `XMbdis` drawn with VIN-tied bodies) and their citations re-pinned to the new GDS and extracted-netlist hashes; the pre-EN five-port evidence is superseded and no longer cited. They cover the DRC, LVS and structural-ERC claims described below for the layout only. They say nothing about post-layout performance (item 7 is still unmet) and no ERC antenna verdict exists (`not_checked`). The LVS compare is device-level for MOS and `rhigh` and name-equality for `cap_cmomi`, unchanged. Items 1 and 9 attest source and testbench freshness only (see below).

Per item:

- **met — item 3 (DRC clean)**: `layout/sg13cmos5l-ldo_core_cmos5l/drc_report.json`, `status: clean`, 0 violations, citation verified against the committed GDS (`input_verified: true`).
- **met — item 4 (LVS clean)**: `layout/sg13cmos5l-ldo_core_cmos5l/lvs_report.json`, `status: match`, 0 errors / 0 mismatches, citation verified against the committed extracted netlist it compared.
- **met — item 8 (characterization report)**: `sim/characterization/characterization-envelope.json`, a hand-rolled `kind: generic` envelope (the one evidence kind item 8 accepts) with `t1_item: 8`, pinned by `content_hash` to the sha256 of the committed aggregate report. **What `met` means here, and what it does not**: the envelope verdict is *artifact completeness and freshness* — every one of the ten target-spec rows appears exactly once with an explicit state, every selected source record matches its sha256 pin, the 45-point PVT grid is whole, and the record is current against the design netlists. It is **not** a claim that the circuit meets its spec: the report lists failing/ambiguous/unmeasured/unimplemented/unratified rows as such (today: 1 not measured, 5 partial-coverage passes, 1 full-coverage pass on the one ratified row, 1 ambiguous, 2 not implemented), and no post-layout performance evidence exists. `klt signoff` does **not** inspect the envelope's `source`, nor re-hash the report (`input_verified: null` for generic envelopes); the content and freshness are verified by this repo's generator and its CI `--check` gate (`python3 sim/characterization/generate.py --check`), which is what makes the pin trustworthy. Other T1 items are not touched by this citation.
- **met — item 11 (power delivery, structural)**: `layout/sg13cmos5l-ldo_core_cmos5l/erc_supply_report.json` (with item 4's LVS report as the second part), `input_verified: true`. VIN/VOUT/VSS each resolve to one island, zero `erc.supply_short`, zero `erc.missing_tie` from three **checked** ties (`nwell_tie_VIN`, `nwell_tie_TAIL`, `substrate_tie_VSS`; `erc_coverage.skipped` empty, nothing `degenerate_*`). **What `met` means here, and what it does not** (the claimant-side disclosures the grader does not enforce): every tie rests on a *caller assertion* — the report's `power_delivery` block lists all three under both `ties_checked_by_assertion` (tap boxes) and `ties_checked_by_well_assertion` (the well side: `well_requires_boxes` selects which NWell each n-tie is about, and the substrate tie sits in native substrate, so its region is asserted via `well_layer: null` + `well_boxes`). The boxes are not hand-typed: they are the generator's own `draw_tap_bar` calls (`layout/sg13cmos5l-ldo_core_cmos5l/erc-tap-boxes.json`, verified against the spec by `layout/erc_ties.py --check` in `layout/run_flow.sh`), and the n-ties are additionally layer-narrowed (`tap_requires` nSD), which this stream can express because it draws implants. The substrate tie's asserted region is the tap bar grown by 20 µm (the PDK deck's LU.b reach), so `erc_coverage.well_assertion_coverage` reports `uncovered_tap_fraction ≈ 0.977`: tap geometry elsewhere in the layout (every n+ source/drain contact is Activ too) was never examined by that tie, only the NMOS-group region was. `erc_coverage.layers_in_stream_without_declaration` is `28/0, 31/2, 44/0, 63/0, 99/39, 111/0` (marker/label layers carrying no routing). A tie-box mutation control (one tap box moved off its tap) MUST raise `erc.missing_tie`; `layout/run_flow.sh` stage 8b runs it. Connectivity of the taps beyond "a contacted tap reaches the net" is `klt lvs`'s job (item 4).
- **met — items 1, 2, 9, 10 (artifact-anchored attestations, #60)**: four separate `kind: generic` envelopes under [`evidence/`](evidence/), each declaring its own `t1_item` and naming its audited artifact in `provenance.input.path` (`scope: repo`) with `provenance.input.content_hash`; the manifest cites each with the same `content_hash`, and every row renders `met` with `citation.artifact_binding.input_verified: true`. Because several files back each item, the bound artifact is a committed **inventory** (`evidence/item<N>-<slug>.inventory.json`: sorted paths + sha256) rather than a single file. **Scope: the SG13CMOS5L implementation only** (`design/sg13cmos5l/`, `layout/sg13cmos5l-ldo_core_cmos5l/`, the shipped `sim/` benches, repo-level files). Per item:
  - **1 design sources** — SG13CMOS5L `.sch`/`.sym`, `design/netlist.py`, `xschemrc`, and the regenerated ngspice netlists. The SG13G2-branch placeholder sources are not attested.
  - **2 layout** — the committed GDS, its generator and the shared generator module.
  - **9 testbenches shipped** — every `tb_*.spice[.tmpl]` and `run_*.sh` under `sim/`, the Monte Carlo request documents including the negative-control request, and the experiment READMEs; the check requires each README to document its cold-start entry point. The benches are not re-run by this attestation.
  - **10 repo hygiene** — `README.md`, `LICENSE`, `CLAUDE.md`, `spec/README.md` and the CI workflow.

  **What `met` means, and what it does not.** The grader proves that the envelope is declared for this item, names exact bytes, that those bytes re-hash to the pinned value, and that nothing was edited since; the `status: pass` inside the envelope is still the author's assertion. The envelope's claim is backed by `python3 signoff/evidence_inventory.py check` (stdlib only, no PDK, run in CI before grading, with `signoff/test_evidence_inventory.py` negative controls): it re-hashes **every** constituent (a mutated, deleted or unlisted-by-glob file fails with its name), requires the completeness globs to be covered, requires envelope and manifest pins to match, and applies a few content checks beyond existence (xschem header and `.subckt` per cell, GDSII HEADER record, entry points documented, Apache-2.0 LICENSE, CI still carrying the signoff gates). Limits: it does **not** re-run xschem (netlist/schematic consistency is `design/netlist.py --check`'s job, a PDK-needing CI job), regenerate or inspect the GDS beyond its first record (DRC/LVS/ERC are items 3/4/11), execute any testbench, or judge design quality. No spec performance or whole-block T1 claim is made. The grader alone does **not** see a constituent edit: only the inventory check does, which is why it gates CI ahead of grading. Editing an inventoried file means re-running `python3 signoff/evidence_inventory.py write`.
- **unmet — item 5 (`no_evidence`; deliberately uncited, #55)**: no `klt sim` envelope graded against the ratified deterministic row (DR-0007 row 4, dropout) exists, so none is cited. The raw grid now does come from `klt sim` batch requests (`run_sweep.sh --batch`, PR #87). Those requests declare no limits, though, and the metrics are reduced outside klt, so they are measurement runs, not a corner-matrix envelope for the row. `klt sim`'s batch backend still refuses `models.pdk: ihp-sg13cmos5l` (upstream gap [klayout-tools#2727](https://github.com/2AMLogic/klayout-tools/issues/2727)), so those runs depend on staged model inputs. Hand-wrapping the committed CSVs into a sim-shaped envelope would be a synthesized success and is refused. What exists instead is **qualified, non-gating evidence** under [`sim/ldo-cmos5l-pvt-sweep/evidence/20261011-070111-5391c68/`](../sim/ldo-cmos5l-pvt-sweep/evidence/20261011-070111-5391c68/): a ten-row coverage inventory (`coverage-inventory.{json,md}`) and informational DC summaries (`dc-informational-summary.csv`), regenerated and byte-checked by `python3 sim/ldo-cmos5l-pvt-sweep/item5_evidence.py --check` (CI). **If a sim envelope is cited here later, read the grade carefully:** `klt signoff` accepts any `status: pass` sim envelope for item 5 and does not know which spec rows are ratified or Open, nor the SG13G2/SG13CMOS5L branch split. A green item 5 would mean "one cited corner run passed", not that the shared spec is verified: nine of ten rows are Open (DR-0007), the dropout definition is unresolved (#70), and the SG13G2 branch has no closed-loop evidence (#71). The inventory, not the grade, is the coverage statement.
- **unmet — item 6 (`no_evidence`), with real but deliberately uncited evidence.** See "Item 6 coverage statement" below.
- **unmet — item 7 (`no_evidence`)**: item 7 needs `klt pex` (post-layout re-simulation, #57). That envelope will be cited when it is produced — never fabricated to turn a row green.
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
