2AMLogic/sg13g2-ldo/sim/ldo-cmos5l-pvt-sweep/evidence/20261011-070111-5391c68/coverage-inventory.md

# sg13g2-ldo T1 item 5 coverage inventory (DR-0007 ten rows)

Generated by `sim/ldo-cmos5l-pvt-sweep/item5_evidence.py`; do not edit by hand.
Reproduce: `python3 sim/ldo-cmos5l-pvt-sweep/item5_evidence.py --check`.

- Coverage accounting, not compliance. Only row 4 is ratified (DR-0007); nine rows are Open and are informational here, never upgraded to ratified passes.
- Every number is derived from committed SG13CMOS5L raw data or carried from the committed record CSV. Nothing is transferred to SG13G2 (#71).
- No new simulation was run. No klt sim envelope was produced; see klt_sim_envelope.

## klt sim envelope

- produced: **False**
- The raw grid now comes from 22 klt sim batch requests (reports under corners/<record>/_batch/). Those requests declare no limits, and the metrics are reduced from rawfiles outside klt, so they are measurement runs, not a corner-matrix envelope graded against the ratified spec. klt sim's batch backend still refuses models.pdk=ihp-sg13cmos5l (klayout-tools#2727), and the runner's klt 0.5.0 ignores options.osdi_preload (klayout-tools#2901), so the runs depend on staged libraries and a body-level pre_osdi preamble. A success envelope is never synthesized or hand-wrapped from the CSVs.
- tool gap: 2AMLogic/klayout-tools#2727; 2AMLogic/klayout-tools#2901
- signoff item 5: uncited / unmet; signoff/sg13g2-ldo.json is unchanged

## Provenance caveats

- Record 20261011-070111-5391c68 was made by run_sweep.sh --batch --loopgain-ac-max=10g at issue #128 branch commit 5391c68, which may not resolve after a squash merge. All 22 of its fleet requests were submitted afresh (no reused reports). Its netlist snapshots .include the design by an absolute worktree path, but the record md states the sha256 of both design netlists it ran against, and those equal the pins here, so netlist freshness is recorded rather than inferred. Only the loop-gain AC ceiling differs from the previous record 20261011-051956-eda9285 (10 GHz instead of 100 MHz); every DC and PSRR column of the PVT csv is identical to it.
- Every point ran on the EDA batch fleet (runner klt 0.5.0, ngspice-46) at PDK commit 607e18d (sim/pdk-cmos5l.json). The six OSDI binaries, including cap_cmomi, were staged from the submitting host's build, and their sha256 appears in every per-point log. The rawfile-to-wrdata reduction reproduced six points of the local ngspice-46 record 20260917-023832-7061e8f byte-for-byte (sim/ldo-cmos5l-pvt-sweep/backend-validation/20261010-025044/).
- The design under test carries the #67 EN interface (DR-0008) and the #89 G1 disable pull-down inside the error amplifier (DR-0008 addendum), with EN tied to VIN in every bench, so the pull-down is off. The disabled state is not part of this grid.
- Cap model: cornerCAP.lib maps every section to one nominal cap_cmomi, so Cc has no process-corner spread; this affects the AC rows (6, 10) not the DC grid used here.
- Reference is an ideal 0.90 V source; supply is swept 2.00-3.63 V; Ibias is an ideal 2 uA sink; loads are ideal DC current sources; Cout = 1 uF is irrelevant at DC.

## Ten-row inventory

| # | Row | DR-0007 | Type | Unit | Gate | Measured verdict | Binding corner |
|---|---|---|---|---|---|---|---|
| 1 | Input | open | D | V | none | informational: regulation window reproduced at DC; device-rating gate unevidenced | - |
| 2 | Output | open | S | V | none | informational: corner-only spread inside the band; statistical row, not decidable by corners | - |
| 3 | Load | open | D | A | none | informational: DC load span covered; dynamic coverage absent | - |
| 4 | Dropout @ 50 mA | ratified | D | V | ratified requirement; gate NOT closed by this evidence | legacy metric < 0.3 V at 45/45 points (36 floor-limited upper bounds, 9 resolved crossings, 0 never in regulation, 0 invalid grids); worst 0.24 V. QUALIFIED evidence only: no klt sim envelope, definition unresolved (#70), SG13G2 branch unevidenced (#71). Not a completeness or definitive-margin claim. | ss/125C/res_wcs |
| 5 | Line / load regulation | open | D | mV/V ; % | none | informational: see worst values; invalid (out-of-regulation) points are counted, not dropped | - |
| 6 | PSRR | open | D | dB | none | informational: carried from the record unchanged; not re-derived here (AC data) | ss/125C/res_wcs |
| 7 | Iq (excl. load) | open | D | A | none | informational: no-load and full-load Iq both < 30 uA at 45/45 points; resolution = 9-digit print quantum (1e-10 A), solver-noise proxy at that floor | ff/125C/res_bcs |
| 8 | Current limit | open | S | A | none | not implemented | - |
| 9 | Startup | open | D | s | none | not implemented | - |
| 10 | Stability | open | D | deg ; dB | none | informational: plumbing-grade subset of the row only; carried from the record unchanged | ss/125C/res_bcs |

## Per-row detail

### Row 1: Input (open)

- target: 3.3 V +/-10 %
- definition: Supply window 2.97-3.63 V over which the regulator holds VOUT within 1 % of 1.8 V.
- PDK branch: SG13CMOS5L closed-loop (design/sg13cmos5l); SG13G2 branch: no closed-loop evidence (behavioural error-amp placeholder; #71).
- tested axes: Vin 2.00-3.63 V step 10 mV x Iload {0,12.5,25,37.5,50} mA x 45 PVT-resistor points (DC).
- untested axes: Continuous-short |Vsg| <= 3.3 V gate at 3.63 V (no limiter, #63); normal-regulation |Vgs| check; SG13G2 branch.
- evidence: sim/ldo-cmos5l-pvt-sweep/records/20261011-070111-5391c68.csv, sim/ldo-cmos5l-pvt-sweep/corners/20261011-070111-5391c68
- open issues: #63, #71
- in_regulation_at_both_window_ends_noload: 45/45
- in_regulation_at_both_window_ends_50mA: 45/45

### Row 2: Output (open)

- target: 1.8 V +/-2 % (fixed)
- definition: No-load VOUT at Vin = 3.30 V with an IDEAL 0.90 V reference (regulator-only; excludes reference error and offset/mismatch).
- PDK branch: SG13CMOS5L closed-loop (design/sg13cmos5l); SG13G2 branch: no closed-loop evidence (behavioural error-amp placeholder; #71).
- tested axes: PVT-resistor corners only; deterministic.
- untested axes: Monte Carlo offset/divider mismatch (#56); reference error.
- evidence: sim/ldo-cmos5l-pvt-sweep/records/20261011-070111-5391c68.csv
- open issues: #56
- n_points: 45
- n_valid: 45
- n_invalid: 0
- worst_value: 1.80065381
- worst_at / corner: ff
- worst_at / temp_c: 125
- worst_at / res_section: res_wcs

### Row 3: Load (open)

- target: 0-50 mA (no external preload assumed)
- definition: DC regulation at five load points 0-50 mA; in regulation = |VOUT-1.8| < 1 % of 1.8 V.
- PDK branch: SG13CMOS5L closed-loop (design/sg13cmos5l); SG13G2 branch: no closed-loop evidence (behavioural error-amp placeholder; #71).
- tested axes: Iload x5 DC; Vin 2.00-3.63 V.
- untested axes: Dynamic/no-preload stability at 0 mA (#64); stretch 100 mA.
- evidence: sim/ldo-cmos5l-pvt-sweep/records/20261011-070111-5391c68.csv, sim/ldo-cmos5l-pvt-sweep/corners/20261011-070111-5391c68
- open issues: #64
- points_in_regulation_at_50mA_by_vin / 2p97: 45/45
- points_in_regulation_at_50mA_by_vin / 3p30: 45/45
- points_in_regulation_at_50mA_by_vin / 3p63: 45/45

### Row 4: Dropout @ 50 mA (ratified)

- target: < 300 mV worst corner
- definition: LEGACY metric: lowest Vin on the 10 mV grid at which VOUT >= 0.99 x 1.8 V (scanning down from 3.63 V) minus the fixed 1.8 V target. NOT Vin - actual VOUT at 1 % loss; that definition is unresolved (#70).
- PDK branch: SG13CMOS5L closed-loop (design/sg13cmos5l); SG13G2 branch: no closed-loop evidence (behavioural error-amp placeholder; #71).
- tested axes: Iload = 50 mA; Vin 2.00-3.63 V step 10 mV (sweep floor 0.20 V); 45 PVT-resistor points.
- untested axes: Stretch < 200 mV (not ratified); finer sweep below the floor; definition per #70; SG13G2 branch (#71, unevidenced/unmet); post-layout (#57).
- evidence: sim/ldo-cmos5l-pvt-sweep/records/20261011-070111-5391c68.csv, sim/ldo-cmos5l-pvt-sweep/corners/20261011-070111-5391c68, sim/ldo-cmos5l-pvt-sweep/evidence/20261011-070111-5391c68/dc-informational-summary.csv
- open issues: #70, #71, #57
- status counts (45 points): {'floor_limited_upper_bound': 36, 'resolved_crossing': 9}
- legacy worst: 0.24 at ss/125C/res_wcs (45/45 valid)
- #70 candidate (Vin - actual VOUT, resolved points only, informational): 0.254629 at ss/125C/res_bcs (9/45 valid)

### Row 5: Line / load regulation (open)

- target: < 5 mV/V; < 1 % over full load, inside the accuracy window
- definition: Line: |dVOUT/dVin| over 2.97-3.63 V at each load. Load: (V(0 mA)-V(50 mA))/V(0 mA) at fixed Vin. A value is VALID only if both end points are within 1 % of 1.8 V.
- PDK branch: SG13CMOS5L closed-loop (design/sg13cmos5l); SG13G2 branch: no closed-loop evidence (behavioural error-amp placeholder; #71).
- tested axes: Line at 5 loads; load regulation at Vin 2.97/3.30/3.63 V; 45 points; DC.
- untested axes: Accuracy-window coupling with row 2 (statistical, #56); dynamic regulation.
- evidence: sim/ldo-cmos5l-pvt-sweep/evidence/20261011-070111-5391c68/dc-informational-summary.csv, sim/ldo-cmos5l-pvt-sweep/corners/20261011-070111-5391c68
- open issues: #56
- line_worst_by_load / 0mA: 0.245773 at ff/125C/res_wcs (45/45 valid)
- line_worst_by_load / 12p5mA: 0.179455 at ff/125C/res_wcs (45/45 valid)
- line_worst_by_load / 25mA: 0.176318 at ff/125C/res_wcs (45/45 valid)
- line_worst_by_load / 37p5mA: 0.176 at fs/125C/res_wcs (45/45 valid)
- line_worst_by_load / 50mA: 0.177864 at fs/125C/res_wcs (45/45 valid)
- load_reg_worst_by_vin / 2p97: 0.0228476 at ff/125C/res_wcs (45/45 valid)
- load_reg_worst_by_vin / 3p30: 0.0237136 at ff/125C/res_wcs (45/45 valid)
- load_reg_worst_by_vin / 3p63: 0.0253757 at ff/125C/res_wcs (45/45 valid)

### Row 6: PSRR (open)

- target: > 50 dB @ 1 kHz, > 20 dB @ 100 kHz
- definition: Closed-loop AC supply-to-output rejection from the committed record.
- PDK branch: SG13CMOS5L closed-loop (design/sg13cmos5l); SG13G2 branch: no closed-loop evidence (behavioural error-amp placeholder; #71).
- tested axes: Vin = 3.30 V, Iload = 1 mA, Cout = 1 uF, ESR = 0, 45 points; Cc nominal (no corner spread).
- untested axes: 50 mA, Cout/ESR window (#64); Cc corner spread (record: insufficient-evidence).
- evidence: sim/ldo-cmos5l-pvt-sweep/records/20261011-070111-5391c68.csv
- open issues: #64
- 1kHz_min: 53.6429 at ss/125C/res_wcs (45/45 valid)
- 100kHz_min: 33.2341 at ff/27C/res_bcs (45/45 valid)

### Row 7: Iq (excl. load) (open)

- target: < 30 uA at no load and at full load
- definition: |i(Vin)| minus the load current, at Vin = 3.30 V (includes bias and divider standing current).
- PDK branch: SG13CMOS5L closed-loop (design/sg13cmos5l); SG13G2 branch: no closed-loop evidence (behavioural error-amp placeholder; #71).
- tested axes: No load and 50 mA (and intermediate loads in the CSV); Vin 3.30 V; 45 points.
- untested axes: Other supplies; stretch < 10 uA is not met by the data.
- evidence: sim/ldo-cmos5l-pvt-sweep/evidence/20261011-070111-5391c68/dc-informational-summary.csv, sim/ldo-cmos5l-pvt-sweep/records/20261011-070111-5391c68.csv
- open issues: none
- no_load_worst: 2.47222e-05 at ss/125C/res_bcs (45/45 valid)
- full_load_worst: 2.48874e-05 at ff/125C/res_bcs (45/45 valid)
- full_load_print_resolution_a: 1e-10
- full_load_noise_proxy_worst_a: 1.000000082740371e-10
- target_a: 3e-05

### Row 8: Current limit (open)

- target: 65-80 mA brickwall over PVT; short-survivable
- definition: Not defined by any bench: no limiter exists.
- PDK branch: none
- tested axes: none
- untested axes: everything
- evidence: none
- open issues: #63, #56

### Row 9: Startup (open)

- target: monotonic, controlled ramp, inside +/-2 % within 3 ms of enable
- definition: Not defined by any bench: no enable input or transient bench exists.
- PDK branch: none
- tested axes: none
- untested axes: everything
- evidence: none
- open issues: #67, #68, #69

### Row 10: Stability (open)

- target: 0-50 mA, C_out 0.33-4.7 uF, ESR 0-500 mOhm; PM >= 45 deg, GM >= 10 dB worst corner
- definition: Loop broken at FB; phase/gain margin from the committed record.
- PDK branch: SG13CMOS5L closed-loop (design/sg13cmos5l); SG13G2 branch: no closed-loop evidence (behavioural error-amp placeholder; #71).
- tested axes: One (Cout, ESR, Iload) point: 1 uF, 0 ohm, 1 mA; Vin 3.30 V; 45 points; Cc nominal.
- untested axes: Rest of the load/Cout/ESR window (#64); Cc corner spread.
- evidence: sim/ldo-cmos5l-pvt-sweep/records/20261011-070111-5391c68.csv
- open issues: #64
- phase_margin_min: 53.8708 at ss/125C/res_bcs (45/45 valid)
- gain_margin_min: 13.8449 at ff/-40C/res_wcs (45/45 valid)
