2AMLogic/sg13g2-ldo/sim/ldo-cmos5l-pvt-sweep/backend-validation/20261010-025044/queue.tsv

dcsweep_tt_27c_rtyp | /tmp/pr87-val/decks/dcsweep_tt_27c_rtyp.spice
loopgain_tt_27c_rtyp | /tmp/pr87-val/decks/loopgain_tt_27c_rtyp.spice
psrr_tt_27c_rtyp | /tmp/pr87-val/decks/psrr_tt_27c_rtyp.spice
dcsweep_ss_125c_rbcs | /tmp/pr87-val/decks/dcsweep_ss_125c_rbcs.spice
loopgain_ss_125c_rbcs | /tmp/pr87-val/decks/loopgain_ss_125c_rbcs.spice
psrr_ss_125c_rbcs | /tmp/pr87-val/decks/psrr_ss_125c_rbcs.spice
