2AMLogic/sg13g2-ldo/sim/ldo-cmos5l-pvt-sweep/backend-validation/20261010-variant-lines/merged/_batch/points.tsv

point_id | group | process | temperature_c
loopgain_dyn_ff_-40c_rwcs_i0ua_c330nf_e0mohm | g00_loopgain_dyn_ff_-40c_rwcs_i0ua_c330nf_e0mohm | mos_ff__res_wcs__cap_typ__v8c5129e3822e | -40
loopgain_dyn_ff_27c_rbcs_i0ua_c330nf_e0mohm | g00_loopgain_dyn_ff_-40c_rwcs_i0ua_c330nf_e0mohm | mos_ff__res_bcs__cap_typ__v8c5129e3822e | 27
loopgain_dyn_ss_125c_rbcs_i0ua_c330nf_e0mohm | g00_loopgain_dyn_ff_-40c_rwcs_i0ua_c330nf_e0mohm | mos_ss__res_bcs__cap_typ__v8c5129e3822e | 125
loopgain_dyn_ss_125c_rwcs_i0ua_c330nf_e0mohm | g00_loopgain_dyn_ff_-40c_rwcs_i0ua_c330nf_e0mohm | mos_ss__res_wcs__cap_typ__v8c5129e3822e | 125
loopgain_dyn_ff_-40c_rwcs_i0ua_c330nf_e250mohm | g00_loopgain_dyn_ff_-40c_rwcs_i0ua_c330nf_e0mohm | mos_ff__res_wcs__cap_typ__vf3ae0f852e88 | -40
loopgain_dyn_ff_27c_rbcs_i0ua_c330nf_e250mohm | g00_loopgain_dyn_ff_-40c_rwcs_i0ua_c330nf_e0mohm | mos_ff__res_bcs__cap_typ__vf3ae0f852e88 | 27
loopgain_dyn_ss_125c_rbcs_i0ua_c330nf_e250mohm | g00_loopgain_dyn_ff_-40c_rwcs_i0ua_c330nf_e0mohm | mos_ss__res_bcs__cap_typ__vf3ae0f852e88 | 125
loopgain_dyn_ss_125c_rwcs_i0ua_c330nf_e250mohm | g00_loopgain_dyn_ff_-40c_rwcs_i0ua_c330nf_e0mohm | mos_ss__res_wcs__cap_typ__vf3ae0f852e88 | 125
loopgain_dyn_ff_-40c_rwcs_i0ua_c330nf_e500mohm | g00_loopgain_dyn_ff_-40c_rwcs_i0ua_c330nf_e0mohm | mos_ff__res_wcs__cap_typ__va3e522110e2d | -40
loopgain_dyn_ff_27c_rbcs_i0ua_c330nf_e500mohm | g00_loopgain_dyn_ff_-40c_rwcs_i0ua_c330nf_e0mohm | mos_ff__res_bcs__cap_typ__va3e522110e2d | 27
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
psrr_dyn_ss_125c_rbcs_i1000ua_c1000nf_e0mohm | g01_psrr_dyn_ff_-40c_rwcs_i0ua_c330nf_e0mohm | mos_ss__res_bcs__cap_typ__vf5d9da3b1c2f | 125
psrr_dyn_ss_125c_rwcs_i1000ua_c1000nf_e0mohm | g01_psrr_dyn_ff_-40c_rwcs_i0ua_c330nf_e0mohm | mos_ss__res_wcs__cap_typ__vf5d9da3b1c2f | 125
