2AMLogic/sg13g2-ldo/sim/ldo-cmos5l-pvt-sweep/backend-validation/20261010-025044/_batch/g00_dcsweep_tt_27c_rtyp/dcsweep_tt_27c_rtyp.corner.cir

* klt sim -- generated corner deck, do not edit
.lib /var/tmp/eda-job-klt-sim-b2d9e10b945a/inputs/corners.lib mos_tt__res_typ__cap_typ
.include /var/tmp/eda-job-klt-sim-b2d9e10b945a/inputs/netlist.cir
.temp 27
.meas dc liveness_vout FIND v(vout) AT=3.3
.control
set filetype=ascii
dc Vin 2.00 3.63 0.01 Iload 0 0.05 0.0125
write /var/tmp/eda-job-klt-sim-b2d9e10b945a/outputs/artifacts/mos_tt__res_typ__cap_typ_novdd_27C/waveform.raw
quit
.endc
.end
