2AMLogic/sg13g2-ldo/sim/ldo-cmos5l-pvt-sweep/backend-validation/20261010-025044/_batch/g01_dcsweep_ss_125c_rbcs/dcsweep_ss_125c_rbcs.corner.cir

* klt sim -- generated corner deck, do not edit
.lib /var/tmp/eda-job-klt-sim-6564eda4a5a5/inputs/corners.lib mos_ss__res_bcs__cap_typ
.include /var/tmp/eda-job-klt-sim-6564eda4a5a5/inputs/netlist.cir
.temp 125
.meas dc liveness_vout FIND v(vout) AT=3.3
.control
set filetype=ascii
dc Vin 2.00 3.63 0.01 Iload 0 0.05 0.0125
write /var/tmp/eda-job-klt-sim-6564eda4a5a5/outputs/artifacts/mos_ss__res_bcs__cap_typ_novdd_125C/waveform.raw
quit
.endc
.end
