2AMLogic/sg13g2-ldo/sim/ldo-cmos5l-pvt-sweep/backend-validation/20261010-025044/_batch/g02_loopgain_tt_27c_rtyp/loopgain_tt_27c_rtyp.corner.cir

* klt sim -- generated corner deck, do not edit
.lib /var/tmp/eda-job-klt-sim-1bb34f20486a/inputs/corners.lib mos_tt__res_typ__cap_typ
.include /var/tmp/eda-job-klt-sim-1bb34f20486a/inputs/netlist.cir
.temp 27
.meas ac liveness_vout FIND vm(vout) AT=1
.control
set filetype=ascii
ac dec 20 1 100meg
write /var/tmp/eda-job-klt-sim-1bb34f20486a/outputs/artifacts/mos_tt__res_typ__cap_typ_novdd_27C/waveform.raw
quit
.endc
.end
