2AMLogic/sg13g2-ldo/sim/ldo-cmos5l-pvt-sweep/backend-validation/20261010-025044/_batch/g03_loopgain_ss_125c_rbcs/loopgain_ss_125c_rbcs.corner.cir

* klt sim -- generated corner deck, do not edit
.lib /var/tmp/eda-job-klt-sim-0dcd70080a67/inputs/corners.lib mos_ss__res_bcs__cap_typ
.include /var/tmp/eda-job-klt-sim-0dcd70080a67/inputs/netlist.cir
.temp 125
.meas ac liveness_vout FIND vm(vout) AT=1
.control
set filetype=ascii
ac dec 20 1 100meg
write /var/tmp/eda-job-klt-sim-0dcd70080a67/outputs/artifacts/mos_ss__res_bcs__cap_typ_novdd_125C/waveform.raw
quit
.endc
.end
