2AMLogic/sg13g2-ldo/sim/ldo-cmos5l-pvt-sweep/backend-validation/20261010-variant-lines/merged/_batch/g00_loopgain_dyn_ff_-40c_rwcs_i0ua_c330nf_e0mohm/loopgain_dyn_ff_-40c_rwcs_i0ua_c1000nf_e0mohm.corner.cir

* klt sim -- generated corner deck, do not edit
.lib /var/tmp/eda-job-klt-sim-68f5dbddceae/inputs/corners.lib mos_ff__res_wcs__cap_typ__vdf4ddbd70a4a
.include /var/tmp/eda-job-klt-sim-68f5dbddceae/inputs/netlist.cir
.temp -40
.meas ac liveness_vout FIND vm(vout) AT=1
.control
set filetype=ascii
ac dec 20 1 100meg
write /var/tmp/eda-job-klt-sim-68f5dbddceae/outputs/artifacts/mos_ff__res_wcs__cap_typ__vdf4ddbd70a4a_novdd_n40C/waveform.raw
quit
.endc
.end
