2AMLogic/sg13g2-ldo/(commit log)

2026-08-20 Initial commit: low-dropout regulator on IHP SG13G2
    Scaffolds the block: spec, schematics, ngspice sim, and klayout-tools-driven
    layout signoff.
    A port, not a new design: the block starts from the fleet's proven LDOs
    (gf180-ldo, sky130-ldo) — schematics, specs, and decision records — so that
    anything which breaks is attributable to the PDK, the deck, or the tools
    rather than the circuit. SG13G2's real bipolar devices reopen the pass-device
    and error-amp choices; departures go through decision records.
    The curated SG13G2 DRC/LVS deck in klayout-tools is new and starter-grade;
    finding its gaps and filing them upstream is part of this canary's job.
    Apache-2.0. Nothing designed yet.
    Co-A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
2026-08-20 spec: add porting plan for gf180-ldo/sky130-ldo -> sg13g2-ldo (#2)
    Reads both sibling repos' spec trees and decision records end to end and
    writes spec/porting-plan.md covering what carries over as port-parity
    baseline, what SG13G2's BiCMOS device set (native 3.3V HV CMOS plus HBTs)
    changes for the pass device and error amplifier, and where the starter-grade
    klayout-tools SG13G2 deck (klayout-tools #911) is thin (19 DRC rules,
    MOS-only LVS extraction, no bipolar/resistor/capacitor recognition, no
    parasitics) so layout-stage gaps are recognized as deck gaps rather than
    design bugs. Ends with the ordered list of decision records this port
    expects to need.
    Closes #1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
2026-08-24 design: forward-designed SG13G2 LDO core schematic + reproducible netlist (#7)
    T1 item 1 (design sources, #5's gap tracker) for the bronze evidence
    ladder: commits ldo_core.sch/.sym (sg13_hv_pmos common-source pass device,
    plain-resistor feedback divider, external VREF port), a behavioral
    ldo_erramp_placeholder.sch/.sym error amp, the derived ERC-clean netlist
    under design/netlist/, and design/netlist.py (export + --check
    reproducibility gate) plus design/xschemrc pointing at the pinned SG13G2
    PDK install. Forward-designed against ihp-sg13g2's own device menu per
    spec/porting-plan.md -- not copied or mechanically translated from
    gf180-ldo's or sky130-ldo's schematics; pass-device sizing and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
    [ldo_core.sch, ldo_erramp_placeholder.sch]
2026-08-25 ci: wire design/netlist.py --check into GitHub Actions (#9)
    * ci: wire design/netlist.py --check into GitHub Actions
    Adds .github/workflows/ci.yml so a schematic edit that forgets to re-run
    the xschem export, or that breaks ERC, fails the PR instead of relying on
    someone remembering to run `design/netlist.py --check` by hand.
    The job checks out a pinned ref (v0.3.0) of 2AMLogic/klayout-tools to reuse
    its scripts/fetch-ihp-sg13g2.sh (checksum-verified IHP-Open-PDK v0.3.0
    fetch), installs xschem via apt, caches the ~350 MB PDK fetch across runs,
    and runs `python3 design/netlist.py --check -v` against it. Runs on every
    push/PR (not gated) since this repo has no PDK-free self-test tier to spli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
2026-08-25 ratification: install the two-key reviewer variant (EE key + market key) (#3)
    Installs the generated public reviewer variants — ratification/ee-key/
    and ratification/market-key/ — scoped to this repo's block class
    (ldo), mirroring the six prior installs (e.g. sky130-ldo#53, gf180-ldo).
    Part of 2AMLogic/2am#525 (2AMLogic/2am#372 Phase C2 follow-up, Pass 1 of
    the "5 ready canaries" batch).
2026-08-27 ratification: fix inaccurate market-key MANIFEST.md comp-data list (#11)
    The section listed all 4 original COMP_CLASSES entries
    (ldo, pll, sar-adc, bandgap) instead of the single comp file this repo
    actually carries in ratification/market-key/comps/ — the installer
    committed generate-canary-variant.py's raw output instead of hand-scoping
    it per canary-variant.md's install procedure.
    Not a disclosure leak (every listed filename names another public
    canary's own block class); a documentation-accuracy fix only.
    Part of 2AMLogic/2am#589
2026-09-05 feat(champion): standing authorization for design-evidence auto-merge (#6850)
    Operator ruling 2026-09-05: Judge-approved, green-CI PRs whose entire
    changed-file set lives in design/, sim/, layout/, measurements/,
    verification/, or docs/ auto-merge without the four-axis human hold.
    Rationale: canary design evidence is fully revertible with no fleet-infra
    blast radius, and the held-PR pattern (sky130-sar-adc#123 sat mergeable for
    days as the sole blocker of a layout chain) costs more than it protects
    here. spec/ and every tool surface fall outside the patterns, so the
    exact-subset rule keeps them on the four-axis judgment automatically.
    C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
2026-09-09 sim: sg13_hv_pmos pass-device screening deck (issue #13) (#15)
    * sim: sg13_hv_pmos pass-device screening deck (issue #13)
    Stands up sim/ per the sibling convention (pdk.json, env.sh, tools/
    build-osdi.sh) and adds sim/pass-device-screening/: a bare sg13_hv_pmos
    device deck that measures Vth, Ron*W and Cgate at the dropout test
    point (Vin=2.10V, Vout=1.80V) and terminal voltage/current stress at
    the continuous-short current-limit condition (Vout=0V, Vin=3.63V),
    across the full {tt,ss,ff,sf,fs} x {-40,27,125}C corner grid (120
    simulation points), at both a Ron*W-normalized W=1um and the
    schematic's as-drawn W=300um.
    Verified against a real ihp-sg13g2 PDK install + OSDI-compiled PSP103
    models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
    [20260909-220347-ed18110.csv, dropout_w1u_l0.4u_ff_-40c_dc.csv, dropout_w1u_l0.4u_ff_125c_dc.csv, dropout_w1u_l0.4u_ff_27c_dc.csv, dropout_w1u_l0.4u_fs_-40c_dc.csv, dropout_w1u_l0.4u_fs_125c_dc.csv, dropout_w1u_l0.4u_fs_27c_dc.csv, dropout_w1u_l0.4u_sf_-40c_dc.csv]
2026-09-10 spec: ratify DR-0001 (sg13_hv_pmos pass-device flavor) (#16)
    Ratifies the sg13_hv_pmos common-source pass-device hypothesis
    (spec/porting-plan.md §2.1) against the measured screening data from
    sim/pass-device-screening/records/20260909-220347-ed18110.{md,csv}
    (issue #13/PR #15). The hypothesis is confirmed, not rejected.
    Explicitly addresses the |Vsg| = 3.63V vs. the PDK's 3.3V max VGS
    rating finding: the disposition is that the eventual current-limit
    loop (spec/porting-plan.md §4 item 6) is expected to keep |Vsg|
    within rating during a real fault, since a current-limit loop's
    whole job is to reduce gate drive under fault, not increase it. That
    loop's own decision record inherits this as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
2026-09-10 docs: resync ci.yml README with the pass-device-screening-check job (#18)
    .github/workflows/README.md was last updated when ci.yml had only one
    job (netlist-check) and had never been touched since
    pass-device-screening-check landed in 8bf4fb0 (PR #15, issue #13). Fix
    the two resulting false claims: the opening line ("nothing more") and
    the "No sim/ harness self-test" known-gap bullet, mirroring ci.yml's
    own header comment and sim/README.md's "CI: syntax/--check-env only,
    never a records/ entry" note.
    Closes #17
2026-09-16 spec: add DR-0002, SG13CMOS5L device topology (pass device + error amp) (#23)
    Phase 1/4 of the SG13CMOS5L port (#19, tracked by #12, Epic 2AMLogic/2am#542
    Phase 5A). Drafts the device-topology decision record as a PR on the
    evidence, per the fleet ratification policy in 2AMLogic/2am#357 — operator
    approval of this PR is the ratification act.
    Evidence was re-derived by reading the installed PDK tree directly at
    ~/share/pdk/ihp-sg13cmos5l @ 607e18d (libs.tech/ngspice/models/,
    libs.tech/ngspice/osdi/, libs.tech/xschem/sg13cmos5l_pr/,
    libs.tech/klayout/tech/lvs/), cross-checked against the PDK's own
    SG13CMOS5L_os_process_spec.pdf Rev. 0.2 — not inherited from any summary
    document or from th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
2026-09-16 design: SG13CMOS5L schematic capture (ldo_core_cmos5l + real OTA error amp) (#24)
    Phase 2/4 of the SG13CMOS5L port (#12, Epic 2AMLogic/2am#542 Phase 5A).
    Captures the topology ratified by
    spec/decision-records/DR-0002-sg13cmos5l-device-topology.md (PR #23)
    against the ihp-sg13cmos5l PDK, in a new design/sg13cmos5l/ directory that
    does not collide with the SG13G2 sources.
    New cells:
    * ldo_core_cmos5l -- sg13_hv_pmos common-source Mpass (DR-0002 (a)),
    behavioral feedback divider, external VREF, and a new IBIAS port.
    * ldo_erramp_cmos5l -- the real two-stage, Miller-compensated,
    single-ended-output all-HV OTA DR-0002 (b) ratifies, replacing the
    SG13G2 branch's ideal-VCVS placeholder: sg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
    [ldo_core_cmos5l.sch, ldo_erramp_cmos5l.sch]
2026-09-16 sim: PVT-cornered closed-loop verification for the SG13CMOS5L LDO (#21) (#26)
    Adds sim/ldo-cmos5l-pvt-sweep/: the first circuit-level (closed-loop) PVT
    verification in this repo on either PDK branch, instantiating
    design/sg13cmos5l/ldo_core_cmos5l.sch across the full
    {tt,ss,ff,sf,fs}x{-40,27,125}C grid via three benches (closed-loop DC
    sweep, loop-gain via a break at the high-impedance FB->amp-input node,
    closed-loop PSRR), plus a Cc-value and Rz-corner sensitivity sweep to
    bound the PDK's uncharacterized MoM-cap caveat per design/README.md's own
    "PDK caveats honoured" table.
    Records the SG13CMOS5L PDK commit pin (sim/pdk-cmos5l.json, 607e18d,
    re-verified against the installed checkout) and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
    [20260916-083154-7aa1d3f.csv, 20260916-083154-7aa1d3f.sensitivity.csv, dcsweep_ff_-40c_dc.csv, dcsweep_ff_125c_dc.csv, dcsweep_ff_27c_dc.csv, dcsweep_fs_-40c_dc.csv, dcsweep_fs_125c_dc.csv, dcsweep_fs_27c_dc.csv]
2026-09-16 design: resize SG13CMOS5L Mpass and re-derive error-amp compensation (#27)
    * design: resize SG13CMOS5L Mpass and re-derive error-amp compensation
    Mpass w=300u->2800u fixes the 4-7x dropout failure and the 4 corners
    that never reached regulation in issue #21's closed-loop PVT sweep.
    Cc/Rz (30u->100u/30u, 5.3u->1200u) plus Mtail/Mload2 mirror ratios
    (m=2/4->3/6) re-derive the error-amp compensation to close the
    near-zero phase/gain margin gap #21 found -- the enlarged Rz places a
    deliberate phase-lead zero near the loop's unity-gain crossover rather
    than only cancelling the Miller stage's RHP zero.
    Adds DR-0003 documenting the pole/zero re-derivation and the PSRR
    trade-off encountered along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
    [20260916-112842-c25ff53.csv, 20260916-112842-c25ff53.sensitivity.csv, dcsweep_ff_-40c_dc.csv, dcsweep_ff_125c_dc.csv, dcsweep_ff_27c_dc.csv, dcsweep_fs_-40c_dc.csv, dcsweep_fs_125c_dc.csv, dcsweep_fs_27c_dc.csv]
2026-09-16 docs: SG13CMOS5L Chipalooza Challenge #6 proposal document (#30)
    * docs: SG13CMOS5L Chipalooza Challenge #6 proposal document
    Adds docs/chipalooza/challenge-6-proposal.md (phase 4b of the SG13CMOS5L
    port, split from #22), drafting the block/positioning, I/O-vs-slot-budget
    mapping, functional description, and a spec table re-derived directly from
    sim/ldo-cmos5l-pvt-sweep's PVT-cornered evidence (#21/#25, record
    20260916-112842-c25ff53) -- every row currently passes. Explicitly states
    that physical implementation (layout/DRC/LVS, tracked in the sibling #28)
    has not started, per CLAUDE.md's no-claim-without-a-testbench rule applied
    to process status, not just spec rows.
    Closes #29
    * docs: fi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
2026-09-16 layout: draw, DRC-verify and LVS-match the SG13CMOS5L LDO core (#32)
    * design: convert the SG13CMOS5L feedback divider to a PDK rhigh and meander Rz
    Rtop/Rbot were a generic devices/res.sym behavioral 300k -- a SPICE R
    primitive klt extract cannot see as a device, which design/README.md's
    'Known gaps on this branch' flagged as blocking the layout phase. Both
    legs are now sg13cmos5l_pr/rhigh.sym at w=1u, l=25.43u, b=7 (an eight-
    stripe meander), 300.44 kOhm per leg by the PDK symbol's own value
    expression -- +0.15% on the value they replace, with the divider ratio
    exactly 1/2 by construction since both legs are the same drawn device.
    Rz moves from l=1200u/b=0 (an undrawable 1200:1 straight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
    [ldo_core_cmos5l.sch, ldo_erramp_cmos5l.sch]
2026-09-16 refactor: drop dead drain_on_metal2/rhigh_drawn_squares, cite Vn.a for via2 (#34)
    Four hygiene items in layout/common_sg13cmos5l.py, all no-ops on the drawn
    geometry (the committed GDS reproduces byte for byte):
    - draw_mos_row: remove the drain_on_metal2 parameter and its False branch.
    Nothing called it with False, and the branch it guarded drew a Metal1
    drain strap straight through the full-width source bus -- a short, not a
    spacing violation. The Metal2 escape is now unconditional and the
    docstring says why it has to be.
    - Remove rhigh_drawn_squares: never called, and its corner-square formula
    diverged from lvs_reference.rhigh_reference_ohms, the live formula that
    is checked a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
2026-09-16 sim: PVT evidence for the SG13CMOS5L rhigh feedback divider, across the resistor corner (#31) (#38)
    * sim: cross the resistor corner and probe the divider current (#31)
    The SG13CMOS5L PVT harness could not run at all against the current
    design netlist: #28 replaced the behavioural `Rtop`/`Rbot` 300k pair with
    PDK `rhigh` instances, and `run_sweep.sh`'s assert_loopgain_topology_sync()
    plus `tb_loopgain_cmos5l.spice.tmpl`'s hand-mirrored flattened copy both
    still carried the pre-conversion lines -- the assertion fired (exit 4)
    exactly as designed. Both are re-synced to `XRtop`/`XRbot`.
    Three harness changes, all in service of issue #31's acceptance criteria:
    - The resistor corner (cornerRES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
    [20260916-210331-9d3ace1.csv, 20260916-210331-9d3ace1.delta.csv, 20260916-210331-9d3ace1.divider-attribution.csv, 20260916-210331-9d3ace1.sensitivity.csv, dcsweep_ff_-40c_rbcs_dc.csv, dcsweep_ff_-40c_rtyp_dc.csv, dcsweep_ff_-40c_rwcs_dc.csv, dcsweep_ff_125c_rbcs_dc.csv]
2026-09-17 docs: SG13G2 branch divider is 600k/3.0uA, not the 900k/2uA design/README.md claimed (#39)
    The divider is Rtop=300kΩ + Rbot=300kΩ = 600kΩ total per design/netlist/ldo_core.spice
    lines 7–8, giving 1.8V / 600kΩ = 3.0µA standing current, not the 900kΩ / 2µA that
    design/README.md's "Reference voltage" section incorrectly stated. This was an arithmetic
    error (300k + 300k = 600k, not 900k) that is now corrected with an explicit note in the
    documentation, matching the style of issue #28's correction on the SG13CMOS5L branch.
    Verified by: python3 design/netlist.py --check
    Closes #37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
2026-09-17 design: re-compensate the SG13CMOS5L error amp on Cc alone so PM >= 45 deg holds at res_bcs/125C (DR-0005) (#40)
    * design: re-compensate the SG13CMOS5L error amp on Cc alone (Cc w 100u -> 170u)
    #31 crossed cornerRES.lib's resistor corner with the full MOS x temperature
    grid for the first time and found the loop missing the ratified PM >= 45 deg
    row at res_bcs/125C at all five MOS corners (43.35-44.48 deg). DR-0004
    diagnosed the mechanism -- Rz is a PDK `rhigh`, it shrinks to ~0.60x there
    (sheet rho 0.75x compounded with a -2300e-6 tempco over 98 K), and its
    phase-lead zero moves up out of the crossover region -- and deferred the fix
    to this issue.
    The fix is Cc alone: `w` 100e-6 -> 170e-6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
    [20260917-023832-7061e8f.cc-tolerance.csv, 20260917-023832-7061e8f.csv, 20260917-023832-7061e8f.delta.csv, 20260917-023832-7061e8f.divider-attribution.csv, 20260917-023832-7061e8f.sensitivity.csv, dcsweep_ff_-40c_rbcs_dc.csv, dcsweep_ff_-40c_rtyp_dc.csv, dcsweep_ff_-40c_rwcs_dc.csv]
2026-09-18 docs: confirm rhigh-family width-offset double-count as a PDK bug (#36) (#42)
    Investigation against the installed IHP-Open-PDK v0.3.0 tree confirms
    DR-0004's "Separate observation" gap: resistors_mod.lib's rhigh, rsil,
    and rppd subckts each pre-narrow weff by the process spec's own DW*
    Line Width Delta before instancing their r3_cmc .model card, and that
    card's own xw parameter (r3_cmc.va: "width offset (total)") applies the
    identical delta a second time. SG13G2_os_process_spec.pdf gives exactly
    one DW* target per device, matched by either application alone, never
    their sum -- confirming a PDK bug rather than an intentional convention.
    Both PDK branches share the one bug (ihp-sg13cmos5l's re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
    [ldo_core_cmos5l.sch, ldo_erramp_cmos5l.sch]
2026-09-21 feat: add klt erc supply spec and report for the SG13CMOS5L LDO core (#45)
    First klt erc supply spec for an IHP SG13-family PDK (T1 item 11,
    structural power delivery). Declares VIN/VOUT/VSS as supplies on the
    rails' true GatPoly-Metal3 routing stack, with layer numbers read from
    the PDK's own sg13cmos5l.lyp and cross-checked against the curated
    sg13cmos5l extraction deck. The committed report pins the committed
    GDS's sha256 and reads erc_status clean: one electrical island per
    supply rail, zero erc.supply_short after the rhigh bodies are carved
    out via the deck's own PolyRes marker (klayout-tools#2183's documented
    devices[] fix). ties[] is deliberately omitted -- erc.missing_tie is
    not comp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
2026-09-21 feat: add klt signoff block manifest with CI-gated T1 tier report (#46)
    signoff/sg13g2-ldo.json declares block sg13g2-ldo, kind analog, and pins
    one content-hash citation per honestly-citable T1 item (3 DRC, 4 LVS, 11
    power delivery). The committed tier report is its graded output — 2/11 met,
    tier null — regenerated and gated byte-for-byte by a new PDK-free
    signoff-t1-report CI job pinned to the klt build whose grading rules
    (item-11 erc kind, citation input re-hash) postdate the v0.5.0 release.
    The three cited layout envelopes were refreshed under that same pinned
    build so each carries the post-#1969 provenance.input content hash under
    one deck vintage; extracted netlist byte-identical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
2026-09-21 chore: add reuse.lock.json in_tree entry for error amplifier (evaluate) (#48)
    Record the 2am rule-9 adopt-or-record pin: this repo's error amplifier
    (design/ldo_erramp_placeholder.sch, an ideal VCVS) duplicates the block
    built by sibling canary 2AMLogic/sg13g2-opamp. Pin it as an in_tree
    entry at status evaluate per 2am/REUSE.md; the adopt-or-keep decision
    is follow-on work once this repo has ratified amplifier spec rows.
    No imports array needed; no other files change.
    Closes #47
2026-09-22 spec: record sg13g2-opamp error-amp dependency status and adoption gaps in porting-plan §2.2/§4 (#51)
    Reconciles §2.2 with the 2am repos.yml consumes edge: names
    sg13g2-opamp as the declared (not yet adopted) sibling canary,
    records reuse.lock.json's status:evaluate and the three compatibility
    gaps (voltage class, Iq, offset) standing before adoption, and adds
    the matching resolution note to §4 item 5.
    Closes #50
2026-10-01 chore: resync installed Loom surfaces
    resynced_by: fleet-resync
    invocation: fleet-resync.sh --fleet-only --push
    <!-- loom:provenance v1 build=unknown 19f4e67fd0a0afbd3d8b6606ca91ceac911377a3 clean prompts=none sweep=none story=none trace=78a5dfbdfd8c530aecd1bb436fd096df host=loom-worker-2 base=fc3e9b3b4a33820cc6e2eefbe3ddf535bd177edc run=loom-run/v1:timer:loom-worker-2/fleet-resync:67c759f7ef3c43e38d3fa8d5f19a2dd1 installs=0.19.593 658650a4f0eff932ac66a8f690eaedf8123fc83b -->
    Loom-Story: none
    Loom-Trace-Id: 78a5dfbdfd8c530aecd1bb436fd096df
    Loom-Build: unknown 19f4e67fd0a0afbd3d8b6606ca91ceac911377a3 clean
2026-10-01 chore: resync installed Loom surfaces
    <!-- loom:provenance v1 build=unknown 56435bf476452911283e43940ecfd9a30f804af9 clean prompts=none sweep=none story=none trace=342405c5ebc99bdbf17afbd983c0c41c host=loom-worker-2 base=6092742385589f5a523f29b187c5c09aba9f5840 run=loom-run/v1:timer:loom-worker-2/fleet-resync:20c09f231d424cd5b57ca7991848dd8a installs=0.19.603 8c39bf7cde8a8c03d1aaee441f397c017b6a3a9e -->
    Loom-Trace-Id: 342405c5ebc99bdbf17afbd983c0c41c
    Loom-Build: unknown 56435bf476452911283e43940ecfd9a30f804af9 clean
    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
2026-10-01 chore: resync installed Loom surfaces
    <!-- loom:provenance v1 build=unknown f2868e6b4d60d11a8ab47d25cad9e248229d2f66 clean prompts=none sweep=none story=none trace=4e2766ed5160781df891476246a9be2e host=robb-studio base=9a0312f55029293a047dda85509ac831fa5c64ba run=loom-run/v1:timer:robb-studio/fleet-resync:2d3851d5-1673-43ae-bcc6-e5c971b37f33 installs=0.19.603 74778a6aeea5d9e06b489400942b35f33c8bb766 -->
    Loom-Trace-Id: 4e2766ed5160781df891476246a9be2e
    Loom-Build: unknown f2868e6b4d60d11a8ab47d25cad9e248229d2f66 clean
    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
2026-10-01 chore: resync installed Loom surfaces
    <!-- loom:provenance v1 build=unknown d6714830391f7596338b8de40ee2d0f45dcd12f5 clean prompts=none sweep=none story=none trace=af273f717e759e690d07f372734e9278 host=robb-pro base=a167ab95244a4e7cce52a41ca0aa088644e21be3 run=loom-run/v1:timer:robb-pro/fleet-resync:92e2f9ba-d083-411b-833b-ae52d169ef04 installs=0.19.605 6eb2b65a4496b7becb84ef1f944493a541fd01cd -->
    Loom-Trace-Id: af273f717e759e690d07f372734e9278
    Loom-Build: unknown d6714830391f7596338b8de40ee2d0f45dcd12f5 clean
    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
2026-10-01 chore: resync installed Loom surfaces
    <!-- loom:provenance v1 build=unknown e956e9fee69e53f08b887ca20e14d9058d6f9aee clean prompts=none sweep=none story=none trace=1077dafeb758858c149dd37f4ece3c77 host=loom-worker-2 base=980e1a59025a897dc16c884fa1cb905e9a932592 run=loom-run/v1:timer:loom-worker-2/fleet-resync:e3773167b12d4b3aafa1f76848245174 installs=0.19.609 ff30576dacc8c2734b1c7434bedd29c47122caeb -->
    Loom-Trace-Id: 1077dafeb758858c149dd37f4ece3c77
    Loom-Build: unknown e956e9fee69e53f08b887ca20e14d9058d6f9aee clean
    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
2026-10-01 chore: resync installed Loom surfaces
    <!-- loom:provenance v1 build=unknown 617257919edc1b9b9ee27532c5ec1b8a64523388 clean prompts=none sweep=none story=none trace=dbafe4f8526617aa07c890721298a080 host=robb-studio base=5298f61b3328b7ef9d87e374961a8a2880ff10b4 run=loom-run/v1:timer:robb-studio/fleet-resync:1817df66-02cc-4b27-927d-a38485da550a installs=0.19.610 c94891dd526cf6db5ee02045424c6913be522048 -->
    Loom-Trace-Id: dbafe4f8526617aa07c890721298a080
    Loom-Build: unknown 617257919edc1b9b9ee27532c5ec1b8a64523388 clean
    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
2026-10-01 chore: resync installed Loom surfaces
    <!-- loom:provenance v1 build=unknown a2a39ac2736eb2686e2c65412d939e67c0438a7d clean prompts=none sweep=none story=none trace=fc1a121767151aae5bd7427c683b7db6 host=robb-pro base=fb0b5903cd8136db7f4dc56d8877e0e39e79b2f2 run=loom-run/v1:timer:robb-pro/fleet-resync:708eb7c8-469d-4783-80b7-bafe142df3c4 installs=0.19.612 d25614656adcf70162da95c5e1035e99a0639a1a -->
    Loom-Trace-Id: fc1a121767151aae5bd7427c683b7db6
    Loom-Build: unknown a2a39ac2736eb2686e2c65412d939e67c0438a7d clean
    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
2026-10-01 chore: resync installed Loom surfaces
    <!-- loom:provenance v1 build=unknown 126c80914e42f913c4fc778d3ddce96daa2c7a77 clean prompts=none sweep=none story=none trace=15a20fbea7a00d0922b943088c80e19d host=loom-worker-1 base=19ce577e43a17f8a6b51b665b7c868122412d3a7 run=loom-run/v1:script:loom-worker-1/fleet-resync:ecc423da-4625-49de-b25a-692fd669a029 installs=0.19.612 53aeb18c5541af6b068247d82f62daed412cc2c6 -->
    Loom-Trace-Id: 15a20fbea7a00d0922b943088c80e19d
    Loom-Build: unknown 126c80914e42f913c4fc778d3ddce96daa2c7a77 clean
    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
2026-10-01 chore: resync installed Loom surfaces
    <!-- loom:provenance v1 build=unknown 126c80914e42f913c4fc778d3ddce96daa2c7a77 clean prompts=none sweep=none story=none trace=a0a42bd10fcfa6d7cbcc9c021c406848 host=loom-worker-2 base=8edc149ed89962770064acbdda523f674946b5f6 run=loom-run/v1:timer:loom-worker-2/fleet-resync:9e174e6bb0fa41d786e4a86e45632b6f installs=0.19.612 6f0871dc66e62b36d8382ced980d2805bfd97e50 -->
    Loom-Trace-Id: a0a42bd10fcfa6d7cbcc9c021c406848
    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
2026-10-01 chore: resync installed Loom surfaces
    <!-- loom:provenance v1 build=unknown 8891f74a5d568fe3d13937ef37fd64371dd2738f clean prompts=none sweep=none story=none trace=1e216ea76cbd2b72542049c4c18c2817 host=loom-worker-1 base=0cc7cf3433516fe1f4e316dfc4702c4e91343bf4 run=loom-run/v1:timer:loom-worker-1/fleet-resync:679feba6c0f347d39eb5943ed77dc87b installs=0.19.612 62fa67f8756bdf59fdf744be053e5ef1709f1335 -->
    Loom-Trace-Id: 1e216ea76cbd2b72542049c4c18c2817
    Loom-Build: unknown 8891f74a5d568fe3d13937ef37fd64371dd2738f clean
    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
2026-10-01 chore: resync installed Loom surfaces
    <!-- loom:provenance v1 build=unknown 6f3411c8a63e68097dde01bce8a8422230f54218 clean prompts=none sweep=none story=none trace=9aa0a46bb352b9665fdaa5f5b3b85dd7 host=robb-pro base=06594d818bae82818dd28f8ee89dc699926dc481 run=loom-run/v1:timer:robb-pro/fleet-resync:ca419e1d-6646-4678-ac7a-b263e4b5119e installs=0.19.612 7731400b3e3e1df39074564166edf656feb0999c -->
    Loom-Trace-Id: 9aa0a46bb352b9665fdaa5f5b3b85dd7
    Loom-Build: unknown 6f3411c8a63e68097dde01bce8a8422230f54218 clean
    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
2026-10-02 chore: resync installed Loom surfaces
    <!-- loom:provenance v1 build=unknown 13c0a3ef467a888520a6529ab34486ab8be826be clean prompts=none sweep=none story=none trace=41356080f367e491d5ff03f17bb98c27 host=loom-worker-2 base=22823e710f5b23f2e55ea056fde3c4d8b82ea643 run=loom-run/v1:timer:loom-worker-2/fleet-resync:44455fbcbab745abb92cea192fafbb1d installs=0.19.614 3c79f7b1d0cc14723e049cff4250ff7330804326 -->
    Loom-Trace-Id: 41356080f367e491d5ff03f17bb98c27
    Loom-Build: unknown 13c0a3ef467a888520a6529ab34486ab8be826be clean
    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
2026-10-02 chore: resync installed Loom surfaces
    <!-- loom:provenance v1 build=unknown ea2dd21f2ba310ec007d047ddfecc6cd27d220ac clean prompts=none sweep=none story=none trace=f04a67f3922788d2ccdd66578c8d18f9 host=loom-worker-1 base=ca39e5cd96ec97188cceab5a7a152a846559952a run=loom-run/v1:timer:loom-worker-1/fleet-resync:1c3b601dd998488595adc09040c007d4 installs=0.19.614 79f4897c5d3c78dbfc1b022f77d244838dbf4ccb -->
    Loom-Trace-Id: f04a67f3922788d2ccdd66578c8d18f9
    Loom-Build: unknown ea2dd21f2ba310ec007d047ddfecc6cd27d220ac clean
    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
2026-10-02 chore: resync installed Loom surfaces
    <!-- loom:provenance v1 build=unknown 6f3411c8a63e68097dde01bce8a8422230f54218 clean prompts=none sweep=none story=none trace=acb28d0049e0cc75536f96d503f6e814 host=robb-studio base=f812e577112b25cef1eaf92795a655c5efbf0530 run=loom-run/v1:timer:robb-studio/fleet-resync:85d2b1b5-e81d-40c3-ab6a-9a00efbc4ee2 installs=0.19.616 d86523eeadb32b95777f3cd3a76dd2f72f0bf792 -->
    Loom-Trace-Id: acb28d0049e0cc75536f96d503f6e814
    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
2026-10-02 chore: resync installed Loom surfaces
    <!-- loom:provenance v1 build=unknown 2b50bd69eddd038dd738465aa58a9ebca11410ac clean prompts=none sweep=none story=none trace=324e4f607054d0396cfdf8fdc01e93ae host=robb-pro base=6bc65523d9928dc8bedaae3e698dd2456bcbb208 run=loom-run/v1:timer:robb-pro/fleet-resync:a63799f1-2ad7-4946-b81d-2ec231bc2d2f installs=0.19.617 81cb2ad7e091b19d6a2b95d1add6938c2100d46b -->
    Loom-Trace-Id: 324e4f607054d0396cfdf8fdc01e93ae
    Loom-Build: unknown 2b50bd69eddd038dd738465aa58a9ebca11410ac clean
    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
2026-10-02 chore: resync installed Loom surfaces
    <!-- loom:provenance v1 build=unknown 00d92b326aed50280cd90dc116b7caec27668251 clean prompts=none sweep=none story=none trace=9a5d23cc82b6d3a1c83bfee47bd04970 host=loom-worker-2 base=85f908a80368100628c64d412bad2cfefc09ef3d run=loom-run/v1:timer:loom-worker-2/fleet-resync:12136a7a025d49f3a60b5edb04a3ff81 installs=0.19.619 4c0f505e4f0b76f8ccec07bda6d8b839030c077b -->
    Loom-Trace-Id: 9a5d23cc82b6d3a1c83bfee47bd04970
    Loom-Build: unknown 00d92b326aed50280cd90dc116b7caec27668251 clean
    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
2026-10-02 chore: resync installed Loom surfaces
    <!-- loom:provenance v1 build=unknown 456dad6d90259846313dc3bb80bf4e5471ef2d76 clean prompts=none sweep=none story=none trace=bb9688c03fb5211d06f48c8838a5505c host=robb-studio base=0386adaf8bca1703b24fafc0545adee9478a7ac0 run=loom-run/v1:timer:robb-studio/fleet-resync:e965c017-8ec7-485d-b46e-aeb399b81fb4 installs=0.19.620 0d28ba49f5a88fdb37271de9cb0144eb3442c6e3 -->
    Loom-Trace-Id: bb9688c03fb5211d06f48c8838a5505c
    Loom-Build: unknown 456dad6d90259846313dc3bb80bf4e5471ef2d76 clean
    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
2026-10-02 chore: resync installed Loom surfaces
    <!-- loom:provenance v1 build=unknown 6c6d2b6565dc13eff4c6811b9c670f452106516b clean prompts=none sweep=none story=none trace=539be979ae694d66ede516a7b5d17e41 host=robb-pro base=44331bf802656247884918760a3da5897520bcd0 run=loom-run/v1:timer:robb-pro/fleet-resync:9444d216-de08-442f-8352-ba59f6e81bb3 installs=0.19.621 a90dc1d794eb9ff70aaf939ebf495abe716f3bdd -->
    Loom-Trace-Id: 539be979ae694d66ede516a7b5d17e41
    Loom-Build: unknown 6c6d2b6565dc13eff4c6811b9c670f452106516b clean
    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
2026-10-02 chore: resync installed Loom surfaces
    <!-- loom:provenance v1 build=unknown f6d28134bfe476967e005d97424073085f55e8a3 clean prompts=none sweep=none story=none trace=27eb90670d441065f593e941066ee005 host=loom-worker-2 base=dc21292ba4a30cf81a8500cfa3c293b68e2e4bf4 run=loom-run/v1:timer:loom-worker-2/fleet-resync:04001bba930241cf9e325bf304a9270a installs=0.19.623 ccc19c2bbe2aa65328427730fa53f70eb56128c6 -->
    Loom-Trace-Id: 27eb90670d441065f593e941066ee005
    Loom-Build: unknown f6d28134bfe476967e005d97424073085f55e8a3 clean
    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
2026-10-02 chore: resync installed Loom surfaces
    <!-- loom:provenance v1 build=unknown bc461736314499b6c2c4c0ad51fb2294f60336f5 clean prompts=none sweep=none story=none trace=c3ea68717dd3a908dbbd60a35bc8b5d6 host=robb-studio base=81cc7ef190bca36d08b5e9f9006d9e3be56f7ace run=loom-run/v1:timer:robb-studio/fleet-resync:8d4c49e2-3258-4080-b0c8-082499053654 installs=0.19.623 a50aaf70069f8897c41a64b7d90783c5ab8294e0 -->
    Loom-Trace-Id: c3ea68717dd3a908dbbd60a35bc8b5d6
    Loom-Build: unknown bc461736314499b6c2c4c0ad51fb2294f60336f5 clean
    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
2026-10-02 chore: resync installed Loom surfaces
    <!-- loom:provenance v1 build=unknown bc461736314499b6c2c4c0ad51fb2294f60336f5 clean prompts=none sweep=none story=none trace=8bee8a664bfc89e0bbfbb3c2de7342ba host=loom-worker-2 base=8acea89b5e49b27d091fa5d51bae826a5fbae1a4 run=loom-run/v1:timer:loom-worker-2/fleet-resync:de2ceceb48ea4927a1334d08dc0082fe installs=0.19.624 5f49564fa78ae06f8c48d5224dae9ded04200bb7 -->
    Loom-Trace-Id: 8bee8a664bfc89e0bbfbb3c2de7342ba
    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
2026-10-03 chore: resync installed Loom surfaces
    <!-- loom:provenance v1 build=unknown 752d316233ed1a3da9e4f69ad760eb99bb477747 clean prompts=none sweep=none story=none trace=7851839b67c00a023e97cbdea1f580e1 host=robb-pro base=a3bc6e446f7ac72143ca11e19edb03526621348a run=loom-run/v1:timer:robb-pro/fleet-resync:ae492b66-dca0-4da4-acab-8d26778f2d5c installs=0.19.624 121fac45f5006879bf58a18c951b9243d9099a18 -->
    Loom-Trace-Id: 7851839b67c00a023e97cbdea1f580e1
    Loom-Build: unknown 752d316233ed1a3da9e4f69ad760eb99bb477747 clean
    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
2026-10-03 chore: resync installed Loom surfaces
    <!-- loom:provenance v1 build=unknown b34a08286a42f47f917ec46647d4d167c1f5207c clean prompts=none sweep=none story=none trace=a8e453124b899b440f42c9d83837c7b6 host=loom-worker-2 base=c3f78d7e49e9c77ca997d7a2a10b03116222c38c run=loom-run/v1:timer:loom-worker-2/fleet-resync:f02dd5df715347fe90fe14b9353a1b66 installs=0.19.624 0162badc662fb30c070e70611aa8ff74a8486d54 -->
    Loom-Trace-Id: a8e453124b899b440f42c9d83837c7b6
    Loom-Build: unknown b34a08286a42f47f917ec46647d4d167c1f5207c clean
    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
2026-10-03 chore: resync installed Loom surfaces
    <!-- loom:provenance v1 build=unknown 3437cece5ab759f772122f8d18a6d2f05d246cde clean prompts=none sweep=none story=none trace=bba21427f750636f851279cfae92b4e5 host=loom-worker-1 base=a6b2e10fe2528c8b7dab4a8bb66925d320a7b536 run=loom-run/v1:timer:loom-worker-1/fleet-resync:9440cda9476f404caa282e360a81ee03 installs=0.19.636 e41edfbb52c13982f7d8b0577f42957427a6514c -->
    Loom-Trace-Id: bba21427f750636f851279cfae92b4e5
    Loom-Build: unknown 3437cece5ab759f772122f8d18a6d2f05d246cde clean
    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
2026-10-03 chore: resync installed Loom surfaces
    <!-- loom:provenance v1 build=unknown 28040ed11a4369e20f3b7b0154a3fb2a2c35d38c clean prompts=none sweep=none story=none trace=0cd87d01c45d97a2ee57a99363fc0db2 host=robb-studio base=2ad602292b4b9f889f812fe4ca821c824af91a2c run=loom-run/v1:timer:robb-studio/fleet-resync:74b93657-6b04-4ac5-bc77-e0a1682b0595 installs=0.19.636 e41edfbb52c13982f7d8b0577f42957427a6514c -->
    Loom-Trace-Id: 0cd87d01c45d97a2ee57a99363fc0db2
    Loom-Build: unknown 28040ed11a4369e20f3b7b0154a3fb2a2c35d38c clean
    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
2026-10-03 chore: resync installed Loom surfaces
    <!-- loom:provenance v1 build=unknown 388c7fe0cad997f7a887f70c9f2cfe8781a2d512 clean prompts=none sweep=none story=none trace=2046ffd42f138a06b914f34851de3440 host=loom-worker-2 base=08a797c45659f59730885e27774be57c1af35533 run=loom-run/v1:timer:loom-worker-2/fleet-resync:17c9456bb1934c70a545b12081496cce installs=0.19.647 d1fe5dead4202be12a964ab891fd5980e7836170 -->
    Loom-Trace-Id: 2046ffd42f138a06b914f34851de3440
    Loom-Build: unknown 388c7fe0cad997f7a887f70c9f2cfe8781a2d512 clean
    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
2026-10-03 chore: resync installed Loom surfaces
    <!-- loom:provenance v1 build=unknown 8078c29e691123d91cd761a786f99cfd25f1809d clean prompts=none sweep=none story=none trace=45869a6374635c036a11a6f379fe31a4 host=robb-pro base=7eddf8e6c0eb062b1fc56a43685435e5f898a4c3 run=loom-run/v1:timer:robb-pro/fleet-resync:b0a94991-052d-4e7d-ba2b-78b971096849 installs=0.19.647 709ca4396e074e5a4d1c5e19721f6ddac7154ca2 -->
    Loom-Trace-Id: 45869a6374635c036a11a6f379fe31a4
    Loom-Build: unknown 8078c29e691123d91cd761a786f99cfd25f1809d clean
    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
2026-10-03 chore: resync installed Loom surfaces
    <!-- loom:provenance v1 build=unknown f9cba29b0602624a23daa17ae04d31d82e10fa91 clean prompts=none sweep=none story=none trace=754b3688f97b6c34894d8cfbf272b81a host=loom-worker-1 base=6227216a11d2578621bd591ba13505516795e795 run=loom-run/v1:script:loom-worker-1/fleet-resync:11eb117a-9ff3-4411-88d4-fdd7d6748639 installs=0.19.649 6f2f13b1c31ce420e2250ae040d8e1050c0e761b -->
    Loom-Trace-Id: 754b3688f97b6c34894d8cfbf272b81a
    Loom-Build: unknown f9cba29b0602624a23daa17ae04d31d82e10fa91 clean
    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
2026-10-03 chore: resync installed Loom surfaces
    <!-- loom:provenance v1 build=unknown f9cba29b0602624a23daa17ae04d31d82e10fa91 clean prompts=none sweep=none story=none trace=544a028e3829d4020b8aaa144e5fa628 host=robb-studio base=9d016c3dce1f866603ef9207aef89f484205c2f9 run=loom-run/v1:script:robb-studio/fleet-resync:5b5b8b83-7139-447d-88bd-417dcf375aa6 installs=0.19.649 6f2f13b1c31ce420e2250ae040d8e1050c0e761b -->
    Loom-Trace-Id: 544a028e3829d4020b8aaa144e5fa628
    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
2026-10-03 chore: resync installed Loom surfaces
    <!-- loom:provenance v1 build=unknown f9cba29b0602624a23daa17ae04d31d82e10fa91 clean prompts=none sweep=none story=none trace=1057aaaf811f6dd2d64a3bb6d4b3ac49 host=robb-pro base=9ef8737e34de0094301a58cb7d81d027d94b4381 run=loom-run/v1:timer:robb-pro/fleet-resync:785c1ea0-d7f2-4810-99e9-cd9368aebe0c installs=0.19.649 2118aabb5a925f1ec4669b4d3d31176a46d8f2a6 -->
    Loom-Trace-Id: 1057aaaf811f6dd2d64a3bb6d4b3ac49
    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
2026-10-03 chore: resync installed Loom surfaces
    <!-- loom:provenance v1 build=unknown 72f61d9aa0fe08f1ef59f1a97a314e474455801e clean prompts=none sweep=none story=none trace=577d2185973ec59f059fa15bf5b5e514 host=loom-worker-1 base=59b62b63796b5bcda8f7d51380d88b246391a3e7 run=loom-run/v1:script:loom-worker-1/fleet-resync:5728a930-137f-4d2f-a962-1cdd7a6a1d46 installs=0.19.652 235a64727b907d65529151af0a962b14f16462a0 -->
    Loom-Trace-Id: 577d2185973ec59f059fa15bf5b5e514
    Loom-Build: unknown 72f61d9aa0fe08f1ef59f1a97a314e474455801e clean
    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
2026-10-03 chore: resync installed Loom surfaces
    <!-- loom:provenance v1 build=unknown 72f61d9aa0fe08f1ef59f1a97a314e474455801e clean prompts=none sweep=none story=none trace=845aaa0eb340f80f12095e2e8b421ed1 host=robb-pro base=f607d25900304cfe5ea043dd45e7ea7345c6b8ab run=loom-run/v1:script:robb-pro/fleet-resync:344add4b-df8a-49e8-8563-2765673acc76 installs=0.19.652 235a64727b907d65529151af0a962b14f16462a0 -->
    Loom-Trace-Id: 845aaa0eb340f80f12095e2e8b421ed1
    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
2026-10-03 chore: resync installed Loom surfaces
    <!-- loom:provenance v1 build=unknown 21130104346fe9c464ce8a3fdf82c1d3e9667639 clean prompts=none sweep=none story=none trace=36308fff5a3c323c3d1bf6fffb6cd122 host=robb-studio base=cc0d0738b55a5973f960b610be540853d6d1f4dd run=loom-run/v1:timer:robb-studio/fleet-resync:89972fbd-0774-4402-bbb7-26c33a851735 installs=0.19.652 fb69233bd8f1dfc2bdee37d8b934f99274dc0193 -->
    Loom-Trace-Id: 36308fff5a3c323c3d1bf6fffb6cd122
    Loom-Build: unknown 21130104346fe9c464ce8a3fdf82c1d3e9667639 clean
    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
2026-10-04 chore: resync installed Loom surfaces
    <!-- loom:provenance v1 build=unknown 61870b40779d205c1555e801c6e1d95df083cdea clean prompts=none sweep=none story=none trace=fb9213e215442932d2af05f3b14977de host=robb-pro base=808a0d6c06961bc9789feb11f095195b2c3931a0 run=loom-run/v1:timer:robb-pro/fleet-resync:4c70cd1d-08cd-4add-8e2a-9a75160d163f installs=0.19.655 36c39e3c6f56e1979647ec235b4bd19c77db22f3 -->
    Loom-Trace-Id: fb9213e215442932d2af05f3b14977de
    Loom-Build: unknown 61870b40779d205c1555e801c6e1d95df083cdea clean
    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
2026-10-04 chore: resync installed Loom surfaces
    <!-- loom:provenance v1 build=unknown 61870b40779d205c1555e801c6e1d95df083cdea clean prompts=none sweep=none story=none trace=baa6c2cfcae1a320917c00ff2eb8b630 host=loom-worker-2 base=fb970c97d853a68fdc3c7c95ee6e019eff734d90 run=loom-run/v1:timer:loom-worker-2/fleet-resync:741a7f0f16df4fb1be4e657aeacd1244 installs=0.19.655 fc667a4faae1227f8a6837431f8a0c2d0aeaa7dd -->
    Loom-Trace-Id: baa6c2cfcae1a320917c00ff2eb8b630
    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
2026-10-04 chore: resync installed Loom surfaces
    <!-- loom:provenance v1 build=unknown b922acb2ac655cbccd71daa9e3f05a325a094ca5 clean prompts=none sweep=none story=none trace=833eeb34d4ca65c3f8c6f7824ddca3a3 host=robb-studio base=e21b31dad7bb6e89c7cf844b13ad088a4020b643 run=loom-run/v1:timer:robb-studio/fleet-resync:0d44f6dc-6a62-4d43-b49d-7cfdd7dbd823 installs=0.19.663 0a51e373e7fe1be156c5774b2c827d4b745368a3 -->
    Loom-Trace-Id: 833eeb34d4ca65c3f8c6f7824ddca3a3
    Loom-Build: unknown b922acb2ac655cbccd71daa9e3f05a325a094ca5 clean
    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
2026-10-04 chore: resync installed Loom surfaces
    <!-- loom:provenance v1 build=unknown 746ecb5f9d7e64ba1d2526f1e997530ad4f3dd43 clean prompts=none sweep=none story=none trace=f09501431241df2ec5688e334ba43dfe host=loom-worker-2 base=8d48cb9a5ff08ee95b350f92c1858424062bc908 run=loom-run/v1:timer:loom-worker-2/fleet-resync:70797dad61fb4e21806716d54f1ce910 installs=0.19.669 59a1f84e3742827a8033bb153ebbedc1759bee72 -->
    Loom-Trace-Id: f09501431241df2ec5688e334ba43dfe
    Loom-Build: unknown 746ecb5f9d7e64ba1d2526f1e997530ad4f3dd43 clean
    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
2026-10-04 chore: resync installed Loom surfaces
    <!-- loom:provenance v1 build=unknown 8080d0485cc1312129ee642b084944c56d1be074 clean prompts=none sweep=none story=none trace=ed180bcab6828041123ad54d8ddb4037 host=robb-pro base=d8eb9c06f3effc42b1d4cf58b0ecbd61583072c1 run=loom-run/v1:timer:robb-pro/fleet-resync:e97b2f08-4ad9-4b66-a166-5b19820e2d1f installs=0.19.669 59a1f84e3742827a8033bb153ebbedc1759bee72 -->
    Loom-Trace-Id: ed180bcab6828041123ad54d8ddb4037
    Loom-Build: unknown 8080d0485cc1312129ee642b084944c56d1be074 clean
    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
2026-10-04 chore: resync installed Loom surfaces
    <!-- loom:provenance v1 build=unknown 83cb6647167ffc000d2c2f479b4e816b68f863f4 clean prompts=none sweep=none story=none trace=ccabffa1e1ba495895b262086030816c host=robb-studio base=fd15bf8e69080b6d9a6e3542afe914a897052089 run=loom-run/v1:timer:robb-studio/fleet-resync:88a78f1f-d978-47b5-99c3-2aabde811d17 installs=0.19.676 cd4f30bd892ea2595d8218b08150633504b0dd14 -->
    Loom-Trace-Id: ccabffa1e1ba495895b262086030816c
    Loom-Build: unknown 83cb6647167ffc000d2c2f479b4e816b68f863f4 clean
    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
2026-10-04 chore: resync installed Loom surfaces
    <!-- loom:provenance v1 build=unknown 32174d0f7e80508fa66c1a11a2c0fb28c515607e clean prompts=none sweep=none story=none trace=436d7c19b10cd5807625a7ce7190a82f host=loom-worker-2 base=6dfc509a1db9feb65fbb97caffc61cf68083f716 run=loom-run/v1:timer:loom-worker-2/fleet-resync:19ae50771cc04d8db7b1403c1e66bbea installs=0.19.682 9eccfa110fa294fa32a62ffe8eff669cfcf1a3a6 -->
    Loom-Trace-Id: 436d7c19b10cd5807625a7ce7190a82f
    Loom-Build: unknown 32174d0f7e80508fa66c1a11a2c0fb28c515607e clean
    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
2026-10-04 chore: resync installed Loom surfaces
    <!-- loom:provenance v1 build=unknown 72290fa960e0773b2c50d74042e24914c7327637 clean prompts=none sweep=none story=none trace=f7b6952a649a174398a48b90b6ab4793 host=robb-pro base=7ce2ee4fa716d4a7b54a7ddc1986f7ee91780f26 run=loom-run/v1:timer:robb-pro/fleet-resync:72f32482-5cc4-4b38-ab9e-4d2ef0b64e94 installs=0.19.684 bdb8fb331eb51c7def4cdd2c38b611af06f25f6d -->
    Loom-Trace-Id: f7b6952a649a174398a48b90b6ab4793
    Loom-Build: unknown 72290fa960e0773b2c50d74042e24914c7327637 clean
    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
2026-10-04 chore: resync installed Loom surfaces
    <!-- loom:provenance v1 build=unknown 76cda58637be0e74c4cb5b4c8dbc2000e2a9c3d4 clean prompts=none sweep=none story=none trace=614cbada5ce873c2b34a511816309cfc host=robb-studio base=467465df2843d682721c5281d19b744a602144c9 run=loom-run/v1:timer:robb-studio/fleet-resync:7e559a3b-ffdd-409b-8dd2-ae906a273b0a installs=0.19.692 d4974b9f5ff7843a3cfc06378ea2a69bc120e0f4 -->
    Loom-Trace-Id: 614cbada5ce873c2b34a511816309cfc
    Loom-Build: unknown 76cda58637be0e74c4cb5b4c8dbc2000e2a9c3d4 clean
    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
2026-10-04 chore: resync installed Loom surfaces
    <!-- loom:provenance v1 build=unknown f84bac5c232c093f83c1adc2533d8c75b021cda2 clean prompts=none sweep=none story=none trace=e687830614e4bd1c551ab6cf6186f8f3 host=loom-worker-2 base=4116d0d846184d2ce5621c440c51bb53732461a1 run=loom-run/v1:timer:loom-worker-2/fleet-resync:2db2c4373ac24de1b7a364e69eaea1ca installs=0.19.695 b0d5b09f207fda439390ea1dd249ad10e7009dfc -->
    Loom-Trace-Id: e687830614e4bd1c551ab6cf6186f8f3
    Loom-Build: unknown f84bac5c232c093f83c1adc2533d8c75b021cda2 clean
    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
2026-10-04 chore: resync installed Loom surfaces
    <!-- loom:provenance v1 build=unknown ac5c275d1c616a9723e747f5a66de93dc80d3512 clean prompts=none sweep=none story=none trace=c777c3912bd31972e9aa3ccab712ae01 host=loom-worker-1 base=a9b7dc6440d94dfff10b975ca91a4297cd79beb2 run=loom-run/v1:script:loom-worker-1/fleet-resync:b51a1b33-4958-4408-be36-166e12e8360b installs=0.19.697 ada83a5c7ff66b56b0060ef0be368c9fe56eb3c6 -->
    Loom-Trace-Id: c777c3912bd31972e9aa3ccab712ae01
    Loom-Build: unknown ac5c275d1c616a9723e747f5a66de93dc80d3512 clean
    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
2026-10-04 chore: resync installed Loom surfaces
    <!-- loom:provenance v1 build=unknown a19f642f5c09599c4c64827d81d228eb031be73e clean prompts=none sweep=none story=none trace=34a80e22764eb5055e37faec0eaf65fb host=robb-pro base=091cfbd00a021a3d3ea89b230b666e65aba9680e run=loom-run/v1:script:robb-pro/fleet-resync:689be620-3ff2-4ff5-a2ce-f6825f6379e2 installs=0.19.698 aa619a1d07e36e8d90ac01fea63dc39285c93567 -->
    Loom-Trace-Id: 34a80e22764eb5055e37faec0eaf65fb
    Loom-Build: unknown a19f642f5c09599c4c64827d81d228eb031be73e clean
    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
2026-10-04 chore: resync installed Loom surfaces
    <!-- loom:provenance v1 build=unknown 693bdd794cb34afdefd7f0c4596824cd53078a61 clean prompts=none sweep=none story=none trace=7e7be58c80b40f1ac882b00139fb0ca0 host=robb-pro base=3ca4cf6ad083e9bad518b19ccd80f8e7f2ee4371 run=loom-run/v1:timer:robb-pro/fleet-resync:d64fbd6b-5d9b-491d-9e17-742b375bfba7 installs=0.19.698 8830969880b8257f33508ebf9a21cc3cb32b9ba7 -->
    Loom-Trace-Id: 7e7be58c80b40f1ac882b00139fb0ca0
    Loom-Build: unknown 693bdd794cb34afdefd7f0c4596824cd53078a61 clean
    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
2026-10-04 chore: resync installed Loom surfaces
    <!-- loom:provenance v1 build=unknown 693bdd794cb34afdefd7f0c4596824cd53078a61 clean prompts=none sweep=none story=none trace=aa18f1ec102a98d77ffc51c9be6ffbb3 host=robb-studio base=c88d1c8d430ec2611eb1ec4f262bd3079742ff76 run=loom-run/v1:script:robb-studio/fleet-resync:3cb89ca8-62c2-4a69-8434-c4aaa3b64eaf installs=0.19.698 a58f00e0681c50d6bfc5089d0af4b3715198319f -->
    Loom-Trace-Id: aa18f1ec102a98d77ffc51c9be6ffbb3
    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
2026-10-04 chore: resync installed Loom surfaces
    <!-- loom:provenance v1 build=unknown 7a41c2e69ef89d60ed3bd190b94838021bf18d0f clean prompts=none sweep=none story=none trace=d0f04f38b507d85402723643fcf47197 host=loom-worker-1 base=ab7783f1cc235bd543044294ed7c697186e87a8f run=loom-run/v1:script:loom-worker-1/fleet-resync:8fdc8c1c-f844-4c33-bc80-b424e5b4cf3d installs=0.19.703 89d5a428c652f957d7fad8a546589042d39911bc -->
    Loom-Trace-Id: d0f04f38b507d85402723643fcf47197
    Loom-Build: unknown 7a41c2e69ef89d60ed3bd190b94838021bf18d0f clean
    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
2026-10-05 chore: resync installed Loom surfaces
    <!-- loom:provenance v1 build=unknown ebb37db560de172930e261675a35bd52e429f650 clean prompts=none sweep=none story=none trace=a40e86a64366c7a1e36aea026901334f host=loom-worker-2 base=9bbd762c9df31bc71c11175b18d72cb468cf0038 run=loom-run/v1:script:loom-worker-2/fleet-resync:90b6cd74-6cc0-4f58-98ee-6ede0ac6f50c installs=0.19.703 f63c3c82e6bf202f2ca7b205b532f681c5ebb2c8 -->
    Loom-Trace-Id: a40e86a64366c7a1e36aea026901334f
    Loom-Build: unknown ebb37db560de172930e261675a35bd52e429f650 clean
    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
2026-10-05 chore: resync installed Loom surfaces
    <!-- loom:provenance v1 build=unknown 7a41c2e69ef89d60ed3bd190b94838021bf18d0f clean prompts=none sweep=none story=none trace=fc04851db12f586b5d58155325131b6e host=robb-studio base=454f6a97825882f0ff12748939e3964e4a4682fb run=loom-run/v1:timer:robb-studio/fleet-resync:a7d5da6f-a896-4d6f-8d00-aebf47f9b266 installs=0.19.703 2ad9a08fb93de4d7dfac9d2b501d12c684c9c2cc -->
    Loom-Trace-Id: fc04851db12f586b5d58155325131b6e
    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
2026-10-05 chore: resync installed Loom surfaces
    <!-- loom:provenance v1 build=unknown afe7e99e397c242cc319fa80702fb3b23e23f5a7 clean prompts=none sweep=none story=none trace=e46782e1dd9c94461b4cf934ce05296b host=loom-worker-2 base=885f85b55ef6e81545b530549337e64340db4949 run=loom-run/v1:timer:loom-worker-2/fleet-resync:caa89259b1fd414ebd2f07500621166d installs=0.19.703 972fe7321be6a9efe2653579379ea3bc40b899b2 -->
    Loom-Trace-Id: e46782e1dd9c94461b4cf934ce05296b
    Loom-Build: unknown afe7e99e397c242cc319fa80702fb3b23e23f5a7 clean
    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
2026-10-05 chore: resync installed Loom surfaces
    <!-- loom:provenance v1 build=unknown b44cb904ebb599db793066ccc631c846862abfbd clean prompts=none sweep=none story=none trace=9590fed7c1b1c9f549ccf3cba24292d7 host=robb-pro base=a2ffe755cf1b159da7e307afe0498b3acd49fb59 run=loom-run/v1:timer:robb-pro/fleet-resync:dbc6174e-403d-422d-98b6-73a4b6dbf44f installs=0.19.708 dc8faf1eae3143feda6301887c303b1ee45db7f4 -->
    Loom-Trace-Id: 9590fed7c1b1c9f549ccf3cba24292d7
    Loom-Build: unknown b44cb904ebb599db793066ccc631c846862abfbd clean
    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
2026-10-05 chore: resync installed Loom surfaces
    <!-- loom:provenance v1 build=unknown 4548905848fcb7cb875c1c0518f2fd88eb65818e clean prompts=none sweep=none story=none trace=aff5e139797705f6fa0811f102ecd103 host=loom-worker-1 base=6875c987e40eb2063e0513b437952f1f54540806 run=loom-run/v1:timer:loom-worker-1/fleet-resync:ba6a9e5686a64abaa842d71acaeae2ca installs=0.19.718 00d99344506bcf00e1aec7e910abe3d13df2d240 -->
    Loom-Trace-Id: aff5e139797705f6fa0811f102ecd103
    Loom-Build: unknown 4548905848fcb7cb875c1c0518f2fd88eb65818e clean
    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
2026-10-05 chore: resync installed Loom surfaces
    <!-- loom:provenance v1 build=unknown e7efbaa6e7b97a7d72da6032044c67525291f4d1 clean prompts=none sweep=none story=none trace=d74a33a6f35e329b3e795991e790ebfd host=robb-studio base=7e5a7975a67bbabaa58df3ab33f1540d3e385a42 run=loom-run/v1:timer:robb-studio/fleet-resync:304f49c8-5b3e-46a9-a557-945b9ae177f0 installs=0.19.718 00d99344506bcf00e1aec7e910abe3d13df2d240 -->
    Loom-Trace-Id: d74a33a6f35e329b3e795991e790ebfd
    Loom-Build: unknown e7efbaa6e7b97a7d72da6032044c67525291f4d1 clean
    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
2026-10-05 chore: resync installed Loom surfaces
    <!-- loom:provenance v1 build=unknown 347b71e65e709d9fd49aba75d3fb67877fc08818 clean prompts=none sweep=none story=none trace=f9653dd318724c98136e7cef63e551ed host=robb-pro base=f0fdd61038d057a3e21c06f01f1543305382ecfd run=loom-run/v1:timer:robb-pro/fleet-resync:cdc95970-9fb1-49fa-a0e6-037a3fab2099 installs=0.19.728 991dcebf6f6b2de6571f1d3400bec083498c6438 -->
    Loom-Trace-Id: f9653dd318724c98136e7cef63e551ed
    Loom-Build: unknown 347b71e65e709d9fd49aba75d3fb67877fc08818 clean
    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
2026-10-05 chore: resync installed Loom surfaces
    <!-- loom:provenance v1 build=unknown 5c0d18101f48fecb656f10fa37afa9b09bf41631 clean prompts=none sweep=none story=none trace=ddcf49552af364cbf6e884bd59584c1f host=loom-worker-1 base=ff5b755b613b956f6d3ee2408d697e677584f57e run=loom-run/v1:timer:loom-worker-1/fleet-resync:5eb526a05f244f1985770579e7620ff1 installs=0.19.731 7484b71fce5179a025950e71a82855afaf6fd730 -->
    Loom-Trace-Id: ddcf49552af364cbf6e884bd59584c1f
    Loom-Build: unknown 5c0d18101f48fecb656f10fa37afa9b09bf41631 clean
    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
2026-10-05 chore: resync installed Loom surfaces
    <!-- loom:provenance v1 build=unknown 0b160514b6658e3ab26a71c6525791da25b46fcf clean prompts=none sweep=none story=none trace=311c3eb2c0ab9550d3de38df5523f3d7 host=robb-studio base=0aaae19387d8bd4825305d33be3c97e4746c3af7 run=loom-run/v1:timer:robb-studio/fleet-resync:e6dec631-b42b-4cf2-b854-cc363cfde6e0 installs=0.19.731 d6146becf339a3d4e55e26e8807ac4571213a00b -->
    Loom-Trace-Id: 311c3eb2c0ab9550d3de38df5523f3d7
    Loom-Build: unknown 0b160514b6658e3ab26a71c6525791da25b46fcf clean
    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
2026-10-05 chore: resync installed Loom surfaces
    <!-- loom:provenance v1 build=unknown 5c0d18101f48fecb656f10fa37afa9b09bf41631 clean prompts=none sweep=none story=none trace=f1e8d4c6e73b8eec3e87a8da52e10f2d host=robb-pro base=d3fcdb507ff848a68a3dccfd6c21f5e277311088 run=loom-run/v1:timer:robb-pro/fleet-resync:5518fd33-81cb-479f-93f0-287ea4b08876 installs=0.19.733 4e67131ce3a1317d8cb8904ec342541cc2f45665 -->
    Loom-Trace-Id: f1e8d4c6e73b8eec3e87a8da52e10f2d
    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
2026-10-05 chore: resync installed Loom surfaces
    <!-- loom:provenance v1 build=unknown ca170d11544ef499cc9500a45bbad152edacfbd1 clean prompts=none sweep=none story=none trace=6dcfc713b6a851b40932158c2eeb70af host=loom-worker-3 base=16f3350735892545119516cff2a64abd4b98dc5d run=loom-run/v1:timer:loom-worker-3/fleet-resync:20ce0908ea5a468a9e055470104047ed installs=0.19.734 7ba6ea50c36dfdd2b5e2922dd22c65560980a5a2 -->
    Loom-Trace-Id: 6dcfc713b6a851b40932158c2eeb70af
    Loom-Build: unknown ca170d11544ef499cc9500a45bbad152edacfbd1 clean
    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
2026-10-05 chore: resync installed Loom surfaces
    <!-- loom:provenance v1 build=unknown 03f1c42302d15f8a83425a84a4e36ca484f3f625 clean prompts=none sweep=none story=none trace=f1bc879f8aa652d550764ffcd36e27d1 host=loom-worker-1 base=5a5914aa69b8eb364b736a06ddbe7ca8fdb50e80 run=loom-run/v1:timer:loom-worker-1/fleet-resync:f302a3cc8558413492093df510b02418 installs=0.19.734 967abe71d019ce6606018b4e57dee0223b84d96f -->
    Loom-Trace-Id: f1bc879f8aa652d550764ffcd36e27d1
    Loom-Build: unknown 03f1c42302d15f8a83425a84a4e36ca484f3f625 clean
    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
2026-10-05 chore: resync installed Loom surfaces
    <!-- loom:provenance v1 build=unknown ce7557ba58624d48fedbca2bc037dfa8ce3943e7 clean prompts=none sweep=none story=none trace=e1f2558834c47835cd9a53ec8c9a2ffa host=loom-worker-3 base=5d7fdeec25b786fa67311848d37c86d99613523d run=loom-run/v1:timer:loom-worker-3/fleet-resync:50f5f0046e2c4890961b3221bd360247 installs=0.19.734 ba9edb650872e5265eaca0c47f75e3cb828ecad2 -->
    Loom-Trace-Id: e1f2558834c47835cd9a53ec8c9a2ffa
    Loom-Build: unknown ce7557ba58624d48fedbca2bc037dfa8ce3943e7 clean
    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
2026-10-05 chore: resync installed Loom surfaces
    <!-- loom:provenance v1 build=unknown f92eaec38470a7b0732e065f4864faec9a1905d6 clean prompts=none sweep=none story=none trace=07aa020a8179d52651250562e9808b98 host=robb-studio base=2d6f3ba8ce3bfbe18243bb2a41213c1dacf04ff6 run=loom-run/v1:timer:robb-studio/fleet-resync:3b3ebdf2-b5f7-48ed-b7bb-5fb945094061 installs=0.19.734 78f3e99c44d0af6d4598adf7577bb6676baf3e8f -->
    Loom-Trace-Id: 07aa020a8179d52651250562e9808b98
    Loom-Build: unknown f92eaec38470a7b0732e065f4864faec9a1905d6 clean
    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
2026-10-06 chore: resync installed Loom surfaces
    <!-- loom:provenance v1 build=unknown ca170d11544ef499cc9500a45bbad152edacfbd1 clean prompts=none sweep=none story=none trace=fca9c14d74d6d634726f5823c51bc62a host=loom-worker-2 base=227d99ac118573e17e20d1cc566699f8207d45f7 run=loom-run/v1:timer:loom-worker-2/fleet-resync:23a23f0878c1494cb720941baddfea81 installs=0.19.741 3cede3920c6b567d5400789187a904970d46b0fb -->
    Loom-Trace-Id: fca9c14d74d6d634726f5823c51bc62a
    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
2026-10-06 chore: resync installed Loom surfaces
    <!-- loom:provenance v1 build=unknown e38a22941348fd8e83d1f4b06130d2a214adfb50 clean prompts=none sweep=none story=none trace=a7fe3a9a1fedfce89846c20f2e98ac31 host=robb-pro base=06ce9e9fbdca3fe62fe76c8022c2239a12018639 run=loom-run/v1:timer:robb-pro/fleet-resync:2d770a42-f0e7-4695-abfa-b912e75382e6 installs=0.19.744 8bc5bcce93c4d9721817387afe8b4b6d79f26054 -->
    Loom-Trace-Id: a7fe3a9a1fedfce89846c20f2e98ac31
    Loom-Build: unknown e38a22941348fd8e83d1f4b06130d2a214adfb50 clean
    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
2026-10-06 chore: resync installed Loom surfaces
    <!-- loom:provenance v1 build=unknown f66ea90ff1bdec51aa4c8dc3f4b2e8d26e3dfd2d clean prompts=none sweep=none story=none trace=66d96c3bb00b04fae967865ee02fc4de host=loom-worker-3 base=eed732aa70dfe190b01ac60884df209eb338763a run=loom-run/v1:timer:loom-worker-3/fleet-resync:eb2dceb410e848a19d58f96f678c995e installs=0.19.749 6135634b053dc30ef5aa8e6d733bfe79bb2ac734 -->
    Loom-Trace-Id: 66d96c3bb00b04fae967865ee02fc4de
    Loom-Build: unknown f66ea90ff1bdec51aa4c8dc3f4b2e8d26e3dfd2d clean
    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
2026-10-06 chore: resync installed Loom surfaces
    <!-- loom:provenance v1 build=unknown ade8a2c60cc8370d04d72f331141acb6fb32e121 clean prompts=none sweep=none story=none trace=6245fb88b5bdf9f7ccecb6b2168dc335 host=robb-studio base=53900ff58471fd98b0d653e35269ce3b8e31cfab run=loom-run/v1:timer:robb-studio/fleet-resync:b305aed2-1a25-4576-aca7-9b017ac4377e installs=0.19.755 8d97d322e1cb3723988504337089beca73d0511c -->
    Loom-Trace-Id: 6245fb88b5bdf9f7ccecb6b2168dc335
    Loom-Build: unknown ade8a2c60cc8370d04d72f331141acb6fb32e121 clean
    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
2026-10-06 chore: resync installed Loom surfaces
    <!-- loom:provenance v1 build=unknown 2489bb7d5203844b3fbe8efbe007f44aa074685d clean prompts=none sweep=none story=none trace=0b5c9263a55c09e6fbd870b2d9ff5d9b host=loom-worker-2 base=8ea746c1815eca9b5ea4f865c7972b427108e5eb run=loom-run/v1:timer:loom-worker-2/fleet-resync:d3f5a5beb1144f72ac8be575767b3e03 installs=0.19.760 3a509582b179d91c2d5b5a65a7ba4650c3c08985 -->
    Loom-Trace-Id: 0b5c9263a55c09e6fbd870b2d9ff5d9b
    Loom-Build: unknown 2489bb7d5203844b3fbe8efbe007f44aa074685d clean
    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
2026-10-06 chore: resync installed Loom surfaces
    <!-- loom:provenance v1 build=unknown 986d16b700174622774ff68af4ef323e8d0e23ba clean prompts=none sweep=none story=none trace=cb518f1f5785c258556383940a46c461 host=loom-worker-1 base=71afdb3b1980aaab9a18e7ba256efaa0767770af run=loom-run/v1:timer:loom-worker-1/fleet-resync:97df92c5eca846de85e979810663a94b installs=0.19.765 c6cec65c4f320f11153c72e840e49a5d6a6f1afc -->
    Loom-Trace-Id: cb518f1f5785c258556383940a46c461
    Loom-Build: unknown 986d16b700174622774ff68af4ef323e8d0e23ba clean
    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
2026-10-06 chore: resync installed Loom surfaces
    <!-- loom:provenance v1 build=unknown 85e52221261264d7f7643251de706f00c8db289f clean prompts=none sweep=none story=none trace=a2434124d73d8cca0ca77230fc85adf5 host=robb-pro base=bc2715f9b66c81a4c8138300041c54ff439f033a run=loom-run/v1:timer:robb-pro/fleet-resync:abffb067-59ed-4a6e-94b6-8cf3500c935c installs=0.19.768 c9f7ca975144d991bce40f492403b8292e8b7fae -->
    Loom-Trace-Id: a2434124d73d8cca0ca77230fc85adf5
    Loom-Build: unknown 85e52221261264d7f7643251de706f00c8db289f clean
    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
2026-10-06 chore: resync installed Loom surfaces
    <!-- loom:provenance v1 build=unknown 31b34ebfd7d4539094523eaa7b56a104bebe5fc0 clean prompts=none sweep=none story=none trace=16fac36f144dc183c71465eb36c89afc host=loom-worker-3 base=cb7edd48867a38f21e6deb7cf6862594944139c7 run=loom-run/v1:timer:loom-worker-3/fleet-resync:c763e24590314b918c8ee8df5d2de1db installs=0.19.769 af995a5725fdadf708127f006aa8f248b482d7d7 -->
    Loom-Trace-Id: 16fac36f144dc183c71465eb36c89afc
    Loom-Build: unknown 31b34ebfd7d4539094523eaa7b56a104bebe5fc0 clean
    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
2026-10-06 chore: resync installed Loom surfaces
    <!-- loom:provenance v1 build=unknown 7bed309263b3785eae46a9cbc53b3b24a52b10d2 clean prompts=none sweep=none story=none trace=843adbd5eac450c43d3a2c43da1bf729 host=robb-studio base=ca84a5436e6dd633dacf57e1cf6fdcd9f36f98d8 run=loom-run/v1:timer:robb-studio/fleet-resync:f83d5ba4-81f7-479a-9768-6af33d4cc825 installs=0.19.783 a9b459e0c2b1916ceb116db33053e7eb0df57e7b -->
    Loom-Trace-Id: 843adbd5eac450c43d3a2c43da1bf729
    Loom-Build: unknown 7bed309263b3785eae46a9cbc53b3b24a52b10d2 clean
    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
2026-10-06 chore: resync installed Loom surfaces
    <!-- loom:provenance v1 build=unknown 07bc40ba9ab0f7dfe7cd0990377b7ac07a52d220 clean prompts=none sweep=none story=none trace=563f186108419cf03cef002a62c3b201 host=loom-worker-2 base=75746971055c88aa45b6dda4745c829ea04b8184 run=loom-run/v1:timer:loom-worker-2/fleet-resync:944beccd157a4197b81feafdd19f443e installs=0.19.785 2f0a9dbb4f06053f747b8a5615a3519f8e30b527 -->
    Loom-Trace-Id: 563f186108419cf03cef002a62c3b201
    Loom-Build: unknown 07bc40ba9ab0f7dfe7cd0990377b7ac07a52d220 clean
    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
2026-10-06 chore: resync installed Loom surfaces
    <!-- loom:provenance v1 build=unknown 31b34ebfd7d4539094523eaa7b56a104bebe5fc0 clean prompts=none sweep=none story=none trace=ea6600df41a4b420b6d8e967f839ccfd host=loom-worker-3 base=8653d6e7ad7ed2659acefd239e124536b9a43ae0 run=loom-run/v1:timer:loom-worker-3/fleet-resync:c80415b48fd5404bbd599c4f6cc8a448 installs=0.19.793 7ceff96944c39d33e3c2f1141ca650c2c4c05679 -->
    Loom-Trace-Id: ea6600df41a4b420b6d8e967f839ccfd
    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
2026-10-06 chore: resync installed Loom surfaces
    <!-- loom:provenance v1 build=unknown 596a53e525683919daae1b43e6babe9bf847a02f clean prompts=none sweep=none story=none trace=b9c0cb42a5a72ecc21726229c957ef1f host=loom-worker-2 base=c1aec7830ee0a04093729c072915ace084fd80b9 run=loom-run/v1:timer:loom-worker-2/fleet-resync:21d578f5cc0b4b7ba5f10759f5f30ae8 installs=0.19.801 524bdb33cb26c8355454d7550413c89e72c06fae -->
    Loom-Trace-Id: b9c0cb42a5a72ecc21726229c957ef1f
    Loom-Build: unknown 596a53e525683919daae1b43e6babe9bf847a02f clean
    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
2026-10-06 chore: resync installed Loom surfaces
    <!-- loom:provenance v1 build=unknown 40b591a33adb895d4f46977105f9b264d8a2599b clean prompts=none sweep=none story=none trace=e41c725fe0c176312eb412bc69fe5b01 host=robb-studio base=f778c272a6998e13cac95d99166201ef9a107814 run=loom-run/v1:timer:robb-studio/fleet-resync:37d704dd-4dfd-4341-adb4-6551637ad147 installs=0.19.802 72ce1f7385747dd773d1644408ec22072b8a5d20 -->
    Loom-Trace-Id: e41c725fe0c176312eb412bc69fe5b01
    Loom-Build: unknown 40b591a33adb895d4f46977105f9b264d8a2599b clean
    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
2026-10-06 chore: resync installed Loom surfaces
    <!-- loom:provenance v1 build=unknown 31b34ebfd7d4539094523eaa7b56a104bebe5fc0 clean prompts=none sweep=none story=none trace=5ad0480c4b21b80f9c852c448319e7a1 host=loom-worker-3 base=171f0e1ed5c935faaf258ba96e9cf5c7e3d655e3 run=loom-run/v1:timer:loom-worker-3/fleet-resync:48e836f11f9547ddb96de5aa0d072a05 installs=0.19.810 933f828e779602e492e4e157812988a4b8128111 -->
    Loom-Trace-Id: 5ad0480c4b21b80f9c852c448319e7a1
    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
2026-10-07 chore: resync installed Loom surfaces
    <!-- loom:provenance v1 build=unknown f71cf25de9e75bae6060da4a599df8fbabe75890 clean prompts=none sweep=none story=none trace=64943e35511da4833bbd385cf288be8a host=loom-worker-2 base=a143056271fbf6d21625126660d341f46c18252e run=loom-run/v1:timer:loom-worker-2/fleet-resync:d69eb1b87d4849ae810a145b1b667d2f installs=0.19.822 1c6969ea8726c800a353c236d9f23456a5706f1a -->
    Loom-Trace-Id: 64943e35511da4833bbd385cf288be8a
    Loom-Build: unknown f71cf25de9e75bae6060da4a599df8fbabe75890 clean
    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
2026-10-07 chore: resync installed Loom surfaces
    <!-- loom:provenance v1 build=unknown 31b34ebfd7d4539094523eaa7b56a104bebe5fc0 clean prompts=none sweep=none story=none trace=cb192cb8f72cf6f2711f73f7ee12bebc host=loom-worker-3 base=11d77c26b5bed868aee440ce607055b779127461 run=loom-run/v1:timer:loom-worker-3/fleet-resync:c1e385c3607e43ad8bed9c7d29811c66 installs=0.19.830 a966f7b89b714704fa1225b96e2dbee50480a4c6 -->
    Loom-Trace-Id: cb192cb8f72cf6f2711f73f7ee12bebc
    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
2026-10-07 chore: resync installed Loom surfaces
    <!-- loom:provenance v1 build=unknown 8abdd34fddc879aff407380278baa713eca6b758 clean prompts=none sweep=none story=none trace=ea945665dad5ccb3880de51c4448e8b9 host=robb-pro base=0fe1aaf6d2cdebde6b9a171031b6e883b47803be run=loom-run/v1:timer:robb-pro/fleet-resync:1466e397-b80c-46ea-a42c-26a7fbd4e00e installs=0.19.831 61814c9c1912925cdff7418842ff3ea17cd56fe4 -->
    Loom-Trace-Id: ea945665dad5ccb3880de51c4448e8b9
    Loom-Build: unknown 8abdd34fddc879aff407380278baa713eca6b758 clean
    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
2026-10-07 chore: resync installed Loom surfaces
    <!-- loom:provenance v1 build=unknown 628be5bb140bcff803d159201bd61e1b868901b0 clean prompts=none sweep=none story=none trace=093df1dc315c5e78dcccfca9d699d5f5 host=loom-worker-2 base=cdb14a4e7d38fa2b3a787fd1ff79c75e270eb4ec run=loom-run/v1:timer:loom-worker-2/fleet-resync:0b0ea5e184c0429a9c431fcca6c791ad installs=0.19.832 1a0fc15974bf0575a9155fb8276f7529fc813542 -->
    Loom-Trace-Id: 093df1dc315c5e78dcccfca9d699d5f5
    Loom-Build: unknown 628be5bb140bcff803d159201bd61e1b868901b0 clean
    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
2026-10-07 chore: resync installed Loom surfaces
    <!-- loom:provenance v1 build=unknown 069e3b45d86c08f0d60c8fc2b0096de441e99bdc clean prompts=none sweep=none story=none trace=b1ba9d6b2b581e47827d9c099f717b04 host=loom-worker-1 base=b143ab7cd43b04d23fabfbbc96e24a19404411d2 run=loom-run/v1:timer:loom-worker-1/fleet-resync:aada8278bd4843bcaecce69fdf91251e installs=0.19.838 e70aa17f8dead31bda49cf044c3fc28119df6e90 -->
    Loom-Trace-Id: b1ba9d6b2b581e47827d9c099f717b04
    Loom-Build: unknown 069e3b45d86c08f0d60c8fc2b0096de441e99bdc clean
    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
2026-10-07 chore: resync installed Loom surfaces
    <!-- loom:provenance v1 build=unknown 31b34ebfd7d4539094523eaa7b56a104bebe5fc0 clean prompts=none sweep=none story=none trace=ef030e94bce76f728497f5927960865f host=loom-worker-3 base=c174235c8afabeea0f7bfcac7957047056bf54b5 run=loom-run/v1:timer:loom-worker-3/fleet-resync:28ba4284bfa446c888b501714eda0509 installs=0.19.840 59b533a2a1ed5e186fbf8446b5acbe42d7231854 -->
    Loom-Trace-Id: ef030e94bce76f728497f5927960865f
    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
2026-10-07 chore: resync installed Loom surfaces
    <!-- loom:provenance v1 build=unknown bc59c70c3412a87b31a0dbe65cd6abf968744328 clean prompts=none sweep=none story=none trace=766033e4e881801f24971d664c490ea3 host=robb-studio base=fe4da1a0183b74c2966fbc4583d076701e4b80da run=loom-run/v1:timer:robb-studio/fleet-resync:6b3b079a-890e-4a79-9c3a-0b4bb33ff7c4 installs=0.19.840 59b533a2a1ed5e186fbf8446b5acbe42d7231854 -->
    Loom-Trace-Id: 766033e4e881801f24971d664c490ea3
    Loom-Build: unknown bc59c70c3412a87b31a0dbe65cd6abf968744328 clean
    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
2026-10-07 chore: resync installed Loom surfaces
    <!-- loom:provenance v1 build=unknown a068938e7a6c13759bcb3943e408273a3d352257 clean prompts=none sweep=none story=none trace=76bec863c8f6aff2d49b3aa2be128619 host=robb-pro base=0c520f7e3e3a4a3fad236bb348c8a78e6665d99e run=loom-run/v1:timer:robb-pro/fleet-resync:d9927fc6-ee80-4b6a-ba2b-f13576bd5f9b installs=0.19.846 837b14d7440b89ae8a2cec6d045483ac33659af5 -->
    Loom-Trace-Id: 76bec863c8f6aff2d49b3aa2be128619
    Loom-Build: unknown a068938e7a6c13759bcb3943e408273a3d352257 clean
    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
2026-10-07 chore: resync installed Loom surfaces
    <!-- loom:provenance v1 build=unknown 628be5bb140bcff803d159201bd61e1b868901b0 clean prompts=none sweep=none story=none trace=5a6f676b4652a1a750bbce1386c68d06 host=loom-worker-2 base=df63eb011afe16caab8ef3ddb34c421bb118dac0 run=loom-run/v1:timer:loom-worker-2/fleet-resync:bd416e653be04ef4b13353430625e379 installs=0.19.850 3bb4bfc90603b6ad65cabca9b3eb42a59f1a9d3a -->
    Loom-Trace-Id: 5a6f676b4652a1a750bbce1386c68d06
    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
2026-10-07 chore: resync installed Loom surfaces
    <!-- loom:provenance v1 build=unknown 40215645df8a13508180b248b44244dc488bb078 clean prompts=none sweep=none story=none trace=29fde30615e6e47f39b41aa314c2c883 host=loom-worker-1 base=1ed24d4ef84c9797cc142fc7ce5d01ac54a3abf9 run=loom-run/v1:timer:loom-worker-1/fleet-resync:d1fbedfcc7824ae59233c0ea94dc4650 installs=0.19.853 2889d5ed585b4da0935543cb916381cc03b19746 -->
    Loom-Trace-Id: 29fde30615e6e47f39b41aa314c2c883
    Loom-Build: unknown 40215645df8a13508180b248b44244dc488bb078 clean
    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
2026-10-07 chore: resync installed Loom surfaces
    <!-- loom:provenance v1 build=unknown 31b34ebfd7d4539094523eaa7b56a104bebe5fc0 clean prompts=none sweep=none story=none trace=cdf49c615da3f5ce46e9fcda1a24f787 host=loom-worker-3 base=bc3e2ee8c6fca2d75bdc0a2933c97725a1edcf46 run=loom-run/v1:timer:loom-worker-3/fleet-resync:cab31e05b8a24df09bc88f53ee3fb501 installs=0.19.857 7a0b529e6f57a79713f6924bf58d8392ff404259 -->
    Loom-Trace-Id: cdf49c615da3f5ce46e9fcda1a24f787
    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
2026-10-07 chore: resync installed Loom surfaces
    <!-- loom:provenance v1 build=unknown 4b44e7c5db0de1d2b5927de7de229120d546aad3 clean prompts=none sweep=none story=none trace=dfa656ee3483a044378501f49d36f812 host=robb-studio base=17e3654e6e889d9dd4d37828335e96835cb761ce run=loom-run/v1:timer:robb-studio/fleet-resync:d80d6bc0-eb68-4a07-8226-2d947d328b3a installs=0.19.859 0aefebd79aba8ab33470f1af4b96847fc794bd0d -->
    Loom-Trace-Id: dfa656ee3483a044378501f49d36f812
    Loom-Build: unknown 4b44e7c5db0de1d2b5927de7de229120d546aad3 clean
    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
2026-10-07 chore: resync installed Loom surfaces
    <!-- loom:provenance v1 build=unknown b591c8cf436f0d4aa5870a9bc7cd5f7194e0e778 dirty prompts=none sweep=none story=none trace=6eca4b0c47205457aae7a3d721c17f17 host=robb-pro base=ec1a098201297275560e6f7cbf97f81afdb08258 run=loom-run/v1:timer:robb-pro/fleet-resync:64af20b3-58cb-47f2-b770-117197cb41e9 installs=0.19.864 128a7eba2bb5f7bcf8891ba284b14cb7ebf8dd3d -->
    Loom-Trace-Id: 6eca4b0c47205457aae7a3d721c17f17
    Loom-Build: unknown b591c8cf436f0d4aa5870a9bc7cd5f7194e0e778 dirty
    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
2026-10-07 chore: resync installed Loom surfaces
    <!-- loom:provenance v1 build=unknown b551219fd5b8347113c0cbc79ea416e81c39fa9d clean prompts=none sweep=none story=none trace=5ac7c8c62dad54841e21dd94f0920de3 host=loom-worker-2 base=207835416721a825bc044c9a46df20db67c1501c run=loom-run/v1:timer:loom-worker-2/fleet-resync:d10fb10789e94930ab1af368c15a8f8b installs=0.19.864 128a7eba2bb5f7bcf8891ba284b14cb7ebf8dd3d -->
    Loom-Trace-Id: 5ac7c8c62dad54841e21dd94f0920de3
    Loom-Build: unknown b551219fd5b8347113c0cbc79ea416e81c39fa9d clean
    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
2026-10-07 chore: resync installed Loom surfaces
    <!-- loom:provenance v1 build=unknown 90fbd167e4e376894396e651676cf58fc9aa223a clean prompts=none sweep=none story=none trace=196876656e912171b28029ceca9f772d host=loom-worker-1 base=075364afd57a91b5e08f482791460cd808071ac3 run=loom-run/v1:timer:loom-worker-1/fleet-resync:7b46720ff3a84a8184f2f2b3bc039260 installs=0.19.868 ee904e1c151bc9cf15b0eb55dfe9d57ad6136cff -->
    Loom-Trace-Id: 196876656e912171b28029ceca9f772d
    Loom-Build: unknown 90fbd167e4e376894396e651676cf58fc9aa223a clean
    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
2026-10-08 chore: resync installed Loom surfaces
    <!-- loom:provenance v1 build=unknown 5a3df331a0612dee585ef905015af01d08e3467f clean prompts=none sweep=none story=none trace=5690fa95febe608e500a46dde8a6ee92 host=loom-worker-2 base=a2125eed5599ad1f3966aad64387dab7ef2213aa run=loom-run/v1:timer:loom-worker-2/fleet-resync:5c9c35d59b704bff9d8bf096ee7ba7be installs=0.19.876 b16d54e63fbbec4d7f15f13c1f43a5e5b38145ce -->
    Loom-Trace-Id: 5690fa95febe608e500a46dde8a6ee92
    Loom-Build: unknown 5a3df331a0612dee585ef905015af01d08e3467f clean
    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
2026-10-08 chore: resync installed Loom surfaces
    <!-- loom:provenance v1 build=unknown 134eb3ff06c1a86f49a911c6c17464f55e719736 clean prompts=none sweep=none story=none trace=c7df110d490314040dcd1347b2481843 host=loom-worker-1 base=882d241493eb049e61b5a01e9cec1a8aa935f8a2 run=loom-run/v1:timer:loom-worker-1/fleet-resync:53d0cec2cd61484eb9a0f8fb1f24ac5e installs=0.19.879 c15619905bdd8a24506c3853f45490d26e8f1cad -->
    Loom-Trace-Id: c7df110d490314040dcd1347b2481843
    Loom-Build: unknown 134eb3ff06c1a86f49a911c6c17464f55e719736 clean
    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
2026-10-08 chore: resync installed Loom surfaces
    <!-- loom:provenance v1 build=unknown 8f86de23319d8f6cf049557dcc9cf2e321211d9d clean prompts=none sweep=none story=none trace=17de45f778fbfd714af8afad02c96375 host=loom-worker-3 base=b8c95ccb53797599c9b362915f44b2114d6d5ce7 run=loom-run/v1:timer:loom-worker-3/fleet-resync:9e3e5d4a08824de3b7bc02940be2a0da installs=0.19.882 c9f85af3d967986cdd7a3f27e088a16f88712b05 -->
    Loom-Trace-Id: 17de45f778fbfd714af8afad02c96375
    Loom-Build: unknown 8f86de23319d8f6cf049557dcc9cf2e321211d9d clean
    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
2026-10-08 chore: resync installed Loom surfaces
    <!-- loom:provenance v1 build=unknown 4a5fb2b6276e17ff26ee1382acfe2ea7360ebea5 clean prompts=none sweep=none story=none trace=67857e1b7189785825a2dfc70921cf85 host=loom-worker-2 base=a9c36869ca4e4c9c13083f7ccc7965f5caf834f6 run=loom-run/v1:timer:loom-worker-2/fleet-resync:dd6a5f3dceff4d8d8602a07a1dc89c95 installs=0.19.892 ce93e8a919d79a6f027bab268846a52084f9d94e -->
    Loom-Trace-Id: 67857e1b7189785825a2dfc70921cf85
    Loom-Build: unknown 4a5fb2b6276e17ff26ee1382acfe2ea7360ebea5 clean
    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
2026-10-08 chore: resync installed Loom surfaces
    <!-- loom:provenance v1 build=unknown b591c8cf436f0d4aa5870a9bc7cd5f7194e0e778 dirty prompts=none sweep=none story=none trace=28e7ca5fdb768489aa38bf002407d5a5 host=robb-pro base=9e992f50b76f55662b323f192067beece2111c6c run=loom-run/v1:timer:robb-pro/fleet-resync:eb5f838e-a774-4e20-8102-c37ee3ff31ca installs=0.19.895 9b30d293bcba1e79d49cabfc1c5bb5b6f4c0dc77 -->
    Loom-Trace-Id: 28e7ca5fdb768489aa38bf002407d5a5
    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
2026-10-08 chore: resync installed Loom surfaces
    <!-- loom:provenance v1 build=unknown 5684fc8c8ac418d95ad66a002d001eaea1283c9a clean prompts=none sweep=none story=none trace=c864acd3b9a5dbb419fddd8bd2a6283b host=loom-worker-3 base=05f7ebaaeacc2bf5bd3847ca76e3e1e04497b8f0 run=loom-run/v1:timer:loom-worker-3/fleet-resync:4771e7c630c34445b7f28539669d76e3 installs=0.19.898 3d55b9a1669c132d130d98f10a292c1325322c30 -->
    Loom-Trace-Id: c864acd3b9a5dbb419fddd8bd2a6283b
    Loom-Build: unknown 5684fc8c8ac418d95ad66a002d001eaea1283c9a clean
    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
2026-10-08 spec: DR-0007 row-by-row ratification record for the target table (#54)
    Proposes one disposition per row; no row is ratified until the ee and
    market non-author keys post. 1 proposed, 9 Open, 0 Revised; no target changed.
    Loom-Story: 2AMLogic/sg13g2-ldo#54
    Loom-Trace-Id: 82de80e2a6937858ede4759a7710dd7e
    Loom-Build: 0.19.868 ee904e1c151bc9cf15b0eb55dfe9d57ad6136cff clean
2026-10-08 chore: resync installed Loom surfaces
    <!-- loom:provenance v1 build=unknown 04a1189116c7320def7d9ce357d2d9268405ae92 clean prompts=none sweep=none story=none trace=8e55b27fc60ffb045554bd413ad8f3c8 host=robb-pro base=b2c7333e690483d0044864dc347c7d9d457c4d83 run=loom-run/v1:timer:robb-pro/fleet-resync:83b69005-7c5b-44b3-96f8-33f07bf82f4b installs=0.19.917 d3c1ea3a4c81e01ce5487dc3e4bbdd86534e677e -->
    Loom-Trace-Id: 8e55b27fc60ffb045554bd413ad8f3c8
    Loom-Build: unknown 04a1189116c7320def7d9ce357d2d9268405ae92 clean
    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
2026-10-08 spec: DR-0007 row 4 (dropout) to ratified, for the two-key review (#54)
    DR-0007 merged as documentation with every disposition still a proposal,
    and the issue was reopened because neither review key had posted. A merged
    record has no open pull request for a key to be applied to, so the keys
    need a carrying PR. This commit is that PR's content: it writes the state
    the record itself proposed, and nothing beyond it.
    Row 4 (dropout @ 50 mA) is the only row the record proposed as "Ratified as
    written", so it is the only row that moves. The nine Open rows keep their
    dispositions and their named missing evidence; no target value changes and
    no evidence is added. The Status text as first merged is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
2026-10-08 sim: aggregated per-spec-row characterization report + generic envelope for T1 item 8 (#58)
    Offline stdlib generator over an explicit, hash-pinned record selection;
    report/markdown/envelope committed, CI drift gate, item-8 citation pinned
    in the signoff manifest and T1 report regenerated with the pinned build.
    Loom-Story: 2AMLogic/sg13g2-ldo#58
    Loom-Trace-Id: ceadf56b50c798d0d9e6fe65fa70d4c0
    Loom-Build: 0.19.895 9b30d293bcba1e79d49cabfc1c5bb5b6f4c0dc77 clean
2026-10-08 sim: any generator failure writes a status:fail envelope (#58)
    Address Judge review on PR #73:
    - main() now treats any exception from build()/render_bytes() (not only
    GenError) as a failure: a status:fail envelope replaces any committed
    passing envelope, the traceback is printed, and the exit is nonzero.
    - Negative controls: selection.json missing circuit_record.design_freshness_pins
    (KeyError path) and selection.json that is not valid JSON both leave a
    status:fail envelope and fail --check.
    - Comment the completeness checks hard-coded True (enforced earlier by
    GenError raises).
    - Drop the envelope's duplicate top-level report.sha256; the report hash
    lives only in provenance.inpu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
2026-10-08 chore: resync installed Loom surfaces
    <!-- loom:provenance v1 build=unknown d2a55ce217b3ad1793611a2c54946676bb55b512 clean prompts=none sweep=none story=none trace=459637e4e8503593bdf58360865a7524 host=robb-pro base=c2caff8041c41574b0cf00b63f60451a817ae1e4 run=loom-run/v1:timer:robb-pro/fleet-resync:95b3cf92-9cd9-4c36-8bbd-bdcace7c3874 installs=0.19.935 d347079cd0bad2db2c11ee4f0b760f04b2601d21 -->
    Loom-Trace-Id: 459637e4e8503593bdf58360865a7524
    Loom-Build: unknown d2a55ce217b3ad1793611a2c54946676bb55b512 clean
    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
2026-10-08 sim: T1 item 5 coverage inventory and informational DC summaries from committed raw grid (#55)
    Part of #55. Extracts the DC parser from run_sweep.sh, derives full-load Iq,
    loaded line regulation and load regulation at 2.97/3.30/3.63 V with validity
    flags, labels run_sweep.sh comparisons by DR-0007 status, and refreshes the
    stale item-8 pin. No klt sim envelope (klayout-tools#2727); item 5 stays unmet.
    Loom-Story: 2AMLogic/sg13g2-ldo#55
    Loom-Trace-Id: fd56f773ebee0d943c2f2a83da4267fc
    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
    [dc-informational-summary.csv]
2026-10-08 signoff: regenerate item 8 after the pvt-sweep README edit (#55)
    The PR's edit to sim/ldo-cmos5l-pvt-sweep/README.md (a pinned
    superseded_evidence_statement source) left the characterization artifact
    stale, so generate.py --check failed. Regenerated in dependency order after
    the last pinned-file edit: generate.py (one pin line each in report.json,
    report.md, envelope.json), the item-8 manifest pin (sha256:3db06e10...), then
    the T1 report with the pinned build 0.5.0+gb15edf5e3a2e (exit 3, item 8 met,
    3/11). signoff/README.md's "Item 8 pin refresh" now lists both pin changes.
    Loom-Trace-Id: fd56f773ebee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
2026-10-09 sim: SG13CMOS5L row-2 output-accuracy Monte Carlo campaign with klt yield evidence (#56)
    Bounded row-2 campaign against the proposed (Open, unratified) 1.764-1.836 V
    window: PDK per-instance MOS + rhigh mismatch at five process/temperature
    corners, N=400 each, fixed seeds, all simulated as klt sim requests on the
    batch fleet. Includes a deterministic VREF negative control (detected; own
    yield fails), a mismatch-off sampler control (zero spread, reproduces the
    committed corner value), MOS-vs-resistor attribution, and an independent
    reproduction job (bit-identical). Per-population klt yield reports, raw
    reports, per-draw CSV and retained logs are committed under
    sim/ldo-cmos5l-monte-carlo/reco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
    [20261009-003009-3ee8306.csv]
2026-10-09 ci: offline record check for the row-2 Monte Carlo evidence (#56)
    run_campaign.sh check re-derives the per-population sample-set documents,
    crosscheck.json and the per-draw CSV from the committed raw klt sim reports
    (stdlib only, no PDK/simulator/klt) and asserts the campaign invariants; a
    new monte-carlo-record CI job runs it plus the unit tests. Also orders the
    signoff README's item 6/7 bullets after the rebase onto main.
    Loom-Story: 2AMLogic/sg13g2-ldo#56
    Loom-Trace-Id: 9c7b3637146e0678ffad7b735b71b791
    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
2026-10-09 chore: regenerate characterization report and signoff pins after README update
    README.md is a pinned source of the aggregate characterization report;
    its 'T1 items met' sentence changed, so regenerate generate.py output,
    then the manifest item-8 pin, then the klt signoff tier report (pinned build).
2026-10-09 chore: resync installed Loom surfaces
    <!-- loom:provenance v1 build=unknown 05dba463c5b293d38f0ca071725983862498b3f3 clean prompts=none sweep=none story=none trace=14298316053024bcf5120bff695771ab host=robb-pro base=f95860173a6d731b7525a4e0094c3f1cf0300ef2 run=loom-run/v1:timer:robb-pro/fleet-resync:2f384483-6d77-4ba2-9888-aa1e4b5be36c installs=0.19.953 b93d7a955d63411cb4c94b986fd5138d27dedb0f -->
    Loom-Trace-Id: 14298316053024bcf5120bff695771ab
    Loom-Build: unknown 05dba463c5b293d38f0ca071725983862498b3f3 clean
    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
2026-10-09 chore: resync installed Loom surfaces
    <!-- loom:provenance v1 build=unknown 7f06b288b150f2fe0a4b24c331a9b3ec093d709d clean prompts=none sweep=none story=none trace=a90c217ff3a3bd9e3a30282b8cadc24d host=robb-pro base=b0082c1441c00cdcff162e9f4794c4a5eaf77aef run=loom-run/v1:timer:robb-pro/fleet-resync:6e5ec9f3-d6ef-4953-80f7-c93035e2d359 installs=0.19.966 9bed656320e53ba6c64305daa60613431a7ed02d -->
    Loom-Trace-Id: a90c217ff3a3bd9e3a30282b8cadc24d
    Loom-Build: unknown 7f06b288b150f2fe0a4b24c331a9b3ec093d709d clean
    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
2026-10-09 feat(layout): declare checked well/substrate ties in the klt erc supply spec (T1 item 11, #59)
    Tap boxes derive from the generator's draw_tap_bar calls (erc-tap-boxes.json,
    verified by layout/erc_ties.py in run_flow.sh stage 8, with a mutation
    control). Signoff grading pin bumped to klt 0.7.0+gb82427b30c96 (needs
    well_layer null / well_boxes / well_requires_boxes); T1 report regenerated,
    item 11 met (4/11).
    Loom-Story: 2AMLogic/sg13g2-ldo#59
    Loom-Trace-Id: 3d6fea4d2b732efa2c8b171429f2924b
    Loom-Build: 0.19.972 113c7f31d7d16f75d30c470023e0b65b29b1fe94 clean
2026-10-09 chore: resync installed Loom surfaces
    <!-- loom:provenance v1 build=unknown 30c7a7ee2f74a6a2b5bb0f19fd9f049ec8ae8b5c clean prompts=none sweep=none story=none trace=7bc5ba399ff199d049d83d711920a157 host=robb-pro base=022dd46db6f6eb6976aad383c3bcfb06dc9acba6 run=loom-run/v1:timer:robb-pro/fleet-resync:8e237160-c4d0-4ce3-85ac-c96aff5cf221 installs=0.19.982 2bc4cba624b9053535663441e6f0daf08a7acf2e -->
    Loom-Trace-Id: 7bc5ba399ff199d049d83d711920a157
    Loom-Build: unknown 30c7a7ee2f74a6a2b5bb0f19fd9f049ec8ae8b5c clean
    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
2026-10-09 feat(signoff): artifact-anchored generic evidence for T1 items 1, 2, 9, 10 (#60)
    Four generic envelopes bound to deterministic sha256 inventories, a PDK-free
    inventory/check helper with negative controls gated in CI, grading pin bumped
    to klayout-tools 3a75c3ae705b (#2843), item-8 pin refreshed, report regraded
    (8/11 met; items 1,2,9,10 flipped, others unchanged).
    Loom-Story: 2AMLogic/sg13g2-ldo#60
    Loom-Trace-Id: 39cd5c23ab65542a04b77d29597af624
    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
    [evidence_inventory.py, test_evidence_inventory.py]
2026-10-09 fix(signoff): keep klt grading pin at b82427b (already contains #2843) (#60)
    The previous revision moved KLAYOUT_TOOLS_SIGNOFF_REF from b82427b30c96
    (0.7.0) back to 3a75c3ae705b (0.6.0), a 33-commit downgrade: 3a75c3a is
    an ancestor of b82427b, so the existing pin already carries
    klayout-tools#2843's artifact-anchored generic evidence.
    - Restore the pin to b82427b30c9604b53b2dce64850409841cc38bde and
    replace the inaccurate "Bumped from b82427b" CI comment with a note
    that no bump was needed; fix the stale 4/11 job comment to 8/11.
    - signoff/README.md: install snippet back on b82427b; the "Pin bump
    (#60)" paragraph now states the existing pin already includes #2843.
    - Re-ran evidence_i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
2026-10-10 chore: resync installed Loom surfaces
    <!-- loom:provenance v1 build=unknown a7d2b01d8eb7d09e597a4638e5cb3cdd8bab9156 clean prompts=none sweep=none story=none trace=35c1337ee84607e87ba2038523d63198 host=robb-pro base=95ad8e5d97d88f0fc923db4008527cf4053a3ce1 run=loom-run/v1:timer:robb-pro/fleet-resync:6bf32a81-6c4a-48c5-a51e-1ad65c6bedfd installs=0.19.1001 1c1131220b2f5950fe54b7cd02ebd3f1aae488dd -->
    Loom-Trace-Id: 35c1337ee84607e87ba2038523d63198
    Loom-Build: unknown a7d2b01d8eb7d09e597a4638e5cb3cdd8bab9156 clean
    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
2026-10-10 feat(sg13cmos5l): add active-high EN enable interface and migrate benches (#67)
    Appends EN to the SG13CMOS5L core (VIN VOUT VSS VREF IBIAS EN): Men holds
    the pass gate at VIN and Mbdis cuts the amplifier bias node when EN is low.
    Updates the exporter port invariant (SG13G2 four-port invariant untouched),
    the regenerated core netlist, the three pvt-sweep templates (EN tied to VIN;
    flattened loop-gain copy carries both enable devices) and
    assert_loopgain_topology_sync, which now also compares the template copy and
    ships --check-topology-guard negative controls.
    DR-0008 records topology, valid levels, bias handling, stress and the
    off-state measurement conditions. sim/ldo-cmos5l-enable/ holds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
    [ldo_core_cmos5l.sch, summary.csv]
2026-10-10 feat(sim): add --batch fleet backend to the cmos5l PVT sweep (#67)
    run_sweep.sh --batch queues the same per-point decks and runs them on the
    EDA batch fleet through klt sim --backend batch (batch_backend.py), then
    screens and post-processes them exactly as the local loop does. OSDI
    binaries (including cap_cmomi, absent from the runner image) are staged with
    each job and loaded from its inputs/ directory. Re-baselines the delta table
    on the last pre-EN record (20260917-023832-7061e8f).
    Loom-Story: 2AMLogic/sg13g2-ldo#67
    Loom-Trace-Id: 526b1eaac8f259b98cc9a0b34ea2ef4b
    Loom-Build: 0.19.996 0d2be7e9ae05753e2c9232a83b7399d45de5396e clean
2026-10-10 fix(sim): layer duplicate points and add a plan-only mode to the batch backend (#67)
    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
2026-10-10 sim: parameterise loop-gain/PSRR benches over load, Cout, ESR; add bounded dynamic DoE tooling (#64)
    Loom-Story: 2AMLogic/sg13g2-ldo#64
    Loom-Trace-Id: 15323f5650c96f1e1ab1cb6fabe4f540
    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
    [loopgain_dyn_ss_125c_rbcs_i1000ua_c1000nf_e0mohm_ac.csv, psrr_dyn_ss_125c_rbcs_i1000ua_c1000nf_e0mohm_ac.csv]
2026-10-10 signoff: regenerate item-9 inventory, item-8 report and T1 report (#64)
    The PR edits inventoried/pinned constituents (sim/ldo-cmos5l-pvt-sweep
    README.md, run_sweep.sh and the loop-gain/PSRR templates), so regenerate
    in the documented order:
    - python3 signoff/evidence_inventory.py write (item 9 inventory, envelope,
    manifest pin 8e06c9e4 -> 6d59dc1c)
    - python3 sim/characterization/generate.py (only the README.md source pin
    moved; item-8 pin 53b0a278 -> bcadb0ad in the envelope and manifest)
    - klt signoff --manifest with the pinned build 0.7.0+gb82427b30c96
    (exit 3 as before; only the three cited content_hash fields changed)
    No measurement, row state, verdict, DR-0007, spec or prior evi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
2026-10-10 sim: re-run the 45-point grid on the EN design via the batch fleet and reselect evidence (#67)
    Record sim/ldo-cmos5l-pvt-sweep/records/20261010-025634-60a3e81: run_sweep.sh
    --batch, 214/214 points on the EDA batch fleet (22 klt sim requests, real
    cap_cmomi via staged OSDI), EN tied to VIN, design netlist 7953b25b. Against
    the pre-EN record 7061e8f the largest shifts are -0.015 deg PM, -0.023 dB GM,
    -0.001 dB PSRR, -0.43 nA Iq; binding corners unchanged.
    The batch backend reproduced six points of the local ngspice-46 record
    byte-for-byte (backend-validation/20261010-025044).
    Reselects the record in sim/characterization (envelope current/pass again),
    repoints item5_evidence.py, adds batch_ba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
    [20261010-025634-60a3e81.cc-tolerance.csv, 20261010-025634-60a3e81.csv, 20261010-025634-60a3e81.delta.csv, 20261010-025634-60a3e81.divider-attribution.csv, 20261010-025634-60a3e81.sensitivity.csv, dc-informational-summary.csv, dcsweep_ff_-40c_rbcs_dc.csv, dcsweep_ff_-40c_rtyp_dc.csv]
2026-10-10 sim: record merge provenance for the batch record and regenerate derived evidence (#67)
    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
2026-10-10 layout: draw EN port and XMen/XMbdis, refresh DRC/LVS/ERC and signoff evidence (#68)
    Loom-Story: 2AMLogic/sg13g2-ldo#68
    Loom-Trace-Id: a8ae5774948cba041e550b49ce234c34
    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
2026-10-10 sim: require output artifacts before --check-env preflight reports success (#91)
    Loom-Story: 2AMLogic/sg13g2-ldo#91
    Loom-Trace-Id: e772ef406d049d3c313722ab7105584e
    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
2026-10-10 signoff: regenerate item 9/10 inventories and T1 report for #91 edits
    The #91 changes to sim/ldo-cmos5l-pvt-sweep/run_sweep.sh,
    sim/pass-device-screening/run_sweep.sh and .github/workflows/ci.yml are
    inventoried constituents of items 9 and 10, so the committed inventories
    went stale. Regenerated per signoff/README.md "Regenerating":
    python3 signoff/evidence_inventory.py write
    klt signoff --manifest signoff/sg13g2-ldo.json --format json \
    > signoff/sg13g2-ldo.t1-report.json # pinned 0.7.0+gb82427b30c96
    Only sha256/content_hash values move. No item status, verdict, tier or
    build block changed (exit 3, t1_met_count 8). Item 8 unaffected
    (generate.py --check OK).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
2026-10-10 ci: run the SG13CMOS5L topology guard in characterization-report (#94)
    Loom-Story: 2AMLogic/sg13g2-ldo#94
    Loom-Trace-Id: 4e1119a44041521fdbbc57a18d29968d
    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
2026-10-10 ci: gate that the enable-smoke record reproduces from its raw reports (#96)
    Loom-Story: 2AMLogic/sg13g2-ldo#96
    Loom-Trace-Id: f32a24a690014daa23d199394133b981
    Loom-Build: 0.19.1009 8889f7bd1eccfb4bc8239e7f5669b65f9815c30e clean
2026-10-10 chore: resync installed Loom surfaces
    <!-- loom:provenance v1 build=unknown c156f673e072832aaacb4cd1ec65b742e7f45867 clean prompts=none sweep=none story=none trace=9de99c124c651049199abe9a75070dc7 host=robb-pro base=99242983b659f13b6bbd4aed64cf713eb7997ebb run=loom-run/v1:timer:robb-pro/fleet-resync:f790885c-7154-4b3d-acd9-71fd537cd20b installs=0.19.1010 d1d5fcecb79550fe39658555a4419f98cec060fb -->
    Loom-Trace-Id: 9de99c124c651049199abe9a75070dc7
    Loom-Build: unknown c156f673e072832aaacb4cd1ec65b742e7f45867 clean
    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
2026-10-10 chore: resync installed Loom surfaces
    <!-- loom:provenance v1 build=unknown 52f79668bb5f93c1828b7f1ea4f7013b917b847b clean prompts=none sweep=none story=none trace=7057f3175071f1f6e34b354fab40a0ce host=robb-studio base=43a53a9c40d54e4fc88f674c79b4ada06a749a93 run=loom-run/v1:timer:robb-studio/fleet-resync:d8918779-1625-4202-b151-71f64465e8cd installs=0.19.1010 d1d5fcecb79550fe39658555a4419f98cec060fb -->
    Loom-Trace-Id: 7057f3175071f1f6e34b354fab40a0ce
    Loom-Build: unknown 52f79668bb5f93c1828b7f1ea4f7013b917b847b clean
    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
2026-10-10 docs: update work log and current Loom work plan
2026-10-10 sim: route the #64 dynamic DoE through the batch fleet (--doe-generate --batch)
    batch_backend.py keeps a sparse (section, temp) set in one klt sim request
    via klt's exclude list instead of splitting it per temperature (the main
    grid is unchanged: all of its groups are full cross products). run_sweep.sh
    factors the batch run/screen step into run_batch_queue and, under --batch,
    submits every DoE point, then runs dynamic_doe.py analyse/refine.
    --doe-only-extra/--doe-base simulate refinement points only and analyse
    them with the base record. dynamic_doe.py takes several corners dirs, a
    repeatable --legacy-record, and records each row's source directory.
    Part of #64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
2026-10-10 sim: batch_backend --variant-lines so the #64 DoE runs as one request per bench
    The first campaign attempt (one klt sim request per operating point, 96
    requests) cost ~12 min of fleet overhead per ~25 s job. batch_backend.py
    now moves body lines matching --variant-lines (the DoE's Iload/Cout/Resr
    lines) verbatim into each point's own corners.lib section, so all
    operating points of a bench share one request. run_sweep.sh passes it on
    the --doe-generate --batch path only; the main grid is unchanged.
    Validated on the fleet: 20 points run both ways are byte-identical, and
    the 1 mA / 1 uF / 0 ohm loop-gain point matches record 60a3e81 exactly at
    all four corners (backend-validation/20261010-vari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
    [points.tsv]
2026-10-10 sim: dynamic_doe counts every measured metric, adds per-corner target-miss table
    A loop-gain trace with no -180 degree crossing in band has no gain margin
    but a valid phase margin, and its PSRR is unaffected. Such rows stay
    'failed' in the completeness accounting but now contribute the metrics they
    did measure to the extrema, the target-miss counts and the refinement
    slices, instead of silently dropping out. The record CSV gains
    phase_margin_worst_deg (the existing parser's worst-crossing PM).
    Part of #64
    Loom-Build: 0.19.1009 8889f7bd1eccfb4bc8239e7f56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
2026-10-10 sim: #64 dynamic DoE campaign, 384 AC runs on the batch fleet (record 20261010-091123-a31c626)
    4 PVT/resistor corners x 48 load/Cout/ESR points x {loopgain, psrr}, run
    as 2 klt sim --backend batch requests (jobs klt-sim-90c2614832a7,
    klt-sim-4742f4a08f98). 384/384 simulations completed and passed
    screening. 14 loop-gain points have no -180 degree crossing in band
    (gain margin unmeasured), so dynamic_doe.py analyse reports the matrix as
    incomplete (178/192 rows fully measured). The legacy 1 mA / 1 uF / 0 ohm
    point is within 0.10 deg / 0.10 dB of record 7061e8f and identical to
    60a3e81 at all four corners. Exploratory evidence only; DR-0007 is
    unchanged. analyse/refine outputs were regenerated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
    [20261010-091123-a31c626.dynamic-doe.csv, 20261010-091123-a31c626.dynamic-doe.manifest.tsv, loopgain_dyn_ff_-40c_rwcs_i0ua_c1000nf_e0mohm_ac.csv, loopgain_dyn_ff_-40c_rwcs_i0ua_c1000nf_e250mohm_ac.csv, loopgain_dyn_ff_-40c_rwcs_i0ua_c1000nf_e500mohm_ac.csv, loopgain_dyn_ff_-40c_rwcs_i0ua_c2200nf_e0mohm_ac.csv, loopgain_dyn_ff_-40c_rwcs_i0ua_c2200nf_e250mohm_ac.csv, loopgain_dyn_ff_-40c_rwcs_i0ua_c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]
2026-10-10 sim: batch_backend --max-points-per-request (SWEEP_BATCH_MAX_POINTS)
    One Spot interruption held a 192-point request for 80 min with no relaunch
    (klayout-tools#2992). Capping the points per request bounds what one
    interruption can hold up. The default is no cap, so earlier plans are
    unchanged.
    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
2026-10-10 sim: batch_backend re-submits requests refused by the fleet concurrency cap
    klt's capacity_wait_s does not cover 'exceeds BATCH_MAX_CONCURRENT_INSTANCES'
    refusals (klayout-tools#2917), so the first refinement attempt lost 7 of 8
    requests at launch. Nothing ran for a refused request, so it is re-submitted
    to the fleet with a jittered backoff for up to --cap-wait-s (default 3600 s),
    logged in cap-retries.log. Never a local fallback.
    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
2026-10-10 sim: #64 dynamic DoE refinement round 1, 688 AC runs on the batch fleet (record 20261010-101245-6df50fd)
    The 344 midpoints the base matrix's triggers requested
    (records/20261010-091123-a31c626.dynamic-doe.refine.json), x {loopgain,
    psrr}, run as 6 klt sim --backend batch requests via --doe-only-extra and
    analysed together with the base record (--doe-base). 688/688 completed and
    passed screening. The combined analysis (536 operating points, 1072
    simulations) has 46 rows with gain margin unmeasured (no -180 degree
    crossing in band), so it is not complete. Re-deriving the rule over base +
    refinement requests 678 second-round midpoints, which are recorded as
    PENDING and not run. Exploratory only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
    [20261010-101245-6df50fd.dynamic-doe.csv, 20261010-101245-6df50fd.dynamic-doe.manifest.tsv, loopgain_dyn_ff_-40c_rwcs_i0ua_c1000nf_e125mohm_ac.csv, loopgain_dyn_ff_-40c_rwcs_i0ua_c1000nf_e375mohm_ac.csv, loopgain_dyn_ff_-40c_rwcs_i0ua_c1600nf_e0mohm_ac.csv, loopgain_dyn_ff_-40c_rwcs_i0ua_c1600nf_e250mohm_ac.csv, loopgain_dyn_ff_-40c_rwcs_i0ua_c1600nf_e500mohm_ac.csv, loopgain_dyn_ff_-40c_rwcs_i0ua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]
2026-10-10 docs: README Dynamic DoE section reports the #64 campaign, refinement and failures
    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
2026-10-10 signoff: regenerate item 8/9 evidence and T1 report for #64 edits
    The #64 edits to sim/ldo-cmos5l-pvt-sweep/{README.md,run_sweep.sh,
    batch_backend.py} are item-9 inventory constituents, and the README is a
    pinned source of the item-8 characterization report. Regenerated per
    signoff/README.md "Regenerating":
    python3 signoff/evidence_inventory.py check # OK
    python3 sim/characterization/generate.py # item-8 pin -> sha256:02d80f4f...
    python3 sim/characterization/generate.py --check # OK
    > signoff/sg13g2-ldo.t1-report.json # pinned 0.7.0+gb82427b30c96 via uvx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
2026-10-10 ci: gate design/netlist.py --check for the SG13CMOS5L design; refresh ci.yml header (#103)
    Loom-Story: 2AMLogic/sg13g2-ldo#103
    Loom-Trace-Id: b37cf465d213585dea9c35e81ad6671e
    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
2026-10-10 feat(sim): SG13CMOS5L startup bench, evaluator and bounded PVT campaign (#69)
    Adds tb_startup_cmos5l.spice.tmpl, a fail-closed startup_eval.py with fixture
    tests, startup_campaign.py (klt sim --backend batch only), request artifacts,
    append-only records (nominal, 135-point grid, half-step, load/Cout/ESR
    extension) and DR-0009 (proposed methodology). DR-0007 row 9 stays Open.
    Loom-Story: 2AMLogic/sg13g2-ldo#69
    Loom-Trace-Id: 9a7cb8463e6e1212aa234a125de8c833
    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
    [20261010-075612-91e92aa-startup-nominal.csv, 20261010-104827-91e92aa-startup-ext.csv, 20261010-104827-91e92aa-startup-grid.csv, 20261010-104827-91e92aa-startup-halfstep.csv, 20261010-104827-91e92aa-startup-nominal.csv]
2026-10-10 signoff: inventory the #69 startup bench and regenerate item 8/9 evidence and T1 report
    After merging main, evidence_inventory.py check failed: the new
    testbench/tb_startup_cmos5l.spice.tmpl matches the item-9 completeness
    glob but was not inventoried. Added it (with startup_campaign.py and
    startup_eval.py, alongside batch_backend.py) to ITEMS[9]. The merged
    sim/ldo-cmos5l-pvt-sweep/README.md is a pinned item-8 source, so the
    characterization report was regenerated too. Per signoff/README.md:
    python3 sim/characterization/generate.py # item-8 pin -> sha256:3a57fe3c...
    python3 s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
    [evidence_inventory.py]
2026-10-10 spec+sim: DR-0009 proposed row-4 dropout definition, reducer, 45-point batch campaign (#70)
    Loom-Story: 2AMLogic/sg13g2-ldo#70
    Loom-Trace-Id: 75d4290cf1c6ef0462e7a3728dec48e0
    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
    [20261010-111618-19e8e39.dropout.csv, dcsweep_ff_-40c_rbcs_dc.csv, dcsweep_ff_-40c_rtyp_dc.csv, dcsweep_ff_-40c_rwcs_dc.csv, dcsweep_ff_125c_rbcs_dc.csv, dcsweep_ff_125c_rtyp_dc.csv, dcsweep_ff_125c_rwcs_dc.csv, dcsweep_ff_27c_rbcs_dc.csv]
2026-10-10 spec+signoff: renumber row-4 dropout record to DR-0012 and regenerate pinned evidence
    Judge re-review on #108 raised two blockers.
    1. Duplicate DR-0009. Main already has DR-0009 (startup measurement
    methodology, #69). The row-4 record moves to DR-0012. DR-0010, DR-0011
    and DR-0013 were skipped because spec/porting-plan.md cites them.
    The title, the spec/README.md index and the sim README prose are
    updated. An alias note goes in DR-0012, spec/README.md, the sim README
    and the startup DR-0009 record. It says the sim/ldo-cmos5l-pvt-sweep/
    artifacts labelled "DR-0009" belong to DR-0012: the dropout template
    (its sha256 is pinned in the record), the netlist snapshots, run/re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
    [evidence_inventory.py]
2026-10-10 docs: point CLAUDE.md/AGENTS.md at signoff regeneration contract; refresh item-10 pins (#107)
    Loom-Story: 2AMLogic/sg13g2-ldo#107
    Loom-Trace-Id: 61845450371340070991b4730491c2f4
    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
2026-10-10 chore: resync installed Loom surfaces
    <!-- loom:provenance v1 build=unknown 525fe43b7b1b2a0271084bba444c934a1541a8d8 clean prompts=none sweep=none story=none trace=0d4424bd058cf912b74934ec0e7bf37e host=robb-pro base=7c64e0459f5c22e39152c58110ee95e36d9e1eac run=loom-run/v1:timer:robb-pro/fleet-resync:4812047c-8b9b-4da2-a5dc-13e6f6420a04 installs=0.19.1018 13e54f1cfc513507a7ef84ec6908085638d9c187 -->
    Loom-Trace-Id: 0d4424bd058cf912b74934ec0e7bf37e
    Loom-Build: unknown 525fe43b7b1b2a0271084bba444c934a1541a8d8 clean
    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
2026-10-10 ci+layout: gate layout/run_flow.sh --check in CI; make check mode fail on stale artifacts (#101)
    Add a PDK-free `layout-check` job that runs `layout/run_flow.sh --check`
    with klt pinned to the build that produced the committed drc/extract/lvs
    reports (KLAYOUT_TOOLS_LAYOUT_REF = b15edf5e3a2e) and KLayout Python
    0.30.12. Under the signoff pin (b82427b) the curated deck hash differs, so
    an untouched tree reports provenance.deck.content_hash DRIFTED.
    Fix check mode: `cmp a b && echo ok` under `set -e` never failed, so a
    stale committed reference netlist / GDS / tap-box document exited 0. Each
    comparison now fails naming the file. Also run `klt extract --check` so the
    extracted netlist LVS compa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
2026-10-10 ci+sim: enforce append-only sim/ evidence at PR time (#102)
    Stdlib checker sim/tools/check_append_only.py rejects modification, deletion
    or rename of landed paths under six protected classes, fails closed on an
    unresolvable base, supports exact-path allowlist with rationale. Tests drive
    the real CLI on temp git repos incl. the 434c822 coverage-inventory shape.
    Signoff inventories and T1 report regenerated (exit 3, non-T1 as before).
    Loom-Story: 2AMLogic/sg13g2-ldo#102
    Loom-Trace-Id: 61e6f0d8fd5871fffc0ca1ab3fbcf208
    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
2026-10-10 fix(sim): read append-only allowlist from head commit; reject nested directory entries (#102)
    - Default allowlist is the blob at the evaluated --head, not the working tree;
    absent vs non-file/unreadable distinguished. --allowlist is a local-debug
    override, announced and refused under GITHUB_ACTIONS.
    - Exceptions naming a tree at the merge base or head fail closed (exit 2).
    - Regression tests for untracked/modified policy, --head != checkout, nested
    directory entries, deleted-file exceptions, override contract.
    - Refreshed item-9 inventory, manifest pin and T1 report (exit 3 unchanged).
2026-10-10 chore: resync installed Loom surfaces
    <!-- loom:provenance v1 build=unknown 525fe43b7b1b2a0271084bba444c934a1541a8d8 clean prompts=none sweep=none story=none trace=d4059def94f46d8d158946acddd4d602 host=robb-studio base=40fb007995bd292f1c79bff99046e0be0c7f5692 run=loom-run/v1:timer:robb-studio/fleet-resync:4a4d1995-968e-44c5-b5fe-804b4d477795 installs=0.19.1019 febfc4335d0554865fadbecba718245cd88c6678 -->
    Loom-Trace-Id: d4059def94f46d8d158946acddd4d602
    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
2026-10-10 docs: qualify row 4 branch status (ratified target; SG13CMOS5L met, SG13G2 unevidenced) (#71)
    Loom-Story: 2AMLogic/sg13g2-ldo#71
    Loom-Trace-Id: 031bc43efe32e525efabbaa9a315be3c
    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
2026-10-10 test(characterization): retarget row-4 status negative controls to the new README cell (#71)
    The README row-4 status cell now reads "RATIFIED as a shared target
    (stretch not ratified); ...", so the old replace target
    "RATIFIED (stretch not ratified)" was a silent no-op and both controls
    ran against an unmodified README. Point them at the new text and assert
    the target is present so a future cell edit fails loudly instead of
    silently disarming the control. generate.py is unchanged.
    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
2026-10-10 test: offline unit tests with negative controls for layout/ and design/ helpers (#114)
    Adds test modules for lvs_reference, erc_ties and design/netlist helpers,
    wires them into the offline CI job, and refreshes signoff inventories and
    the T1 report (ci.yml is hash-pinned). Exit 3 non-T1 verdict unchanged.
    Loom-Story: 2AMLogic/sg13g2-ldo#114
    Loom-Trace-Id: 74dc3b6bcd554fd06511a544e6c148b3
    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
2026-10-10 sim: version the row-2 MC bench for the six-port EN core (#88)
    The five-port tb_row2_accuracy.spice no longer elaborates against the
    six-port ldo_core_cmos5l (#67). It is kept byte-for-byte as the deck of
    record 20261009-003009-3ee8306, whose raw reports pin it by sha256.
    run_campaign.sh check never hashes the deck, so an in-place edit would
    keep CI green while falsifying that provenance; the bench is versioned
    by file instead.
    - tb_row2_accuracy_en.spice: same deck with EN tied to VIN (the
    pvt-sweep templates' convention); all request-row2-*.json select it.
    - test_deck_versioning.py (picked up by the monte-carlo-record CI job):
    historical bytes pinned, every bench file a committed raw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
2026-10-10 chore: resync installed Loom surfaces
    <!-- loom:provenance v1 build=unknown 5d5f41d89eef35adf478b92b96af06c6d86d27a6 clean prompts=none sweep=none story=none trace=05d2a40831b35ba1c48afada00c29519 host=robb-pro base=5d0f834a458777b3198c594ed84cb71d63c9fe87 run=loom-run/v1:timer:robb-pro/fleet-resync:c58bb82e-a213-439d-b829-04234e141de9 installs=0.19.1028 48ce8a23fdab3059d078e9fffca79e4d4c911d60 -->
    Loom-Trace-Id: 05d2a40831b35ba1c48afada00c29519
    Loom-Build: unknown 5d5f41d89eef35adf478b92b96af06c6d86d27a6 clean
    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
2026-10-10 test: direct contract tests with negative controls for ac_metrics.py (#117)
    Loom-Story: 2AMLogic/sg13g2-ldo#117
    Loom-Trace-Id: ebf65e83198e63b1ea7c2d9883032154
    Loom-Build: 0.19.1026 09a449709f5a1c6ae81b471ef56d466247e50808 clean
2026-10-10 chore: resync installed Loom surfaces
    <!-- loom:provenance v1 build=unknown aa536103d6239818bb974a51d2f7f268eff38bad clean prompts=none sweep=none story=none trace=126a1328a3664e2119a0978086db9bea host=robb-studio base=b3a6d1440e8483bad8f462315d59bbe7a7358cdf run=loom-run/v1:timer:robb-studio/fleet-resync:fbc4e361-e290-4d81-ae3a-8b5fde796815 installs=0.19.1032 13ca937a7d6ba8768c296b0c126f2ce48f5f7ca4 -->
    Loom-Trace-Id: 126a1328a3664e2119a0978086db9bea
    Loom-Build: unknown aa536103d6239818bb974a51d2f7f268eff38bad clean
    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
2026-10-11 sim: shared complete-grid validation for live sweep and item-5 DC analysis (#120)
    Loom-Story: 2AMLogic/sg13g2-ldo#120
    Loom-Trace-Id: b92426e3845f2f6e943740aecc94f3fd
    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
2026-10-11 sim: keep pinned item5 generator and landed evidence byte-identical (#120)
    Revert the edits to item5_evidence.py and to the landed, append-only
    evidence/20261010-025634-60a3e81/coverage-inventory.json. Apply the shared
    dc_grid contract to the offline item-5 path through a thin wrapper,
    item5_grid.py. It rebinds item5_evidence.split_blocks to
    dc_grid.validate_file and runs the unchanged generator. CI byte-checks
    through the wrapper too. Tests pin the generator and parser hashes to the
    landed inventory. Offline negative controls now run through the wrapper,
    including the failure accounting in reproduce_record.
    Loom-Story: 2AMLogic/sg13g2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
2026-10-11 signoff: regenerate inventories, item-8 envelope and T1 report (#120)
    Following signoff/README.md#regenerating after the final source edits
    (ci.yml, sim/ldo-cmos5l-pvt-sweep/README.md, item5_grid.py). The inventory
    check is current for items 1/2/9/10. generate.py moved only the
    superseded_evidence_statement source pin, so the item-8 pin is now
    sha256:25023e2e. Regraded with the pinned build 0.7.0+gb82427b30c96 (clean
    clone in a /tmp venv): exit 3, tier null, 8/11 met. Only content_hash lines
    moved, and a second run reproduces the committed report byte-for-byte.
    Loom-Trace-Id: b92426e3845f2f6e943740ae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
2026-10-11 characterization: consume pinned loaded DC evidence for rows 5 and 7 (#123)
    Loom-Story: 2AMLogic/sg13g2-ldo#123
    Loom-Trace-Id: c6ab7469107c7307d936dce566ca2006
    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
2026-10-11 characterization: integrate measured startup failures into the row-9 report (#112)
    Select the committed startup campaign (20261010-104827-91e92aa grid) by path
    and sha256 in selection.json and load it in generate.py: per-trace hash
    checks, independent core / error-amp freshness, requested/evaluated/missing/
    insufficient counts, settling/overshoot/monotonicity metrics with coordinates,
    proposed-methodology disclosure. Row 9 reports fail (135/135 measured) and
    stays Open; no ratification inferred. Replaces the "no EN / no transient
    bench" claim. Fixtures cover tampered/missing files, stale core/error-amp,
    duplicate/missing points, insufficient traces and failure despite 3 ms
    settling. Inventor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
2026-10-11 design: hold the SG13CMOS5L erramp G1 node at VSS when EN is low (#89)
    Xamp gains EN as a seventh pin; a local inverter (Minvp/Minvn) drives a
    w=1u l=1u NMOS pull-down (Mpd) on G1 so Mn3 is off when disabled. The core
    connects its EN port to Xamp. The loop-gain template, its topology guard
    (plus three new negative controls) and a versioned enable-smoke loop-gain
    deck follow the port change; the grid delta is re-baselined to the #67
    record 20261010-025634-60a3e81. Adds the disabled-g1 smoke request.
    Loom-Story: 2AMLogic/sg13g2-ldo#89
    Loom-Trace-Id: 988107606645d8bde3047967adabb73b
    Loom-Build: 0.19.1039 e83d19dc0a9b217339ea2f14040c50ad6f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
2026-10-11 layout: draw the erramp G1 disable pull-down and refresh DRC/LVS/ERC (#89)
    XMinvp in the enable NWell, XMinvn/XMpd with a second substrate tie bar,
    a new ENB Metal3 track. Full run_flow.sh on the pinned builds: both DRC
    decks clean, LVS match (17 devices), six LVS negative controls mismatch
    (new: Mpd deleted), ERC clean with three checked ties.
    Loom-Build: 0.19.1039 e83d19dc0a9b217339ea2f14040c50ad6f46700d clean
    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
2026-10-11 spec+sim: classify row-10 margins under proposed DR-0014 (multi-crossing PM, no -180 deg GM)
    Add DR-0014 (proposed; row 10 stays Open, targets unchanged) defining how
    row-10 phase and gain margins are read from a loop-gain trace: every 0 dB
    and -180 deg crossing in the sweep counts and the scored margin is the
    minimum; a PM crossing's margin is its angular distance from the critical
    point, signed negative after an in-band encirclement; a miss inside the
    sweep is a fail; a pass also needs a bounded sweep ceiling (loop gain
    <= -10 dB and non-increasing over the last decade). A trace with no
    -180 deg crossing is neither a miss nor infinite margin.
    ac_metrics.classify_margins implements the rul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
2026-10-11 sim: enable smoke record 20261011-031743-df3f802 for the G1 pull-down (#89)
    Disabled supply current, VOUT floating, tt/27C: 2.0003 / 2.0006 /
    2.0012 uA at Vin 2.97 / 3.30 / 3.63 V (was 53.7 / 73.2 / 99.6 uA); G1 at
    3-14 nV. Enabled-state deltas vs the pre-#67 baseline unchanged in kind.
    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
2026-10-11 sim: startup grid record 20261011-031426-df3f802 on the G1 pull-down design (#89)
    135/135 points evaluated on the batch fleet (15 klt sim jobs). Verdicts
    unchanged in kind (all fail on overshoot/monotonicity; no soft start).
    startup_offstate.py reads the true off-state supply current from the
    committed traces: 2.000-2.264 uA over the 135 points (was 2.000-358 uA).
    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
2026-10-11 chore: resync installed Loom surfaces
    <!-- loom:provenance v1 build=unknown cf08873555e2eb95da295dcbee98b0dc34473381 clean prompts=none sweep=none story=none trace=67fbc483c3ca3e442d7928804c11ff06 host=robb-pro base=f0b4da0c0eb0574e271fff59881db4fc9943de9d run=loom-run/v1:timer:robb-pro/fleet-resync:e3f97888-2b26-404a-bd47-86fd28a4eced installs=0.19.1041 b65c266b47d796bf37d1c04c6f616be0bc699056 -->
    Loom-Trace-Id: 67fbc483c3ca3e442d7928804c11ff06
    Loom-Build: unknown cf08873555e2eb95da295dcbee98b0dc34473381 clean
    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
2026-10-11 sim: batch backend can reuse byte-identical completed fleet reports (#89)
    The first #89 grid run lost its client after 21 of 22 requests had
    completed on the fleet (one job never returned; the client was stopped at
    its wall-clock limit). --reuse-work / SWEEP_BATCH_REUSE_WORK reuses an
    earlier report only for a byte-identical request with a complete report
    and existing rawfiles, records the reuse in _batch/reused-reports.tsv and
    backend.json, and submits everything else to the fleet. Never local.
    Loom-Build: 0.19.1039 e83d19dc0a9b217339ea2f14040c50ad6f467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
2026-10-11 sim: 45-point PVT grid record 20261011-051956-eda9285 on the G1 pull-down design (#89)
    214/214 points on the batch fleet, completeness OK; delta table vs
    20261010-025634-60a3e81 (540 rows). 4 of 22 requests reuse byte-identical
    completed fleet reports from the interrupted first run
    (_batch/reused-reports.tsv); the other 18 were resubmitted.
    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
2026-10-11 spec+sim+signoff: DR-0008 addendum, reselect records, regenerate signoff (#89)
    DR-0008 addendum 'G1 disable pull-down': option 1 chosen (EN pin on the
    erramp, local inverter, 1u/1u NMOS on G1), options 2/3 and IBIAS gating
    rejected with reasons; disabled and enabled-state results with every
    metric's per-point delta range vs 20261010-025634-60a3e81.
    Characterization selection moves to grid record 20261011-051956-eda9285
    and startup record 20261011-031426-df3f802; item-5 informational evidence
    regenerated for the new record; tests updated to the new worst cases (and
    the DC-summary mutation helper now refuses a no-op mutation). Inventories,
    item-8 envelope, manifest pins (items 1/2/3/4/8/9/11)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
2026-10-11 chore: resync installed Loom surfaces
    <!-- loom:provenance v1 build=unknown e91831edf7b55b29d3a2d88e266916fab9ce2563 clean prompts=none sweep=none story=none trace=f72dd67520a2c3802aa0495b80ac65a5 host=robb-studio base=b452d9c82defbc8e58fe8cbd5309ccf504818adb run=loom-run/v1:timer:robb-studio/fleet-resync:91d2434e-eae5-45de-9305-d78c43fc7c7a installs=0.19.1042 5b6ebdcc40bfccc9357e15196984061f1d5e6178 -->
    Loom-Trace-Id: f72dd67520a2c3802aa0495b80ac65a5
    Loom-Build: unknown e91831edf7b55b29d3a2d88e266916fab9ce2563 clean
    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
2026-10-11 sim: bind --reuse-work reports to a sha256 inventory of their input closure (#89)
    Persist inputs.sha256.json per fleet group (design netlist, model cards,
    nested includes, OSDI binaries); reuse only when it equals the current one,
    fail closed when the earlier work dir has none. Negative controls change an
    included file in place with the compared text unchanged. README states that
    the 4 reused groups of 20261011-051956-eda9285 remain unproven (follow-up
    #132). Signoff inventories, characterization and T1 report regenerated with
    the pinned grader (exit 3, 8/11).
2026-10-11 sim: make the loop-gain AC ceiling a validated runner input (#128)
    Loom-Story: 2AMLogic/sg13g2-ldo#128
    Loom-Trace-Id: 76b0e7177e373ab31aa998e64279ea38
    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
2026-10-11 startup_eval: sample off-state current in the disabled plateau, not the EN edge (#130)
    Cold-start off window is now the contiguous initial EN <= 1 mV plateau; adds
    startup_campaign.py recollect, new record 20261011-070146-0c95530 from the
    committed traces (no simulation), DR-0009 amendment, deliberate reselection,
    regenerated inventories/characterization/T1 report (exit 3, unchanged grades).
    Loom-Story: 2AMLogic/sg13g2-ldo#130
    Loom-Trace-Id: eadb39b2c0fad4ecdb8f3406a9ba0af2
    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
2026-10-11 sim: 45-point grid with the loop-gain sweep to 10 GHz; reselect, regenerate signoff (#128)
    Record 20261011-070111-5391c68 (batch, 22 klt sim requests, 214/214). The loop
    gain flattens near +1 dB above 1 GHz, so DR-0014 still scores 45 ambiguous
    (ceiling_unbounded), 0 pass, 0 fail. The characterization generator now reads
    the sweep ceiling from the traces instead of quoting 100 MHz. Inventories,
    characterization and the T1 report regenerated with the pinned grader (exit 3).
    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
2026-10-11 test+CI: gate startup_offstate.py against the DR-0008 disabled-state current (#133)
    Loom-Story: 2AMLogic/sg13g2-ldo#133
    Loom-Trace-Id: c4e30b205aefaef81de6fc2e91c95e37
    Loom-Build: 0.19.1050 abf3f7109328fd66ec77827f5fd849f5279fee82 clean
2026-10-11 docs: DR-0015 — fix mislabelled margin numbers and record-CSV sign footnotes (review #140)
    - Quote the true 10→100 MHz last-decade changes (P1 +12.34, P2 +5.31,
    P5 +9.10 dB, ceiling_last_decade_change_db in the committed
    row10-margins.csv) instead of the min-to-ceiling rises that were
    mislabelled as last-decade changes
    - Fix the 10 GHz reference level: the ceiling gain +0.398…+1.17 dB is
    relative to 0 dB, i.e. 10.40…11.17 dB above the −10 dB ceiling floor
    - Note the DR-0014 angular-distance vs raw-record sign convention for
    the P2/P4 worst-crossing values (record CSV stores −162.51/−162.38)
    - Note the 500 mΩ P2 ESR record row is status=failed (no −180° crossing,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
2026-10-11 chore: resync installed Loom surfaces
    <!-- loom:provenance v1 build=unknown 5ec729b9f7dd55a2082752611e4c4964f49661fb clean prompts=none sweep=none story=none trace=efc2abc8b72538df6d1a6ea9d329603d host=robb-pro base=1240c8ba75afc339c0679dc096ffa8ccb40eea33 run=loom-run/v1:timer:robb-pro/fleet-resync:0d396c06-f26e-423e-97ac-6d3ac04a8e51 installs=0.19.1056 4e44d8f5faa6c6c58d2a3436ce3a983613cf375a -->
    Loom-Trace-Id: efc2abc8b72538df6d1a6ea9d329603d
    Loom-Build: unknown 5ec729b9f7dd55a2082752611e4c4964f49661fb clean
    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
2026-10-11 ci: run each sim/tools test suite once under its matching step (#138)
    Loom-Story: 2AMLogic/sg13g2-ldo#138
    Loom-Trace-Id: e5f30a67ec622d2c55c4a80f5894b0cc
    Loom-Build: 0.19.1055 4737928b703aa8a4c87d04eefbf7299fb933eab4 clean
2026-10-11 docs: sim/README explicit design-branch / PDK pin / fleet provenance table (#141)
    Loom-Story: 2AMLogic/sg13g2-ldo#141
    Loom-Trace-Id: 851819c58849f0f90d0ae1ecb60420cf
    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
2026-10-11 docs: sim/README provenance table matches raw reports (review #143)
    - Restate fleet ngspice: the 56 reports of startup campaigns
    20261010-075612-91e92aa (13) and 20261010-104827-91e92aa (43) record
    ngspice_binary /home/ubuntu/.local/bin/ngspice; 8 in 075612 (grid g000/
    g001/g002/g004, grid-attempt1-aborted g000/g002, probe report2/report4)
    record engine_version null. Executed binary for those is unknown.
    - Separate the local probe 20261010-032206-4d45f5d from the September
    records: local ihp-sg13cmos5l install + local OSDI, ngspice version and
    checkout commit not recorded.
    - MC row: add en-smoke evidence (client klt 0.7.0+g39f6da54ae4c, six-port
    tb_row2_accuracy_en.spice); attr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
2026-10-11 chore: resync installed Loom surfaces
    <!-- loom:provenance v1 build=unknown 745f69d0daad6c23e76cc006720fa4fbeaa3d887 clean prompts=none sweep=none story=none trace=3baabc4a039fd85029fff227a6ae690a host=robb-studio base=f0fed5aa1685446e253dc76fce409489125fe979 run=loom-run/v1:timer:robb-studio/fleet-resync:3b3207d7-055d-49b5-a387-db375213668d installs=0.19.1060 3336676408ee1d4f1df2dc7f23adbb6c3170674e -->
    Loom-Trace-Id: 3baabc4a039fd85029fff227a6ae690a
    Loom-Build: unknown 745f69d0daad6c23e76cc006720fa4fbeaa3d887 clean
    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
2026-10-11 sim: HBT pass-device screening decks (npn13G2 family / pnpMPA) and run_sweep.sh (#139)
    Loom-Story: 2AMLogic/sg13g2-ldo#139
    Loom-Trace-Id: 934a453363fe67a004a3c7c393a1f1b2
    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
2026-10-11 sim: HBT screening - DC servo bench, record.py, --check-env (#139)
    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
2026-10-11 sim: HBT screening - README, tests, CI wiring, inventory; preamble gminsteps=0 (#139)
    Loom-Build: 0.19.1065 33bb950d65b9038d5cf119a252820edca1192edf clean
    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
2026-10-11 sim: HBT screening - gminsteps=0 on pnpMPA servo only (#139)
    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
2026-10-11 sim: HBT screening record 20261011-145941-ccb529c8 (72 batch units) (#139)
    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
2026-10-11 docs: DR-0001a HBT addendum, sibling link, CI/sim README (#139)
    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
2026-10-11 signoff: refresh inventories and T1 report for HBT screening (#139)
    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
2026-10-11 sim: import fresh fleet rerun bcc60e2 as append-only evidence for the four reused groups (#132)
    Loom-Story: 2AMLogic/sg13g2-ldo#132
    Loom-Trace-Id: fb078570ebefff41f2c94dd389f2adc9
    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
2026-10-11 sim: two-injection (Middlebrook) loop-gain benches, reconstruction and campaign driver
    A single voltage injection at a MOSFET gate assumes zero AC gate current;
    above the in-band crossing that premise degrades exactly where the #128
    record's +1 dB plateau sits. Add the measurement that can tell the two
    stories apart, with its validation, before any grid run:
    - tb_loopgain2v_cmos5l.spice.tmpl: the #21 break circuit verbatim, exporting
    the raw complex probes v(fb), v(fbamp) instead of their ratio.
    - tb_loopgain2i_cmos5l.spice.tmpl: loop intact behind a 0 V ammeter
    (Vmeas FB FBAMP), shunt AC current injected into the driven side (Iinx
    0 FBAMP), so both the source and the load impedance a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
2026-10-11 docs: complete README repo-layout block and regenerate signoff evidence (#147)
    Loom-Story: 2AMLogic/sg13g2-ldo#147
    Loom-Trace-Id: 8e84b96fd3f0af6b278f206f7b13a289
    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
2026-10-11 spec: DR-0016 keeps in-tree error amplifier; reuse.lock evaluate -> kept (#146)
    Loom-Story: 2AMLogic/sg13g2-ldo#146
    Loom-Trace-Id: 365840bdd535f8642b3a4a54f9dd816f
    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
2026-10-11 sim: two-injection loop-gain fleet record 20261011-165616-eabde108 (45 points x 3 benches), driver/checker fixes, signoff regenerated (#135)
    The single-injection +1 dB plateau equals the loading ratio |u| of the
    broken bench to 2e-8 dB at all 45 points; the reconstructed loop gain has
    one 0 dB crossing and no plateau. DR-0014 rules unchanged; row 10 Open.
    Loom-Story: 2AMLogic/sg13g2-ldo#135
    Loom-Trace-Id: 59bb4e5505fdea47793dcfe9d0998b05
    Loom-Build: 0.19.1068 fcc4454e112d13e088464bb0a178b75c0dc96c0f clean
2026-10-11 sim: two-injection loop gain is Middlebrook's general T; resolution-bounded, no clamp (#135, review #151)
    Addresses the Judge's blocking findings on PR #151:
    1. loopgain2.py now computes Middlebrook's general (bilateral) loop gain
    T = (Tv*Ti - 1)/(Tv + Ti + 2), Tv = -v(fb)/v(fbamp), Ti = -i_m/(1 + i_m),
    derived in the README from the break two-port
    (T = (y12 - y21)/(y11 + y22 + 2 y21); 1 + T vanishes at the closed-loop
    poles). The previous L = -T' (unloaded transfer) is withdrawn.
    2. The tautological evidence (L_single - L_two = u, the loading-explain
    bound) is removed. Checks that can fail remain or are new: Tv vs the
    control deck, and T vs the control below f_ugf/10 (nee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
2026-10-11 layout: add an SG13G2 HBT vendor-fixture extraction/LVS probe (issue #150)
    Vendors IHP's npn13G2 LVS unit fixture (GDS + CDL, Apache-2.0 attribution,
    byte-identical to IHP-Open-PDK 5e6d592e) and adds a three-mode probe
    (--record/--check/--run) that witnesses the upstream sg13g2 bipolar
    extraction gap on the pinned layout build (klt 0.5.0+gb15edf5e3a2e,
    KLayout 0.30.12, deck sha256:894326a4...): DRC clean/0 inside the curated
    deck's incomplete coverage, extract extracted/0 devices (the deck declares
    no bipolar class), LVS mismatch 0/3/0 against the vendor reference.
    --check is stdlib-only: it re-hashes every committed input, chain-checks
    the raw reports, re-verifies tool/deck pins and regene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
2026-10-11 chore: resync installed Loom surfaces
    <!-- loom:provenance v1 build=unknown b37a005ac1889262fb9e5338f7cff4e9ed4987da clean prompts=none sweep=none story=none trace=25c158d7e9591610b251780caaff1c5f host=robb-pro base=9bf39eb314844e96a460499a35f8d1fd72bb2e19 run=loom-run/v1:timer:robb-pro/fleet-resync:7f020bca-6920-47f7-a5e4-bbd5c82d9bb8 installs=0.19.1072 29b48db1ead9c4501304e0114a5c33310e1d589f -->
    Loom-Trace-Id: 25c158d7e9591610b251780caaff1c5f
    Loom-Build: unknown b37a005ac1889262fb9e5338f7cff4e9ed4987da clean
    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
2026-10-11 docs: refresh work log and current Loom queue
2026-10-11 chore: resync installed Loom surfaces
    <!-- loom:provenance v1 build=unknown 81a6b4499cb57b3620785bc1625c300da34f0735 clean prompts=none sweep=none story=none trace=d08bbd290651d7bcbda8b216c0dfbcdf host=robb-studio base=9cfc13c74914b0826ccd34b8028d42bb474cecf7 run=loom-run/v1:timer:robb-studio/fleet-resync:71e05e3d-931c-46b4-b6d2-5f3f992c1e19 installs=0.19.1073 abb0872ba7d1d3f6f3a14f71f51a562e89308181 -->
    Loom-Trace-Id: d08bbd290651d7bcbda8b216c0dfbcdf
    Loom-Build: unknown 81a6b4499cb57b3620785bc1625c300da34f0735 clean
    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
2026-10-12 chore: resync installed Loom surfaces
    <!-- loom:provenance v1 build=unknown be358990895362019614bd207bcbe36bc9eeff2c clean prompts=none sweep=none story=none trace=f1dc643b95859c8f26e892ddb5e2c5d7 host=robb-studio base=5d65763510a9845489f031f95f43a50e6e697d7b run=loom-run/v1:timer:robb-studio/fleet-resync:da486ca2-3e94-4a85-abd3-88707942489a installs=0.19.1087 51ac271f990b317a52ebf27cc21f34561e1179fb -->
    Loom-Trace-Id: f1dc643b95859c8f26e892ddb5e2c5d7
    Loom-Build: unknown be358990895362019614bd207bcbe36bc9eeff2c clean
    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
2026-10-12 docs: update work log and plan from current Loom backlog
2026-10-12 chore: resync installed Loom surfaces
    <!-- loom:provenance v1 build=unknown a579728c137cc11d08a48b178e0ff9aa21683e72 clean prompts=none sweep=none story=none trace=3bf998139b24cf65d1c2b90af6a12450 host=loom-worker-3 base=a015f941fdfb5271e97ee9af3d1db70a4cad665e run=loom-run/v1:timer:loom-worker-3/fleet-resync:5b8ee6fae8b4401a862c5e98cad72b45 installs=0.19.1087 51ac271f990b317a52ebf27cc21f34561e1179fb -->
    Loom-Trace-Id: 3bf998139b24cf65d1c2b90af6a12450
    Loom-Build: unknown a579728c137cc11d08a48b178e0ff9aa21683e72 clean
    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
2026-10-12 build: re-stamp SG13CMOS5L PDK pin to IHP-Open-PDK dev f7bca326 (#155)
    Pin sim/pdk-cmos5l.json, sim/env.sh, CI (immutable klayout-tools fetch-script
    ref + matching cache pin) and docs; build-osdi.sh builds cap_cmomi/cap_cmomf
    for ihp-sg13cmos5l; startup_campaign reads .fetched-version.
    Loom-Story: 2AMLogic/sg13g2-ldo#155
    Loom-Trace-Id: 43c47e448d9909ab9177807247f20c79
    Loom-Build: 0.19.1081 6966a93d1cd1b005f2a6b22bf9691ade8793ed73 clean
2026-10-12 sim: re-run SG13CMOS5L PVT campaign on IHP-Open-PDK dev f7bca326 (#155)
    Append records 20261012-042925-c53f0177 (INCOMPLETE, fleet cap) and
    20261012-060932-c53f0177 (214/214, all result CSVs identical to
    20261011-070111-5391c68). run_sweep.sh reads the installed revision from
    .fetched-version instead of hard-coding the superseded commit.
    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
2026-10-12 sim: re-run SG13CMOS5L startup nominal+grid campaign on f7bca326 (#155)
    Append record 20261012-063918-bb1d73c (135 points, same verdicts as the
    selected 20261011-070146-0c95530; metrics agree to <=1e-6 relative).
    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
2026-10-12 sim: re-run SG13CMOS5L DR-0012 dropout campaign on f7bca326 (#155)
    Append record 20261012-065435-b53a442f (45/45 resolved, definitive).
    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
2026-10-12 sim: re-run SG13CMOS5L two-injection loop-gain campaign on f7bca326 (#155)
    Append record 20261012-071449-6a3c1475 (135/135 points; comparison CSV
    identical to 20261011-165616-eabde108).
    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
2026-10-12 sim: re-run SG13CMOS5L enable-interface smoke requests on f7bca326 (#155)
    Append record 20261012-072500-01e2fc6 (12 requests, derived.txt/summary.csv
    identical to 20261011-031743-df3f802).
    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
2026-10-12 sim: EN-enabled row-2 one-corner smoke on f7bca326 (#155)
    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
2026-10-12 sim: re-run SG13CMOS5L dynamic DoE base matrix on f7bca326 (#155)
    Append record 20261012-074813-c94873ba (384 sims, 178 ok / 14 failed, same
    failure set as 20261010-091123-a31c626, which ran on the pre-#89 netlist).
    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
2026-10-12 chore: resync installed Loom surfaces
    <!-- loom:provenance v1 build=unknown 02ecafe7734bf5faa945ce88940589f00eca78e9 clean prompts=none sweep=none story=none trace=5f71c537126994dc4c45179122427514 host=robb-pro base=ddb94a88aef397be3294bddf2607cb841a1603f9 run=loom-run/v1:timer:robb-pro/fleet-resync:6293e6da-8a67-45aa-b277-c9ef85ddb810 installs=0.19.1101 27422582cd2d34d8ed5f60ce987007bc4bd61081 -->
    Loom-Trace-Id: 5f71c537126994dc4c45179122427514
    Loom-Build: unknown 02ecafe7734bf5faa945ce88940589f00eca78e9 clean
    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
2026-10-12 sim: re-run SG13CMOS5L dynamic DoE refinement round on f7bca326 (#155)
    Append record 20261012-080951-142dac4a (688 more sims; 536 points, 490 ok /
    46 failed, same counts as 20261010-101245-6df50fd).
    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
2026-10-12 docs: PDK re-stamp migration inventory, layout re-run log, README notes (#155)
    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
2026-10-12 signoff: refresh inventories, characterization envelope and T1 report after the #155 edits
    Regenerated per signoff/README.md#regenerating with the pinned grader
    (0.7.0+gb82427b30c96); only content_hash pins moved, item statuses and exit 3
    (non-T1) are unchanged, and the committed report reproduces.
    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
2026-10-12 chore: resync installed Loom surfaces
    <!-- loom:provenance v1 build=unknown 24e88efb2654d92588617d2e0681d2ceba48990d clean prompts=none sweep=none story=none trace=9ff02282641e95f0266bab1c719ccf6d host=loom-worker-3 base=64e9590275b95da99e37c3df1bba991bb07318ce run=loom-run/v1:timer:loom-worker-3/fleet-resync:616e7cf481ff483ea62a90e9c8640d85 installs=0.19.1104 ded8b3776e361563cf636d3a439737715c13b6d5 -->
    Loom-Trace-Id: 9ff02282641e95f0266bab1c719ccf6d
    Loom-Build: unknown 24e88efb2654d92588617d2e0681d2ceba48990d clean
    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
2026-10-12 chore: resync installed Loom surfaces
    <!-- loom:provenance v1 build=unknown 9885e6bbba36f53328e04be83140734c6eda9f58 clean prompts=none sweep=none story=none trace=72f34c4066d6ca844a10c33035a775bd host=loom-worker-1 base=6bcbb6cf6234174d990601a88c8601d398baa9b3 run=loom-run/v1:timer:loom-worker-1/fleet-resync:8f5732bc51fd43379e17e0de51e86bae installs=0.19.1108 72427939d156341080a7006ae6fbb5ec96b2368e -->
    Loom-Trace-Id: 72f34c4066d6ca844a10c33035a775bd
    Loom-Build: unknown 9885e6bbba36f53328e04be83140734c6eda9f58 clean
    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
2026-10-12 chore: resync installed Loom surfaces
    <!-- loom:provenance v1 build=unknown 01467247f32c59822968bf02d3214d9a3d613452 clean prompts=none sweep=none story=none trace=0e97e9733eef09a33959cf96e6271f40 host=robb-studio base=934dbd7c2e4c902a1b1628257c974125b554a876 run=loom-run/v1:timer:robb-studio/fleet-resync:53a4d390-3842-4216-9018-5dced9d0ea17 installs=0.19.1109 d9498fcd419776b2517e30b99c88e76bbe92d2f4 -->
    Loom-Trace-Id: 0e97e9733eef09a33959cf96e6271f40
    Loom-Build: unknown 01467247f32c59822968bf02d3214d9a3d613452 clean
    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
2026-10-12 sim: second #155 increment -- EN-deck Monte Carlo, startup ext/halfstep, PDK-only controls, re-reductions on the new pin
    Part of #155. New append-only records on the batch fleet: row-2 MC
    20261012-093854-934dbd7 (first EN-design record), startup ext/halfstep
    stages of 20261012-063918-bb1d73c, dropout control 20261012-094155-934dbd7c
    (pre-#89 netlists, new pin) and DoE controls 20261012-100716/102846-934dbd7c
    (current netlists, old install). Row-10 classification of the new PVT
    record; migration-155-rereduce.py (+ CI --check) for the item-5 and DoE
    row-10 re-reductions and the control comparisons. Commits the layout
    re-run log the first increment cited but did not commit. Signoff
    inventories,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
2026-10-12 sim: E1 DC operating-point campaign for DR-0015 (issue #158)
    Measure the device operating points DR-0015's class-1 analysis had to
    infer, at its four selected points P1/P2/P5/P6, on the current design
    bytes and PDK pin:
    - tb_e1op_cmos5l.spice.tmpl: the flattened loop-gain bench's circuit
    (zero-current FB/FBAMP break, so its DC OP is the closed loop's) plus
    the non-invasive divider replica and a .save card exporting per-MOS
    ids/gm/gds, pass-device cgs/cgd/cdd/vth and XMn3 cgs/cgd; a 3-point DC
    sweep brackets Vin=3.30 V and the middle row is the operating point.
    - run_e1op.sh: one batch-fleet request, the four DR-0015 corners; no
    local grid (--validate is a single tt/27C debug probe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
2026-10-12 e1op: fail closed off-pin; derive record provenance from what ran
    run_e1op.sh now reads the resolved PDK install's version marker
    (.fetched-version, else git rev-parse) and refuses to run unless it
    equals sim/pdk-cmos5l.json's pinned_commit; the manifest's pdk column
    is derived from that read instead of a hard-coded literal, so a record
    can no longer describe a pin other than the install that actually ran.
    e1_oppoints.py record-md now quotes the manifest's pdk column (what
    the run reported) rather than asserting a pin, and points the
    design-netlist hash at inputs.sha256.json (the manifest carries the
    deck-snapshot hashes, not the design netlists').
    batch_backend parse_deck accepts 'save al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
2026-10-12 e1op: E1 re-run on the pinned PDK install; drop off-pin record
    The first E1 record (20261012-110804-934dbd7c, job klt-sim-b8248ab15091)
    was generated with PDK_ROOT resolving to ~/share/pdk/ihp-sg13cmos5l --
    the superseded 607e18d4 install (old .git-based tree) -- while the
    record md, manifest, README, DR-0015 addendum and PR body all claimed
    the current pin f7bca326. The staged inputs and OSDI hashes in that
    record prove the mismatch (cap_cmomi/cap_cmomf are the old install's
    builds, 9e16967.../006ebb9..., not the new-pin 61491e7.../52ce5c9...).
    The record never landed on main, so it is dropped here rather than
    relabelled (a 607e18d4 record would not meet issue #158's pinned-PDK
    acceptance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
2026-10-12 e1op: re-point the record at the rebased tree (fresh id, fresh fleet job)
    The rebase onto origin/main (d8c6fa4b) changed this branch's commit
    SHAs, which left the intermediate record's embedded git sha (405078c7)
    dangling and its references stale. Record 20261012-114732-405078c7 is
    dropped (never landed) and E1 re-run as one batch-fleet request on the
    rebased tree: record 20261012-115531-cfa681f9, job klt-sim-043a7dd1431f,
    4/4 points, same numbers, same verified pin provenance (manifest pdk
    column f7bca326, new-pin OSDI sha256s).
    README E1 section, DR-0015 addendum and the CI byte-check step now cite
    the new record; signoff regenerated in the documented order (inventories,
    characterization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
2026-10-12 chore: resync installed Loom surfaces
    <!-- loom:provenance v1 build=unknown acadc2b4b0e852f2d889ac9dec616e1548705802 clean prompts=none sweep=none story=none trace=a69edb348af7f0e67b3bc77bc33b1bfc host=loom-worker-2 base=83a112ad6a9b6fafd37dda14bc26a9c610d3c702 run=loom-run/v1:timer:loom-worker-2/fleet-resync:0923627ffda84cf69ec2486475772b10 installs=0.19.1126 7736d1276b6d01778fba3461114c858ef1bf5e2d -->
    Loom-Trace-Id: a69edb348af7f0e67b3bc77bc33b1bfc
    Loom-Build: unknown acadc2b4b0e852f2d889ac9dec616e1548705802 clean
    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
2026-10-12 chore: resync installed Loom surfaces
    <!-- loom:provenance v1 build=unknown 8d832cc8035d4ba07872510416468da0790332cd clean prompts=none sweep=none story=none trace=09a53bf60e96fc30a753caffd1de8c92 host=robb-studio base=6df7d3470e752af83cac3ea45cb8d0dbc7ffb3f1 run=loom-run/v1:timer:robb-studio/fleet-resync:baf4c30c-65d9-4d4e-a740-f6a80cbb975c installs=0.19.1133 fd7af6d7adbad876821d49bff2c70c871f54b60c -->
    Loom-Trace-Id: 09a53bf60e96fc30a753caffd1de8c92
    Loom-Build: unknown 8d832cc8035d4ba07872510416468da0790332cd clean
    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
2026-10-12 chore: resync installed Loom surfaces
    <!-- loom:provenance v1 build=unknown aa1ed0d7d5499d2705977d971673d919dbbbaf4e clean prompts=none sweep=none story=none trace=2522608826ef5d5e4a88a9667055aeb7 host=loom-worker-2 base=764e2cb39cdfad2a57e09f585b0fd8b8970df631 run=loom-run/v1:timer:loom-worker-2/fleet-resync:8f26b719c712455381744111c50e90b4 installs=0.19.1142 b91ae5d1b5204f499a1abb875a6cf5bffc1d90b1 -->
    Loom-Trace-Id: 2522608826ef5d5e4a88a9667055aeb7
    Loom-Build: unknown aa1ed0d7d5499d2705977d971673d919dbbbaf4e clean
    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
2026-10-12 chore: resync installed Loom surfaces
    <!-- loom:provenance v1 build=unknown 8b64614d017d6ce7491c3a2ac9da51e5e2901c97 clean prompts=none sweep=none story=none trace=66044c049ba635bcd6a4797c3a77e84b host=robb-pro base=535eca2379365eef19170c6c9c5b1f07cbb36eda run=loom-run/v1:timer:robb-pro/fleet-resync:68f56594-05d0-4cc0-9c07-36263359d698 installs=0.19.1144 9e4381cbbd2386393e44c7a979583252948a3998 -->
    Loom-Trace-Id: 66044c049ba635bcd6a4797c3a77e84b
    Loom-Build: unknown 8b64614d017d6ce7491c3a2ac9da51e5e2901c97 clean
    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
2026-10-13 chore: resync installed Loom surfaces
    <!-- loom:provenance v1 build=unknown e66f00108a9519331aa981da8a01c6569ca623a9 clean prompts=none sweep=none story=none trace=d3e476cf8c03d5ed37f8e146b3632190 host=robb-studio base=f6d73af2d4a4efd03dd6e1b6e3778ea0dc77ee15 run=loom-run/v1:timer:robb-studio/fleet-resync:1d7ace45-2daf-4c92-a752-67b11e982245 installs=0.19.1146 972552531e3e890528f13c6cc8fb7406877c96f9 -->
    Loom-Trace-Id: d3e476cf8c03d5ed37f8e146b3632190
    Loom-Build: unknown e66f00108a9519331aa981da8a01c6569ca623a9 clean
    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
2026-10-13 chore: resync installed Loom surfaces
    <!-- loom:provenance v1 build=unknown 98d08ab78cc223361354ee9947d996b1cb914b30 clean prompts=none sweep=none story=none trace=8b73addcdeaa8fbd65998649f42a8c50 host=loom-worker-2 base=cade0f0b34ff5a93c06920239703d96c6901c224 run=loom-run/v1:timer:loom-worker-2/fleet-resync:3bfb13d52fca425f9cfced4541954cb6 installs=0.19.1148 1448fdfa79ac2dcab7fad6b95b72697b450f2a4a -->
    Loom-Trace-Id: 8b73addcdeaa8fbd65998649f42a8c50
    Loom-Build: unknown 98d08ab78cc223361354ee9947d996b1cb914b30 clean
    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
2026-10-13 chore: resync installed Loom surfaces
    <!-- loom:provenance v1 build=unknown d0bfbbc7ac309581d7abe02c4a269c7704010ee0 clean prompts=none sweep=none story=none trace=0ad6d167235000f3b5648cbd63d761ce host=robb-pro base=1fbcebe0913949f9407fe6b8ddae57e9d3dac25f run=loom-run/v1:timer:robb-pro/fleet-resync:4f7cbe22-40b6-49ff-8811-003ae8577c28 installs=0.19.1151 021b947d121929157cd83df0576e7f2aa12500d7 -->
    Loom-Trace-Id: 0ad6d167235000f3b5648cbd63d761ce
    Loom-Build: unknown d0bfbbc7ac309581d7abe02c4a269c7704010ee0 clean
    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
2026-10-13 chore: resync installed Loom surfaces
    <!-- loom:provenance v1 build=unknown 7916c4043a1b57e97a53bc5c111e74c5038a1091 clean prompts=none sweep=none story=none trace=20b27ffb08c4130dc9836ee8d9d97b97 host=loom-worker-2 base=82609a18dd3b8aa892f5b7fbad3ecac910f01780 run=loom-run/v1:timer:loom-worker-2/fleet-resync:d34532ec625a4162ae8b58dde1a6738f installs=0.19.1151 f7d1deaab02a9c483fce1ced33fadb1af6d86f59 -->
    Loom-Trace-Id: 20b27ffb08c4130dc9836ee8d9d97b97
    Loom-Build: unknown 7916c4043a1b57e97a53bc5c111e74c5038a1091 clean
    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
2026-10-13 chore: resync installed Loom surfaces
    <!-- loom:provenance v1 build=unknown ac0bbcf6eda99918e88a0b8893d9762b106a2e45 clean prompts=none sweep=none story=none trace=8597ab8a51d68f9f8ee864fa71904bff host=robb-studio base=0d45d520b06821e94f8244e93b63c498cb167fb8 run=loom-run/v1:timer:robb-studio/fleet-resync:2ea9dd71-a6b2-4d0c-86aa-859a0728c9b3 installs=0.19.1151 f7d1deaab02a9c483fce1ced33fadb1af6d86f59 -->
    Loom-Trace-Id: 8597ab8a51d68f9f8ee864fa71904bff
    Loom-Build: unknown ac0bbcf6eda99918e88a0b8893d9762b106a2e45 clean
    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
2026-10-13 chore: resync installed Loom surfaces
    <!-- loom:provenance v1 build=unknown 7916c4043a1b57e97a53bc5c111e74c5038a1091 clean prompts=none sweep=none story=none trace=99a9d442e177e2a14f9fe891925a70a9 host=loom-worker-1 base=8a0f747676d088d83be88492c71eeda923ba492c run=loom-run/v1:timer:loom-worker-1/fleet-resync:c61893183c38452a8cff7a1b196057af installs=0.19.1151 f7d1deaab02a9c483fce1ced33fadb1af6d86f59 -->
    Loom-Trace-Id: 99a9d442e177e2a14f9fe891925a70a9
    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
2026-10-13 chore: resync installed Loom surfaces
    <!-- loom:provenance v1 build=unknown 7916c4043a1b57e97a53bc5c111e74c5038a1091 clean prompts=none sweep=none story=none trace=773e9e41a5730d2f79f2381ad2cde068 host=robb-pro base=cb03bc05f5c40d9d7ddcf6a1bbc956b4fadc87a2 run=loom-run/v1:timer:robb-pro/fleet-resync:b7ca0d34-434e-4536-85b9-57adfa603a8d installs=0.19.1151 1ec34f9bb79942506958a3c18a31368f4e065508 -->
    Loom-Trace-Id: 773e9e41a5730d2f79f2381ad2cde068
    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
2026-10-13 chore: resync installed Loom surfaces
    <!-- loom:provenance v1 build=unknown f57244868aa20ef22c18aa8025972184aaea43e4 clean prompts=none sweep=none story=none trace=8e03b78fe6cb43a017c4a4823362ffa7 host=loom-worker-2 base=fccb38699ece2fa61c1571134042f6bcb121cdc3 run=loom-run/v1:timer:loom-worker-2/fleet-resync:eb553d2fc2a54589aa37879f12b18ed5 installs=0.19.1151 a9d9bfc13e966655d6d847cb6876af523bc4a4c4 -->
    Loom-Trace-Id: 8e03b78fe6cb43a017c4a4823362ffa7
    Loom-Build: unknown f57244868aa20ef22c18aa8025972184aaea43e4 clean
    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
2026-10-13 chore: resync installed Loom surfaces
    <!-- loom:provenance v1 build=unknown 6fe43c87955e02019c2bc8dfad4fbd160b89170c clean prompts=none sweep=none story=none trace=49a4590bf54e81899c26d965f682504c host=robb-studio base=bb2f3fd41d0209672a3b672038394315a610f68d run=loom-run/v1:timer:robb-studio/fleet-resync:459197b3-0050-4335-893e-e47b638eb819 installs=0.19.1151 d1d2dd6e9b17b05d0e718dc7b712685c24dd979d -->
    Loom-Trace-Id: 49a4590bf54e81899c26d965f682504c
    Loom-Build: unknown 6fe43c87955e02019c2bc8dfad4fbd160b89170c clean
    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
2026-10-13 chore: resync installed Loom surfaces
    <!-- loom:provenance v1 build=unknown 5dc3a07d084d0ec4034f0782d572925dcad86af7 clean prompts=none sweep=none story=none trace=cbc11657acadf58858409fe543c342e1 host=robb-pro base=2e044bd62ca560c38842ab2243318dfba4f57682 run=loom-run/v1:timer:robb-pro/fleet-resync:be586137-d91e-4e2c-82d6-3164d43aa9de installs=0.19.1152 2d5fe17958dca799058f16bdd74a12336990bec0 -->
    Loom-Trace-Id: cbc11657acadf58858409fe543c342e1
    Loom-Build: unknown 5dc3a07d084d0ec4034f0782d572925dcad86af7 clean
    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
2026-10-13 chore: resync installed Loom surfaces
    <!-- loom:provenance v1 build=unknown 27a266d5a27885323290840d2a837d73fcf4bcc6 clean prompts=none sweep=none story=none trace=e77cdd5477ef6bfc65fba6cc233788e0 host=loom-worker-2 base=d1337915474f5b2cdb80500ff0189410c137a75f run=loom-run/v1:timer:loom-worker-2/fleet-resync:7fac7d82f298441a91761382ac989183 installs=0.19.1152 8d16eec5f10d705602ac4d1ab871c57266f1aa45 -->
    Loom-Trace-Id: e77cdd5477ef6bfc65fba6cc233788e0
    Loom-Build: unknown 27a266d5a27885323290840d2a837d73fcf4bcc6 clean
    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
2026-10-13 chore: resync installed Loom surfaces
    <!-- loom:provenance v1 build=unknown f2b62a2cf576d7d37092147b2281da809f8b5cf5 clean prompts=none sweep=none story=none trace=8adfa75521c72dded43e2932febb6329 host=loom-worker-3 base=9760a601f8da893b141e280a4249d0088a5104af run=loom-run/v1:timer:loom-worker-3/fleet-resync:8a8198f8f80e4703bc7365a5e10595e0 installs=0.19.1152 a7c20e591a04d4acaeeca29fadd7fa4be7ca3122 -->
    Loom-Trace-Id: 8adfa75521c72dded43e2932febb6329
    Loom-Build: unknown f2b62a2cf576d7d37092147b2281da809f8b5cf5 clean
    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
2026-10-13 chore: resync installed Loom surfaces
    <!-- loom:provenance v1 build=unknown 84d11f248d368cae5e04a2255f6897a406c50089 clean prompts=none sweep=none story=none trace=8e50b4ccc3dc58f709a732f69d58fd44 host=robb-studio base=b847f011930d1d8d824a8eb411f98274ae3d08d0 run=loom-run/v1:timer:robb-studio/fleet-resync:05c9f3b1-eee2-412f-8996-5fbf02793d9e installs=0.19.1153 d8429a4fabdc955107af1cbc22c548e23eecf9b1 -->
    Loom-Trace-Id: 8e50b4ccc3dc58f709a732f69d58fd44
    Loom-Build: unknown 84d11f248d368cae5e04a2255f6897a406c50089 clean
    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
2026-10-15 docs(spec): DR-0017 proposed SG13CMOS5L current-limiter plan for row 8
    Add a proposed decision record with the limiter topology, device
    mapping, sizing equations, error budget, EAOUT integration, consumer
    inventory and validation specification (135-point grid, DC and
    transient protocols, terminal-stress, thermal and recovery criteria).
    The sibling reference is pinned to gf180-ldo d83daea0.
    The threshold uses an rhigh unit ratio (Rref = 32 units in series,
    Rsns = 20 in parallel) and Iref = IBIAS/2, so global rhigh spread
    (2.44:1 measured over PVT) cancels. The 65-80 mA target is kept.
    No schematic, netlist, bench, layout, target or record changes. Row 8
    stays Open. A pointer is added to spe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
2026-10-19 feat(layout): add extraction-only pex stage and committed klt pex report
    Adds `layout/run_flow.sh pex`: klt pex --extract-only on the committed GDS,
    pinned to a klayout-tools commit via uvx, plus pex_check.py binding the report
    to its netlist and a perturbed-netlist negative control. Documents the
    extraction model and body_bias in layout/README.md. Refreshes the item-2
    inventory pin that README.md edit moves (grade unchanged, exit 3).
2026-10-20 feat(sg13cmos5l): add ldo_ilimit_cmos5l current limiter and instantiate it in the core
    Adds the DR-0017 sense-replica limiter cell (candidate sizing), one Xilim
    instance in ldo_core_cmos5l, regenerated netlists, a limiter section in
    design/README.md, nominal smoke decks under sim/ldo-cmos5l-ilimit/, and
    reconciles DR-0017's Status line to accepted-for-bounded-development per the
    2026-10-19 operator ruling. Row 8 stays open; nothing is ratified.
2026-10-20 test(sg13cmos5l): record nominal limiter smoke run and regrade signoff honestly
    Adds the tt/27C/3.30V forced-VOUT, closed-loop load and EN-low smoke record
    for ldo_ilimit_cmos5l, inventories the new cell and decks, and regenerates
    the signoff and characterization outputs with the pinned grader. Adding the
    limiter to the core netlist makes every selected PVT/startup record stale
    against the design, so item 8 grades unmet (7/11 met, exit 3); the grid is
    not re-run here.
2026-10-23 ci: pin characterization-report to ubuntu-24.04
    The committed loopgain2 report stopped reproducing when ubuntu-latest
    rolled to ubuntu-26.04. Pin the job to the last-green image and refresh
    the ci.yml-derived signoff pins (item 10 inventory/envelope, manifest,
    T1 report; exit 3 unchanged).
    Closes #185
2026-10-24 ci: also pin pass-device-screening-check to ubuntu-24.04
    Folds #188 (issue #186) into this PR per the maintainer's consolidate
    decision; regenerate signoff inventories and T1 report once.
2026-10-24 docs(spec): record row 4 branch status in DR-0018, leave DR-0007 bytes unchanged (#71)
    Adds the dated branch-difference clarification as a follow-on record so the
    item-5 evidence pin on DR-0007 stays valid. Links it from README and
    spec/README; regenerated inventories, characterization and T1 report
    (exit 3, 8 met, non-T1).
2026-10-24 fix(sg13cmos5l): re-scope limiter to a standalone cell per #165 ruling
    Core schematic/netlist match main (no Xilim). Smoke decks use a
    testbench-local ldo_core_ilim_tb wrapper; new append-only record
    20261024-104953-bc514a43 (measurements identical to the prior record).
    DR-0017 note defers integration to #190. Signoff inventories, envelope
    and T1 report regenerated with the pinned grader (exit 3, 8/11 met).
2026-10-27 build: bump klayout-tools pins to the 0.8.0 release and regenerate evidence
    Move every klt pin (CI signoff/layout installs, PDK-fetch ref, run_flow.sh
    pex stage, HBT probe expectations) from dev commits to klayout-tools 0.8.0.
    Regenerate the layout reports, HBT probe baseline, signoff inventories and
    T1 report under it; verdicts are unchanged (LVS match, DRC/ERC clean, T1
    exit 3 with the same items met).
    Adapt the LVS flow to 0.8.0: pass layout/reference deck for X-card
    resistors and caps, state the 0.8.0 rhigh model in the reference, defer the
    extract-time resistor offset, and reject negative controls that fail only
    through a malformed request.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
2026-10-27 fix(netlist): declare ldo_ilimit_cmos5l as pending integration (#190) instead of failing netlist --check
    The standalone limiter is deliberately not instantiated in ldo_core_cmos5l
    (#165 ruling 2026-10-24, DR-0017). Add a per-design pending_integration map
    naming the cell and its integrating issue. The cell keeps every symbol,
    schematic and port-order check; a stale entry fails once the core
    instantiates the cell. Regenerate signoff evidence with the pinned grader.
2026-11-06 ci: re-run committed klt yield verdicts in monte-carlo-record
    Install klayout-tools[yield] so the klt-yield contract tests run (a skip
    fails the job) and add check_yield_verdicts.py, which re-runs klt yield on
    each committed samples document and fails on exit-code, status, yield-block
    or negative-control drift. Signoff inventories and T1 report regenerated.
2026-11-10 ci: gate attribution yield verdicts; supersede two klt 0.7.0 reports by name
    Drop the attribution exemption from check_yield_verdicts.py. The two
    tt_nom_27C attribution reports committed from klt 0.7.0 are re-derived
    offline under the pinned klt 0.8.0 into rederived/ (records untouched) and
    named in SUPERSEDED; the gate requires the re-derived copy, byte-identical
    samples, and that it reproduces. Refresh the item-9 inventory and T1 report.
